Wassau/G1_Project_Rover2026/MODELOS COMPONENTES COMERCIALES/Seta Emergencia/E-Stop Yellow Ring Label.JPG

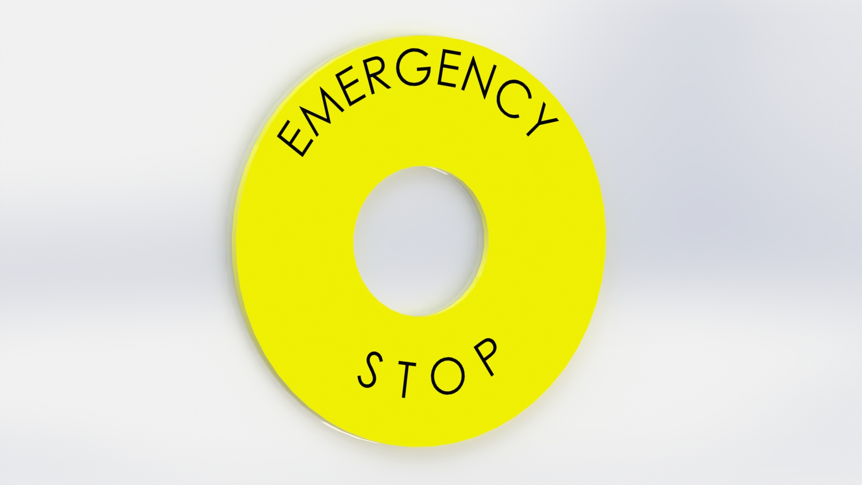
MODELOS COMPONENTES COMERCIALES/Seta Emergencia/E-Stop Yellow Ring Label.JPG
