Wassau/G1_Project_Rover2026/MODELOS COMPONENTES COMERCIALES/rc-short-course-tire-rim-1-10-scale-off-road-12mm-hex-1.snapshot.1/wheel.jpg

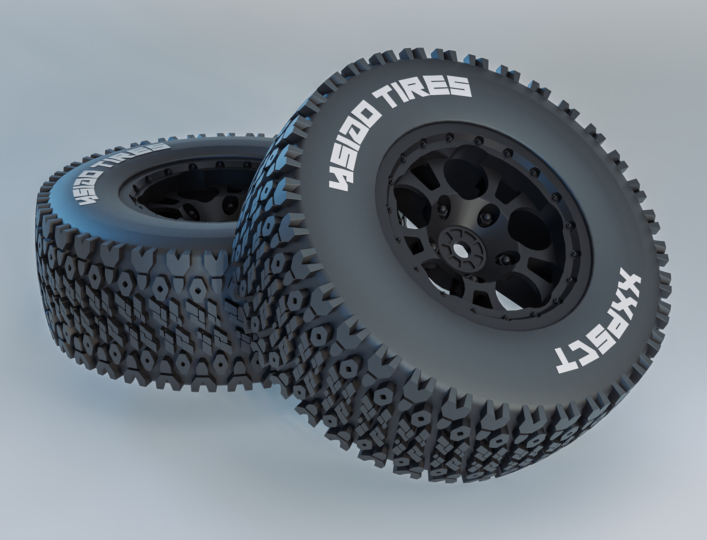
MODELOS COMPONENTES COMERCIALES/rc-short-course-tire-rim-1-10-scale-off-road-12mm-hex-1.snapshot.1/wheel.jpg
