Wassau/G1_Project_Rover2026/README.md

# G1_Project_Rover2026
Diseños, código y espacio colaborativo para acceder a los archivos de trabajo en el proyecto del curso
