Wassau/G1_Project_Rover2026/GrupoDirección/Sintesis Direccion Optimizada/Modelado, síntesis y simulación-20260307/Síntesis dimensional/Síntesis dimensional de robot antropomórfico paralelo.pdf

# Síntesis dimensional de robot antropomórfico paralelo

## Desarrollo de Prototipo Mecatrónico (DPM)

## Máster en Mecatrónica

EU4M Master in Mechatronic and Micro-Mechatronic Systems

Álvaro Noriega González | 2

## INDICE

## 1. Especificaciones 2. Síntesis dimensional 3. Manipulabilidad

## 1. Especificaciones

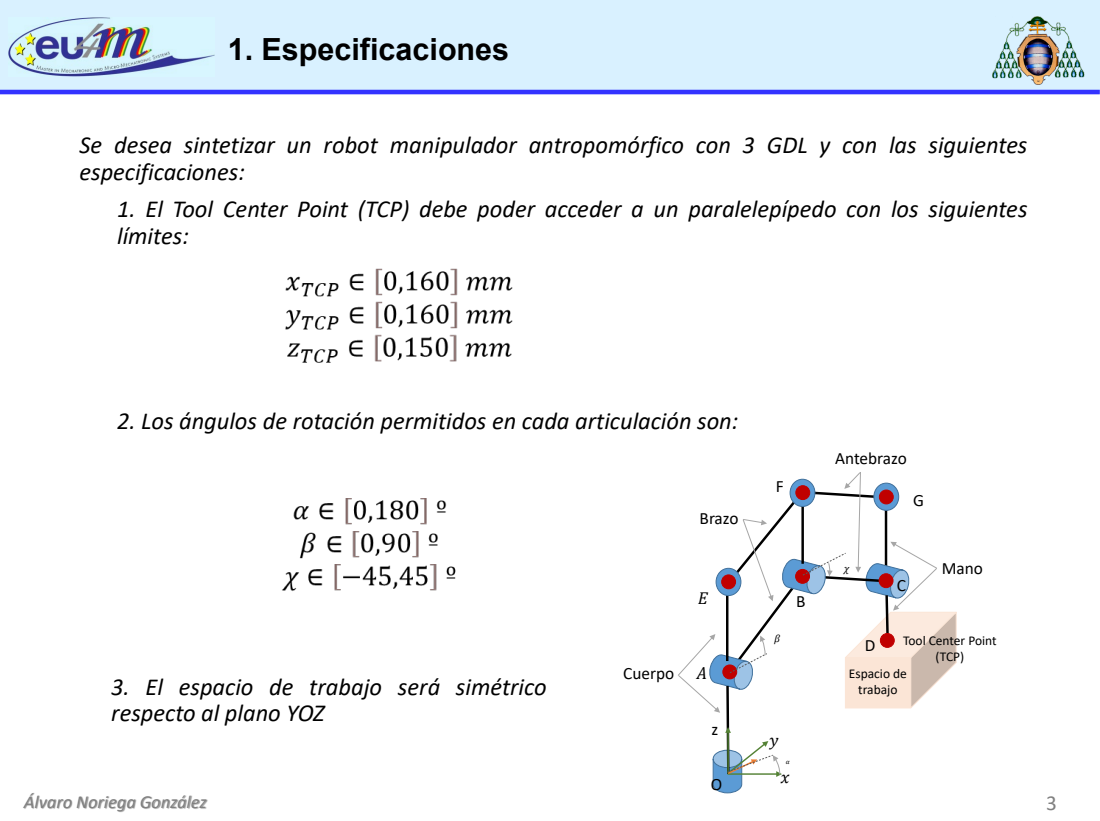
[picture p16: page 3]
Espacio de trabajo; Cuerpo; Brazo; Antebrazo; Mano

Se desea sintetizar un robot manipulador antropomórfico con 3 GDL y con las siguientes
especificaciones:
1. El Tool Center Point (TCP) debe poder acceder a un paralelepípedo con los siguientes
límites:

2. Los ángulos de rotación permitidos en cada articulación son:

Tool Center Point
(TCP)

3. El espacio de trabajo será simétrico
respecto al plano YOZ

El robot manipulador tipo antropomórfico tiene la particularidad de que los eslabones principales que forman el brazo están contenidos todos en el mismo plano de trabajo. Por tanto, se puede tratar como un mecanismo plano contenido en dicho plano, lo cual simplifica considerablemente la síntesis cinemática del mismo.

## 2. Síntesis dimensional

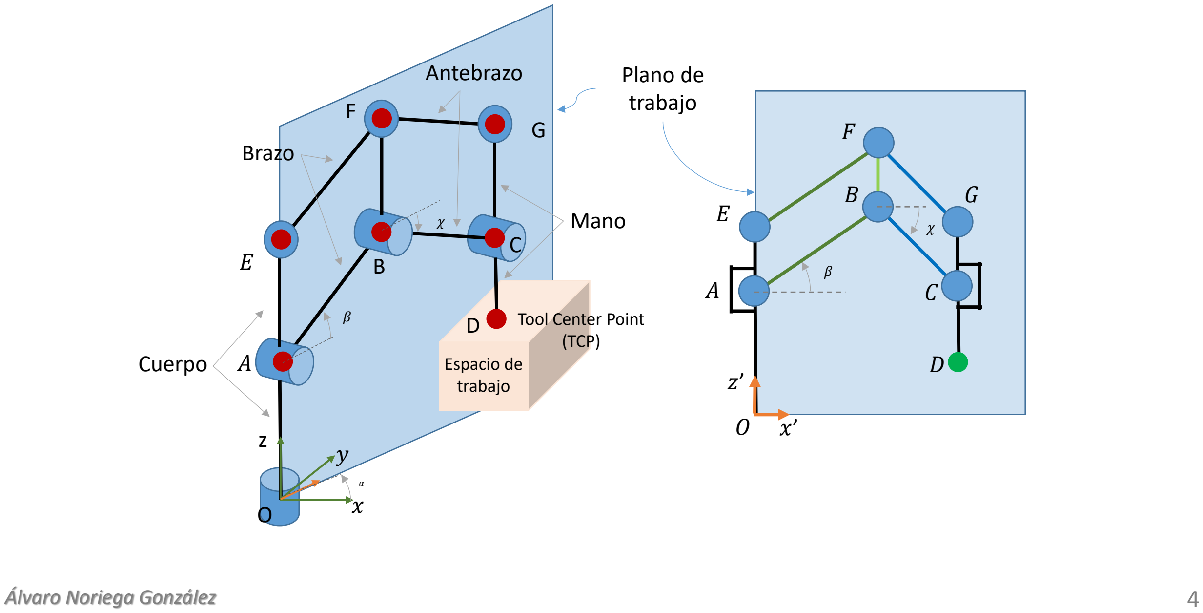
[picture p17: figure]
Plano de trabajo; Tool Center Point (TCP); Espacio de trabajo; Cuerpo; Brazo; Antebrazo; Mano

La estrategia para realizar la síntesis dimensional (es decir, para determinar las dimensiones principales del mecanismo), es la siguiente:

## 2. Síntesis dimensional

“Obtener unas dimensiones para las barras OA,
AB=EF, BC=FG y DC tales que el manipulador pueda acceder a todos los puntos del espacio de trabajo objetivo en unas condiciones de trabajo óptimas”

Pero ¿Qué son unas condiciones de trabajo óptimas?

Cuando se trabaja con robots manipuladores, es esencial analizar su cinemática para determinar ciertos parámetros de funcionalidad, denominados índices de comportamiento cinemático (ICC) → concepto de elipsoide de manipulabilidad

Yoshikawa, T., Foundations of Robotics (http://www.amazon.es/Foundations-Robotics-Analysis-Tsuneo-Yoshikawa/dp/0262514583) , Cambridge : The MIT Press, 1990. p 127-154

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
Plano de
trabajo

Manipulabilidad: “Capacidad de cambio en posición y orientación del efector final de un sistema robótico en una configuración dada”

## 3. Manipulabilidad

La manipulabilidad puede tener enfoque cinemático o dinámico aunque a continuación se va a hablar del enfoque cinemático, que es más sencillo.

A nivel cinemático se puede escribir lo siguiente:

q | Jq | out | in
= ⋅

Velocidades en el
efector

Matriz jacobiano
del robot

Velocidades
articulares

D

out | D
| D

x
y
z
=

q

siendo:

in

α
β
χ
δ
ε
= =
q | | z

La manipulabilidad se puede ver como un elipsoide n-dimensional (elipsoide de manipulabilidad) que responde a la siguiente ecuación:

Este elipsoide representa a todas las velocidades realizables por el efector final del robot y cuyo módulo es menor o igual a la unidad.

1 T

out | out qq | ⋅ | ≤

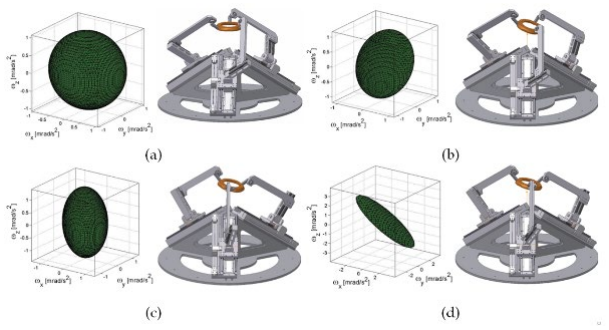
[picture p18: figure]

Las características de este elipsoide dependen del robot, de sus dimensiones y de la posición que adopta el mismo → permite comparar diferentes posiciones e incluso diferentes robots

La capacidad de movimiento es máxima en la dirección del semieje mayor y así
sucesivamente hasta el
semieje más pequeño

El cálculo del elipsoide de manipulabilidad es complejo y, por eso, interesa buscar una alternativa → calcular solo la dirección y valor de los semiejes del elipsoide.

[ | ] | () | T U S V | J | J USV = | → = ⋅⋅ svd

Para calcular los semiejes, se hace la descomposición de la matriz jacobiano en valores singulares (SVD)

siendo
1 | 00
0 | 0
0 0 | n

σ

σ

= | |
S | | Matriz diagonal cuya traza son los valores singulares

Y los semiejes del elipsoide de manipulabilidad
1 | 1, σ | σ n | n ⋅ | ⋅ U | U | donde | son las columnas de la matriz Ui | U
σ | λ i | i
= | siendo los autovalores de la matriz J λi

Al cociente

max | max
min | min

k

λ | λ
λ | λ
= | =

Se le llama número de condición de la matriz y cuanto más cercano esté a la unidad, más parecido será el elipsoide de manipulabilidad a una esfera.

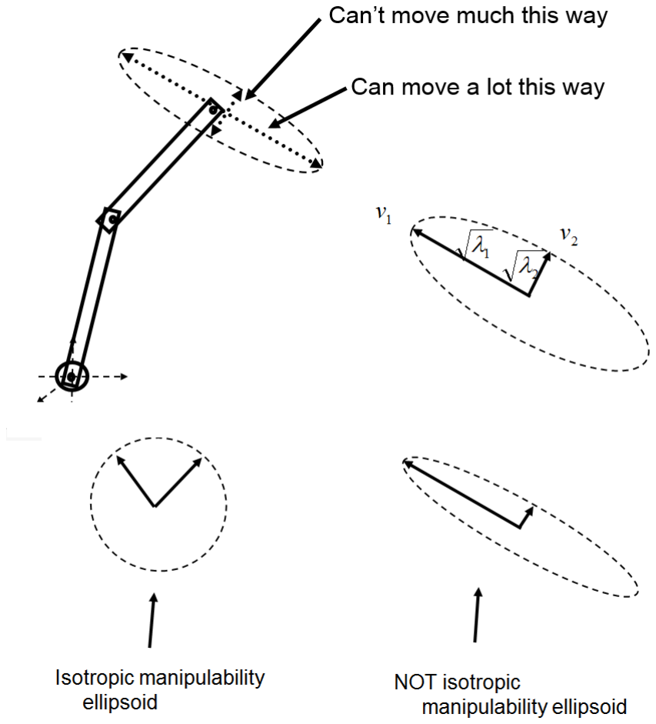
[picture p19: figure]

Visto esto, se puede concluir que interesa
conseguir que la matriz S sea una matriz lo
más cercana posible a la matriz identidad I.

Adicionalmente, si un autovalor se hace 0, la matriz se vuelve singular (caso extremo de matriz malcondicionada).

Teniendo en cuenta el significado físico de los valores singulares, se pueden plantear los siguientes Índices de Comportamiento Cinemático del manipulador:

min
1
max

MI σ
σ

=

M 2 | min I =σ
M | i 3 | n
i

I = ∏σ

Razón de longitudes mínima y máxima de los semiejes del elipsoide. Varía entre 0 y 1. Cuanto más cercana a 1, mejor

Longitud del semieje más corto. Permite analizar el límite inferior de la velocidad a la cual puede moverse el efector final en una cierta dirección (la más desfavorable)

Media geométrica del producto → radio de la esfera cuyo volumen es igual al del elipsoide

Bien, pero … ¿Cómo se construye la matriz J?

### q Rz = ⋅

En dinámica se usa un concepto llamado matriz R:

Si se aplica un filtro mediante una matriz booleana para obtener las entradas y las salidas del robot:

q | Hq | out | out
= | ⋅ | q Hqz | in | in
= | ⋅=

Entonces:
q | H q H Rz out | out
= | ⋅= | ⋅⋅
out | |

Y la matriz R se construye por columnas, aplicando la condición de que el campo de velocidades del robot es combinación lineal de los campos de velocidades correspondientes a cada velocidad articular.

Para el caso del manipulador antropomórfico, solo habría que situar al robot para que tenga un comportamiento simétrico en el espacio de trabajo definido:

### 75 Ox mm =

Y el resto de las dimensiones principales, seleccionarlas a tanteo haciendo que el TCP recorra las fronteras del espacio de trabajo y viendo el valor que toman los ICC:

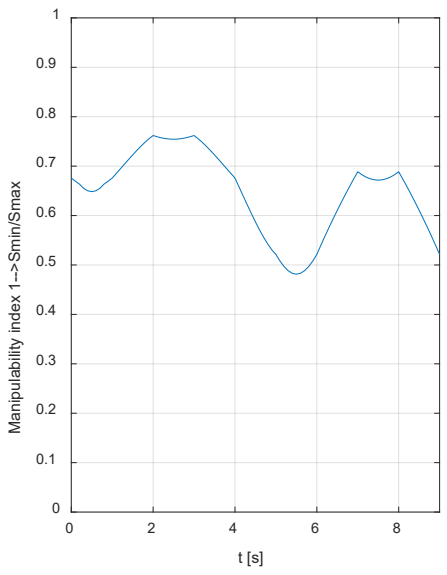
[picture p20: figure]
Manipulability index 1-->Smin/Smax
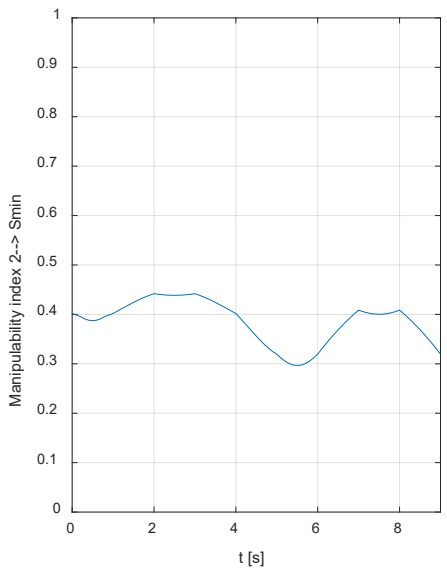
[picture p21: figure]
Manipulability index 2--> Smin
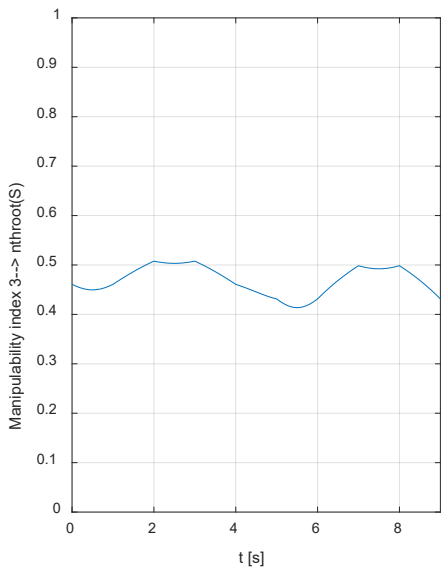
[picture p22: figure]
Manipulability index 3--> nthroot(S)

y los ángulos que giran las articulaciones:

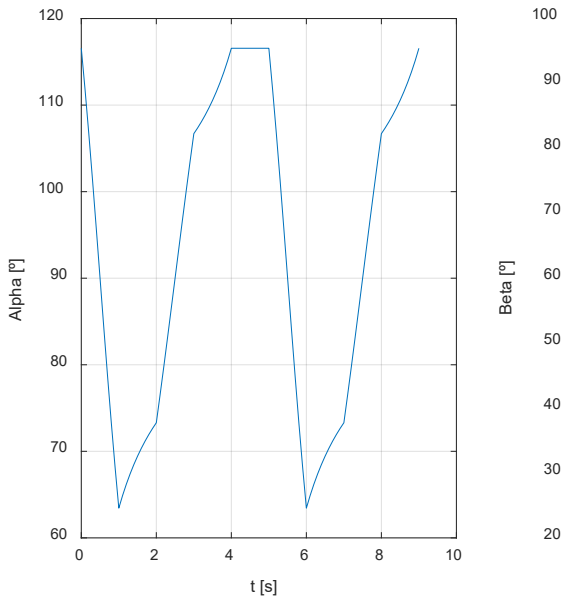
[picture p23: figure]
Alpha [º]; Beta [º]
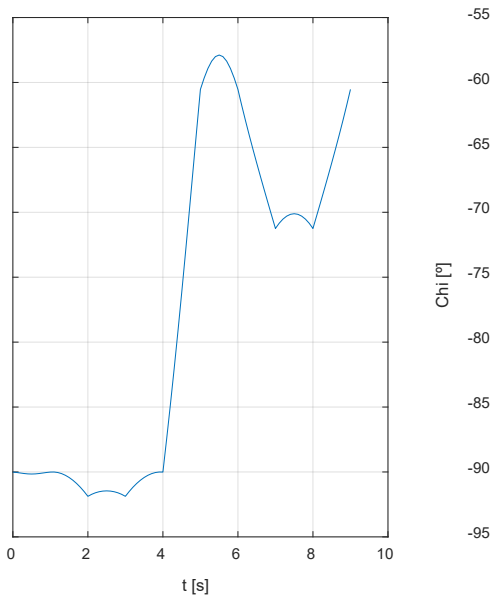
[picture p24: figure]
Chi [º]
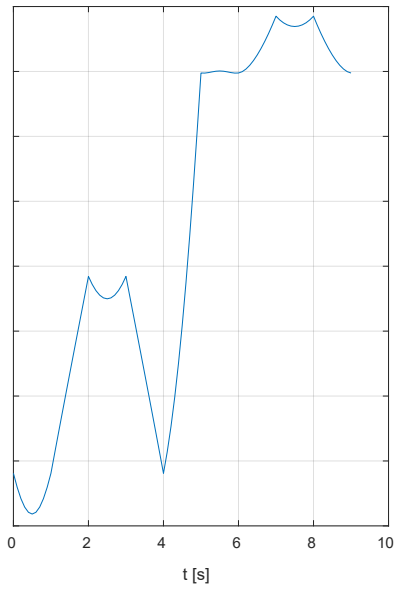
[picture p25: figure]
