Wassau/G1_Project_Rover2026/GrupoChasis/.DATASHEETS/Electronica/Batería.png

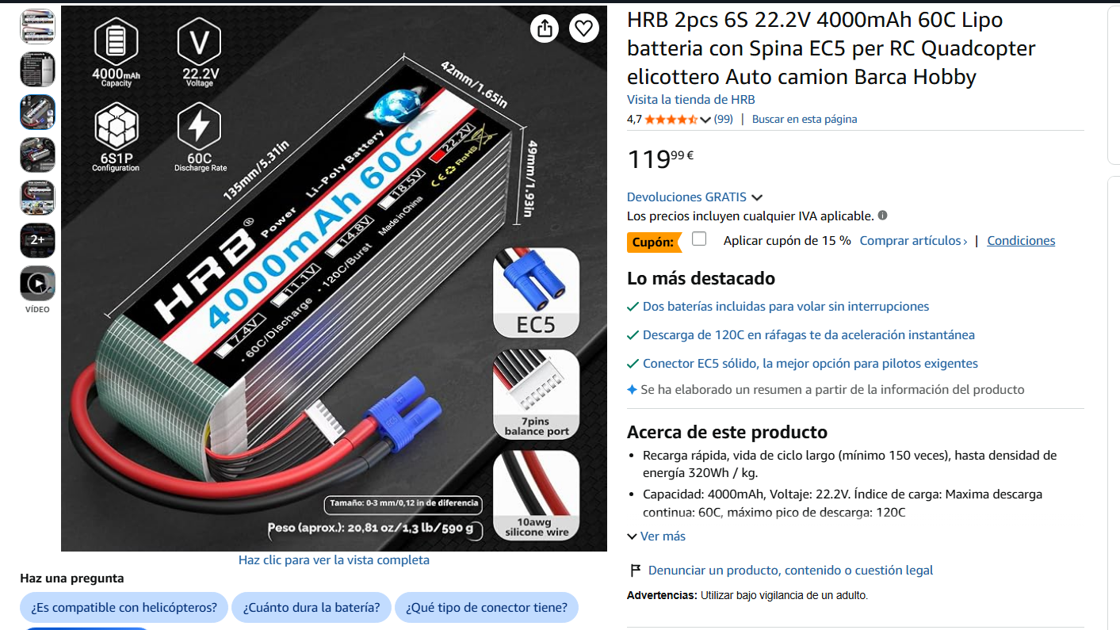
GrupoChasis/.DATASHEETS/Electronica/Batería.png
