Wassau/G1_Project_Rover2026/GrupoChasis/.DATASHEETS/Electronica/SxG.jpg

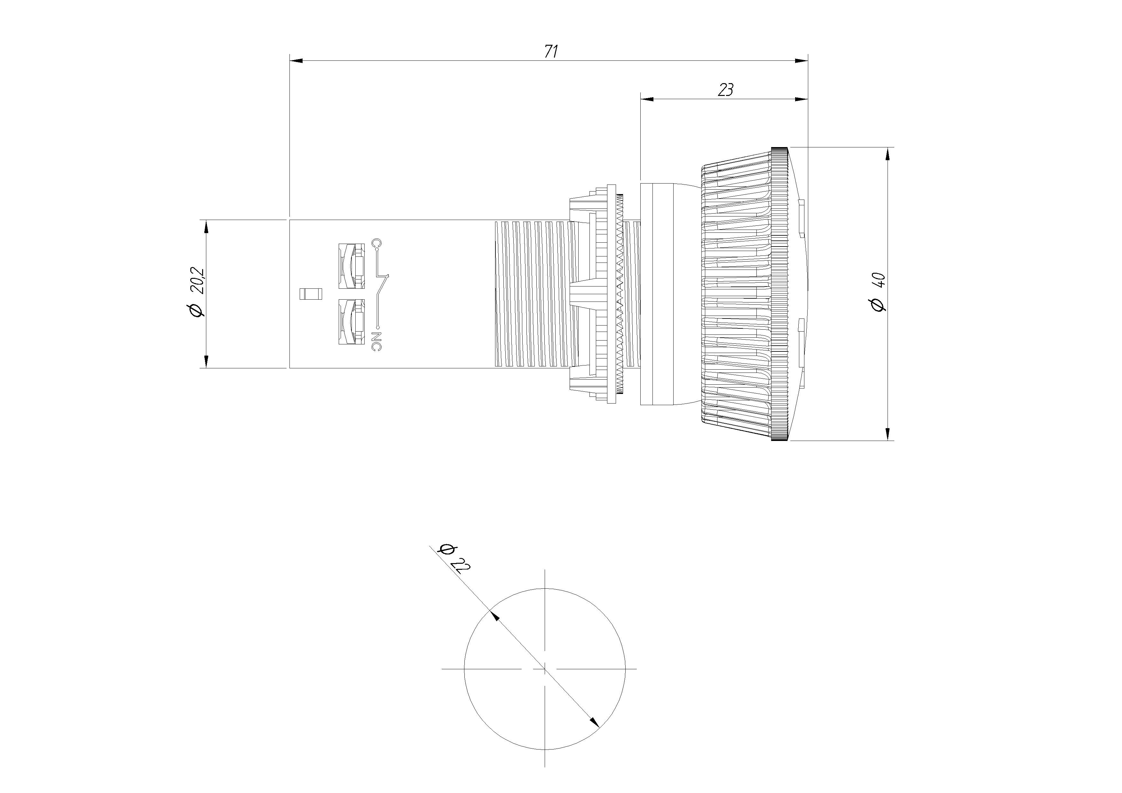
GrupoChasis/.DATASHEETS/Electronica/SxG.jpg
