Wassau/G1_Project_Rover2026/GrupoDirección/Diseñov3/robotics-wheel-1.snapshot.4/Wheel's Rubber.jpg

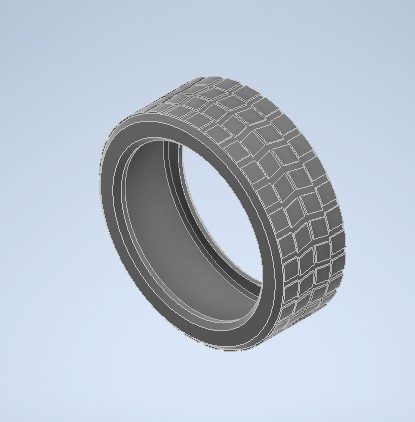
GrupoDirección/Diseñov3/robotics-wheel-1.snapshot.4/Wheel's Rubber.jpg
