Wassau/G1_Project_Rover2026/GrupoDirección/Diseñov3/servo-ds3218mg-2.snapshot.4/Snímání-2.jpg

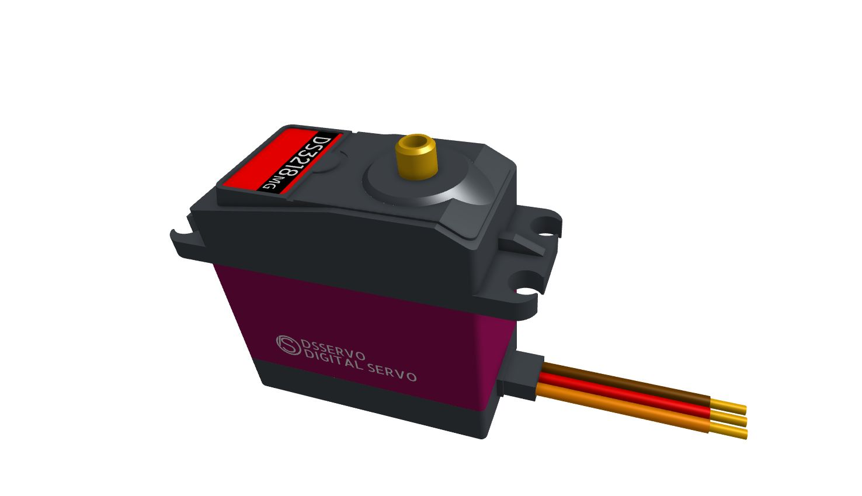
GrupoDirección/Diseñov3/servo-ds3218mg-2.snapshot.4/Snímání-2.jpg
