Wassau/G1_Project_Rover2026/GrupoDirección/Diseñov6/servo-ds3218mg-2.snapshot.4/Snímání-3.jpg

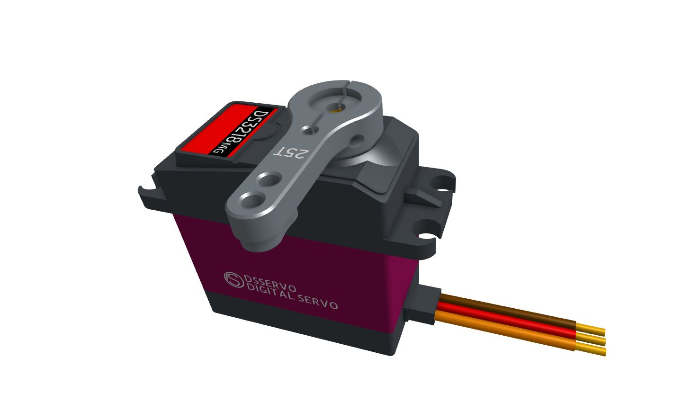
GrupoDirección/Diseñov6/servo-ds3218mg-2.snapshot.4/Snímání-3.jpg
