Wassau/G1_Project_Rover2026/GrupoDirección/Diseñov12/servo-ds3218mg-2.snapshot.4/Snímání-1.jpg

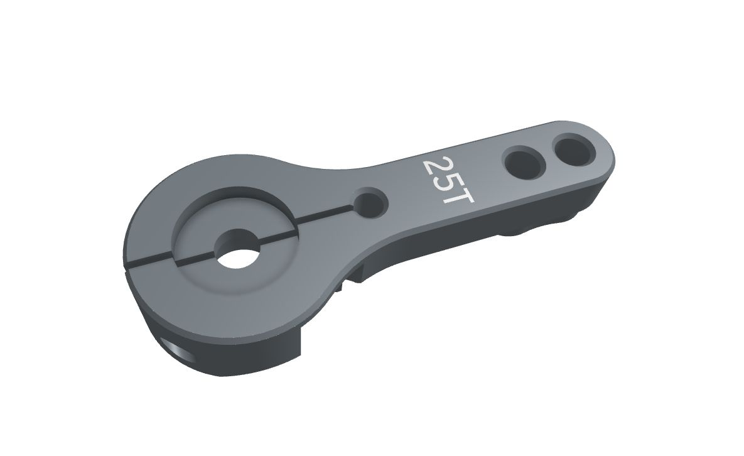
GrupoDirección/Diseñov12/servo-ds3218mg-2.snapshot.4/Snímání-1.jpg
