Wassau/G1_Project_Rover2026/GrupoDirección/Diseñov12/traxxas-1942-long-rod-end-1.snapshot.2/Traxxas 1942 Long Side.jpg

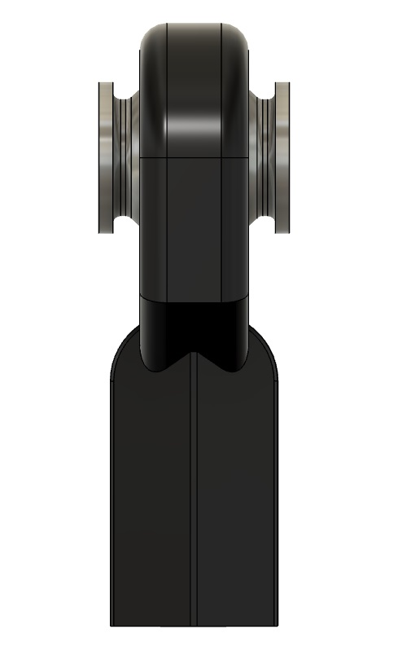
GrupoDirección/Diseñov12/traxxas-1942-long-rod-end-1.snapshot.2/Traxxas 1942 Long Side.jpg
