Wassau/G1_Project_Rover2026/Materiales_G1.xlsx

 | Adquisición de componentes y materiales (2026-27)
 | Componente | Proveedor | Ref. Proveedor | Unidades | Precio Unit. (sin IVA) | Total (sin IVA) | Comprar |  | Diferenciales | Proveedor | Ref. Proveedor | Precio Unit.
 | Rodamiento de bolas 6x13x5mm | RS | 612-5824 | 4 | 6.79 | 27.14 | NO | GRUPO SENSOR | Engranaje Diferencial RC para Modelos Coche 1/18 | Amazon | Modelo 1 (https://www.amazon.es/gp/product/B0FNNN2325/ref=ox_sc_act_title_6?smid=ADFRM2EOXAU5Z&psc=1) | 22.19 €
 | Polea sincrona paso 3mm, 16 dientes, eje 4mm , ancho 9mm | RS | 146-5383 | 2 | 11.28 | 22.56 | NO |  | Hosim Engranaje diferencial de coche a escala 1:8 1:10 | Amazon | Modelo 2 (https://www.amazon.es/gp/product/B0DHKW2YY6/ref=ox_sc_act_title_5?smid=A1BSRVY15WZY1V&psc=1) | 24.99 €
 | Acoplamiento flexible dext 16 mm, d1 6mm, d2 6mm. | RS | 693-2470 | 1 | 34.85 | 34.85 | NO |  | Irfora Diferencial Central RC para Modelos de Coches RC a Escala 1/8 (48T) | Amazon | Modelo 3 (https://www.amazon.es/gp/product/B0HG4KSMJ9/ref=ox_sc_act_title_1?smid=A1F89FIHKMT39O&psc=1) | 23.99 €
 | Correa síncrona paso 3 mm, 48 dientes, Long 144mm, A 9mm | RS | 182-1316 | 1 | 4.64 | 4.64 | NO
 | Tornillos autoroscantes M3 (mirar en almacen) | RS |  | 4 |  | 0.00
 | Prisioneros M3X8 (mirar en almacen) | RS | 287-4059 | 5 | 0.05 | 0.26
 | Cirplip diámetro del eje 6mm (mirar en almacen) | RS | 289-219 | 2 | 0.12 | 0.24
 | Tornillo Allen M3x20 DIN912 | RS | 304-4429 | 1 | 0.58 | 0.58 | NO
 | Tornillo Allen M4x12 DIN912 | RS | 474-5325 | 4 | 0.38 | 1.51 | NO
 | Tuerca M4 DIN934 | RS | 474-5327 | 4 | 0.10 | 0.39 | NO
 | Tuerca M3 DIN934 | RS | 560-293 | 1 | 0.03 | 0.03 | NO
 | Tornillo Allen M3x12 DIN912 | RS | 474-5329 | 2 | 0.03 | 0.07 | NO
 | Tornillo Allen M2x12 DIN912 | RS | 293-296 | 8 | 1.18 | 9.44 | NO
Tracción / Chasis | Correa síncrona paso 5 mm, 40 dientes, Long=200mm, A=10mm | RS | 474-5319 (https://es.rs-online.com/web/p/correas-de-distribucion/4745319?searchId=60a0deb6-f133-4e29-a061-2dbfdf4cf386) | 1 | 10.75 | 10.75 | NO | GRUPO CHASIS
Tracción / Chasis | Correa síncrona paso 5 mm, 68 dientes, Long=340mm, A=10mm | RS | 474-5320 | 1 | 11.66 | 11.66 | NO
Tracción / Chasis | Polea síncrona paso 5 mm, 12 dientes, eje=5mm, A=10mm | RS | 474-5321 | 2 | 14.26 | 28.52 | NO
Tracción / Chasis | Polea síncrona paso 5 mm, 18 dientes, eje=6mm, A=10mm | RS | 474-5322 | 2 | 20.65 | 41.30 | NO
Tracción / Chasis | Rodamiento bolas Dint=8 mm, Dext=22 mm, e=7 mm (608-2RS) | RS | 474-5323 | 4 | 1.69 | 6.76 | NO
Tracción / Chasis | Ruedas RC 1/8" amarillas (Diám. 112 mm) (incluido buje y tuerca) | Amazon | 474-5324 | 1 pack (4 unid.) | 54.61 | 54.61 | NO
Tornillería / Chasis | Tornillo Allen M4x12 DIN 912 | RS | 474-5325 | 40 | 0.38 | 15.14 | NO
Tornillería / Chasis | Tornillo Allen M4x16 DIN 912 | RS | 474-5326 | 8 | 0.40 | 3.17 | NO
Tornillería / Chasis | Tuerca DIN 934 M4 | RS | 474-5327 | 55 | 0.10 | 5.31 | NO
Tornillería / Chasis | Arandela DIN 125 M4 | RS | 474-5328 | 8 | 0.02 | 0.18 | NO
Tornillería / Chasis | Tornillo Allen M3x12 DIN 912 | RS | 474-5329 | 35 | 0.39 | 13.66 | NO
Tornillería / Chasis | Tuerca DIN 934 M3 | RS | 474-5330 | 24 | 0.03 | 0.79 | NO
Tornillería / Chasis | Tuerca DIN 934 M8 | RS | 192-5604 (https://es.rs-online.com/web/p/tuercas-hexagonales/1925604) | 2 | 0.13 | 0.27 | NO
Tornillería / Chasis | Distanciador roscado hexagonal Hembra/Hembra, M4, long. 80mm, Acero | RS-PRO | 176-8430 (https://es.rs-online.com/web/p/separadores/1768430) | 4 | 1.46 | 5.83 | NO
Tornillería / Chasis | Tornillo Allen M4x25 DIN 912 | RS | 187-1285 (https://es.rs-online.com/web/p/tornillos-allen/1871285?gb=a) | 6 | 0.09 | 0.51 | NO
Chasis | Chapa aluminio 3 mm | RS | 474-5333 | 2 | 31.00 | 62.01
 |  |  |  |  |  | 0.00
 | Rodamiento 626-2RS (Dext = 19mm, Dint = 6mm) | RS | 618-9913 | 6 | 1.94 | 11.64 | SÍ | GRUPO DIRECCIÓN
 | Tornillo Allen M2.5x20 DIN912 (ver Almacén) | RS |  | 2 |  | 0.00
 | Tuerca M2.5 ISO 934 | RS | 560-287 | 2 | 0.03 | 0.06 | NO
 | Tornillo Allen M3x12 DIN912 (ver Almacén) | RS | 281-007 | 12 | 0.39 | 4.68
 | Tuerca M3 ISO 934 | RS | 560-293 | 8 | 0.03 | 0.24 | NO
 | Tornillo Allen M4x16 DIN912 (ver Almacén) | RS | 281-041 | 4 | 0.40 | 1.58
 | Tuerca M4 ISO 934 | RS | 189-579 | 4 | 0.10 | 0.40 | NO
 | Tuerca M6 ISO 934 | RS | 189-591 | 4 | 0.13 | 0.52 | NO
 | Separador roscado H-H M3 40mm | RS | 176-8338 | 4 | 0.71 | 2.84 | NO
 | Varilla roscada Inox M3 1m | RS | 280-363 | 1 | 5.25 | 5.25 | NO
 | Casquillo de fricción (Dint = 3mm, Dext = 4.5mm) | RS | 272-4527 | 4 | 0.53 | 2.12 | NO
 |  |  |  |  | Total (sin IVA): | 391.50 €
