Wassau/G1_Project_Rover2026/GrupoChasis/BOM_Chasis_v1.xls

Tabla de LDM
N.º DE ELEMENTO | N.º DE PIEZA | DESCRIPCIÓN | CANTIDAD
1 | 01_Chasis_ChapaBa se_V02 |  | 1
2 | 01_Chasis_ChapaSu perior |  | 1
3 | 01_Chasis_MarcoCar casa |  | 1
4 | DB42Sxx.stp |  | 2
5 | GP42-N2-XX-SRR_V02 |  | 2
6 | 21 T5 _ 12-2 |  | 2
7 | 21 T5 _ 18-2 |  | 2
8 | Bateria |  | 1
9 | Eje_Rueda |  | 2
10 | Correa3- 5^01_Chasis_Ensam blaje_V07 |  | 1
11 | CAA-608ZZ-JJ |  | 4
12 | Rueda_Buje |  | 2
13 | DIN 912 M4 x 16 --- 16N |  | 8
14 | 01_Chasis_SoporteB ateria_V02 |  | 1
15 | DIN 912 M3 x 12 --- 12N |  | 35
16 | Soporte_EjeRueda_V 02 |  | 2
17 | DIN 912 M4 x 12 --- 12N |  | 37
18 | llanta_1_8_aprox |  | 2
19 | neumatico_1_8_apr ox |  | 2
20 | 01_Chasis_SoporteR eductora_Base_V03 |  | 1
21 | BS EN 24032 - M4 - W - N |  | 1
22 | 01_Chasis_SoporteR eductora_Brida_V03 |  | 4
23 | 01_Chasis_Guia_Sop orteReductora_V05 |  | 4
24 | 01_Chasis_SoporteR eductora_Base_M2_ V03 |  | 1
25 | BS EN 24035 - M12 - N |  | 2
26 | 01_Chasis_Puerta_Tr asera |  | 1
27 | 01_Chasis_Puerta_La teral |  | 1
28 | 01_Chasis_Puerta_Fij o_Lateral |  | 1
29 | Simetría01_Chasis_P uerta_Lateral |  | 1
30 | Simetría01_Chasis_P uerta_Fijo_Lateral |  | 1
31 | Correa4- 1^01_Chasis_Ensam blaje_V07 |  | 1
32 | 01_Chasis_bisagra_A |  | 6
33 | 01_Chasis_bisagra_B |  | 6
34 | PCB_FPGA |  | 1
35 | PCB_Alim |  | 1
36 | Controladora |  | 2
37 | Carcasa_Raspberry |  | 1
38 | Router |  | 1
39 | FPGA |  | 1
40 | DIN 912 M4 x 25 --- 25N |  | 6
41 | BS EN 24032 - M4 - D - N |  | 46
42 | Separador_Hexagon al |  | 4
43 | BS EN 24032 - M3 - D - N |  | 16
44 | BS EN 24032 - M8 - D - N |  | 2
45 | Washer ISO 7089 - 4 |  | 8
