Wassau/G1_Project_Rover2026/MODELOS COMPONENTES COMERCIALES/hpi-center-differential/Renderings/CENTER DIFF20120220-27696-1p6n2wo.JPG

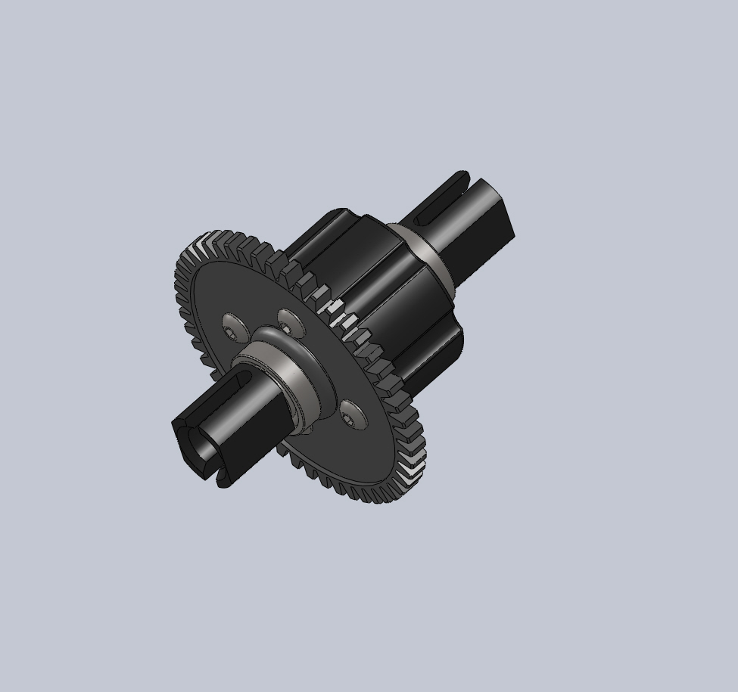
MODELOS COMPONENTES COMERCIALES/hpi-center-differential/Renderings/CENTER DIFF20120220-27696-1p6n2wo.JPG
