Wassau/G1_Project_Rover2026/MODELOS COMPONENTES COMERCIALES/hpi-center-differential/Renderings/CENTER DIFF 2.JPG

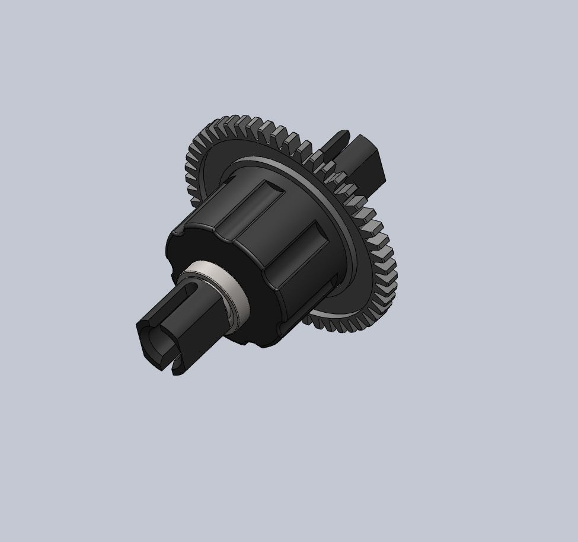
MODELOS COMPONENTES COMERCIALES/hpi-center-differential/Renderings/CENTER DIFF 2.JPG
