Wassau/G1_Project_Rover2026/MODELOS COMPONENTES COMERCIALES/rc-short-course-tire-rim-1-10-scale-off-road-12mm-hex-1.snapshot.1/photo_2025-08-30_18-49-31.jpg

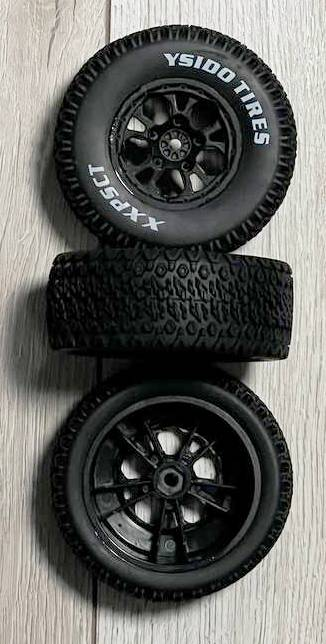
MODELOS COMPONENTES COMERCIALES/rc-short-course-tire-rim-1-10-scale-off-road-12mm-hex-1.snapshot.1/photo_2025-08-30_18-49-31.jpg
