Wassau/G1_Project_Rover2026/MODELOS COMPONENTES COMERCIALES/rs-pro-brass-inserts-1.snapshot.11/Brass insert rendering.png

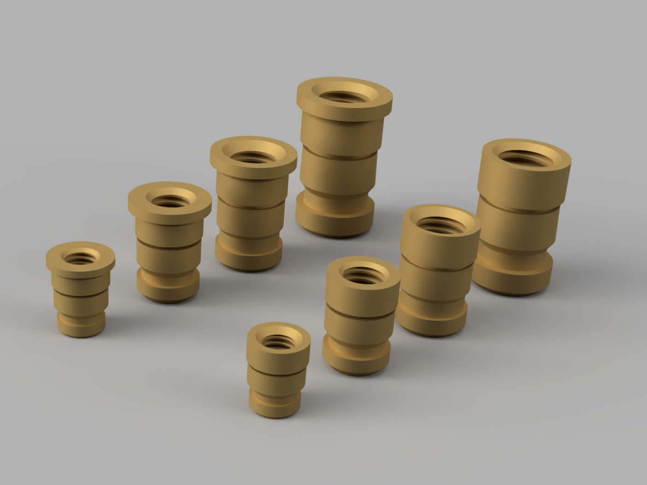
MODELOS COMPONENTES COMERCIALES/rs-pro-brass-inserts-1.snapshot.11/Brass insert rendering.png
