Wassau/G1_Project_Rover2026/GrupoDirección/Diseñov12/RUEDAv3/RUEDAv2/RUEDA.SLDASM

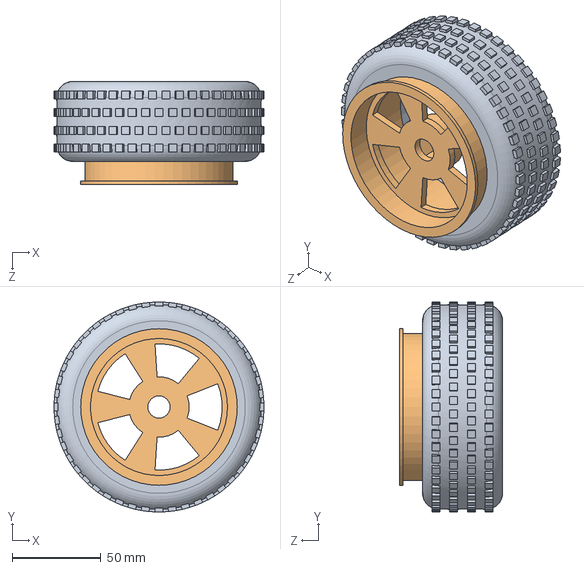
[picture p38: CAD file, 2026-11-04]
GrupoDirección/Diseñov12/RUEDAv3/RUEDAv2/RUEDA.SLDASM
118.0 x 118.0 x 58.0 mm
llanta_1_8_aprox
neumatico_1_8_aprox
