Wassau/G1_Project_Rover2026/MODELOS COMPONENTES COMERCIALES/hpi-center-differential/CENTER DIFF.SLDASM

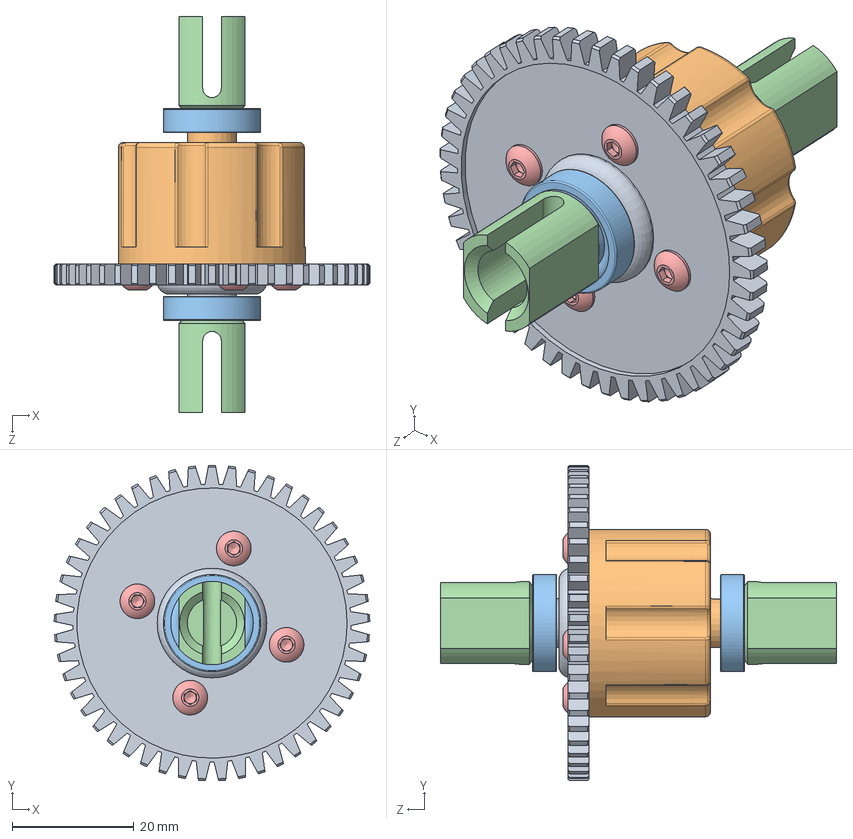
[picture p39: CAD file, 2026-10-13]
MODELOS COMPONENTES COMERCIALES/hpi-center-differential/CENTER DIFF.SLDASM
51.9 x 51.9 x 65.2 mm
SPUR GEAR
DIFF CUP
Instrument Ball Bearing_68_AM x 2
OUTDRIVE x 2
Socket Button Head Cap Screw_AM x 4
