Wassau/G1_Project_Rover2026/MODELOS COMPONENTES COMERCIALES/RUEDAv2/RUEDA.SLDASM

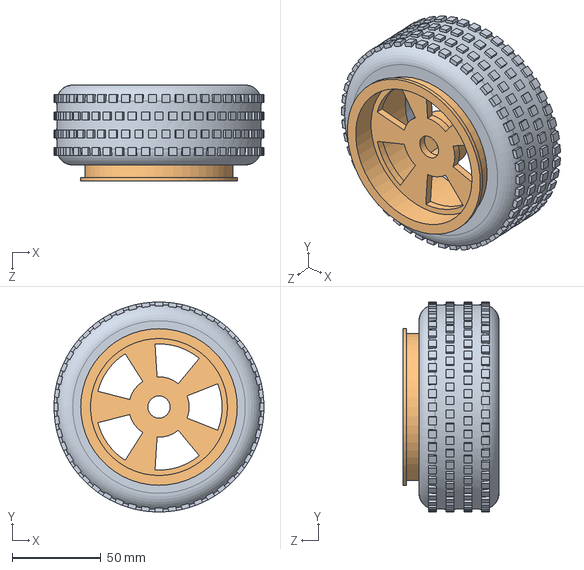
[picture p40: CAD file, 2026-11-05]
MODELOS COMPONENTES COMERCIALES/RUEDAv2/RUEDA.SLDASM
118.0 x 118.0 x 54.0 mm
llanta_1_8_aprox
neumatico_1_8_aprox
