Wassau/G1_Project_Rover2026/GrupoDirección/Diseñov9/RUEDAv2/RUEDA.SLDASM

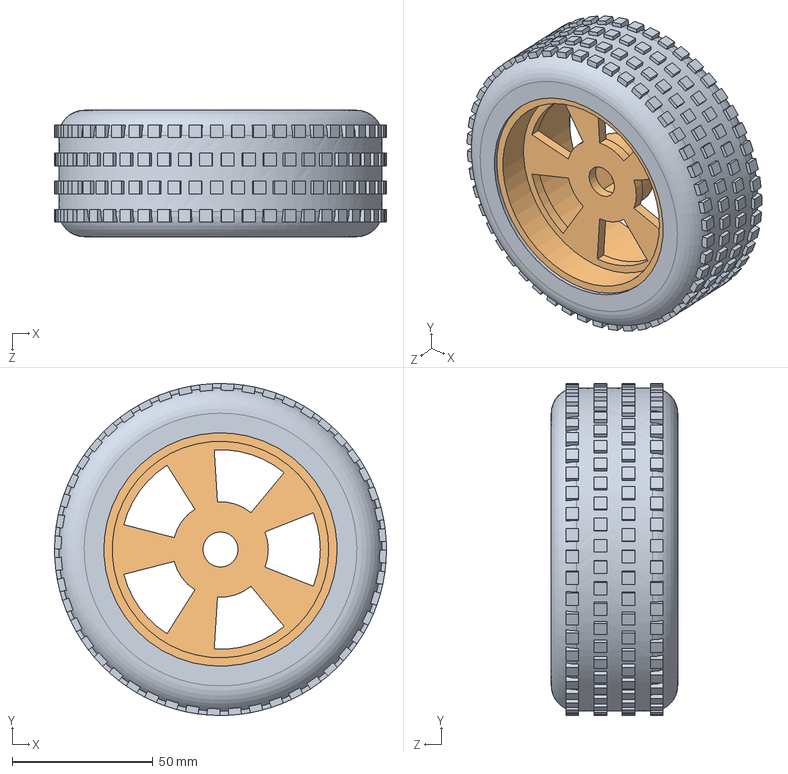
[picture p41: CAD file, 2026-11-03]
GrupoDirección/Diseñov9/RUEDAv2/RUEDA.SLDASM
118.1 x 118.1 x 45.0 mm
llanta_1_8_aprox
neumatico_1_8_aprox
