Wassau/G1_Project_Rover2026/GrupoDirección/Diseñov12/Servofinal.SLDASM

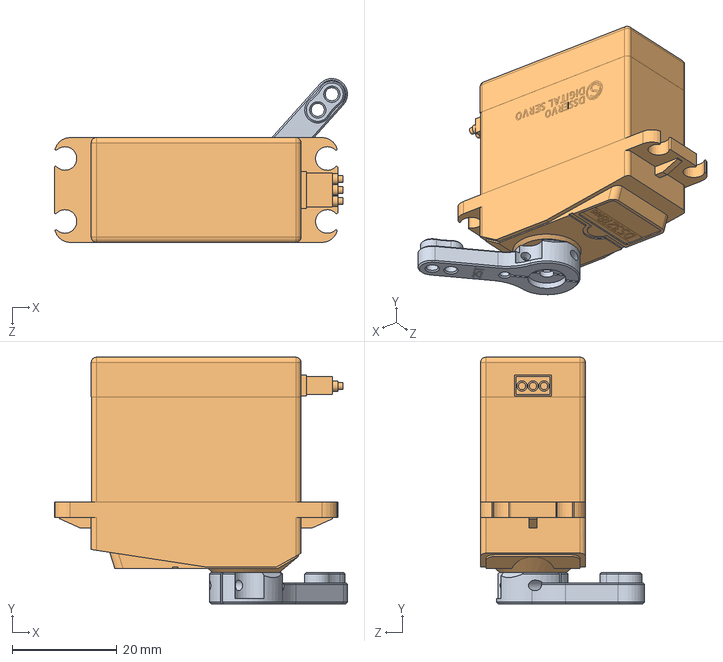
[picture p42: CAD file, 2026-11-05]
GrupoDirección/Diseñov12/Servofinal.SLDASM
55.8 x 47.0 x 31.2 mm
Servo DS3218MG[1]
Lever 25T[1]
