Wassau/G1_Project_Rover2026/GrupoChasis/01_Chasis/.Versiones Anteriores/01_Chasis_EjeTraccion.SLDPRT

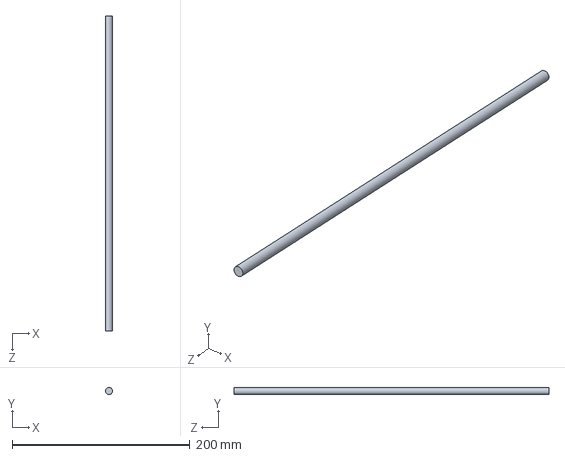
[picture p43: CAD file, 2026-10-27]
GrupoChasis/01_Chasis/.Versiones Anteriores/01_Chasis_EjeTraccion.SLDPRT
8.00 x 7.98 x 354.0 mm
