Wassau/G1_Project_Rover2026/GrupoDirección/Diseñov10/RUEDA/llanta_1_8_aprox.SLDPRT

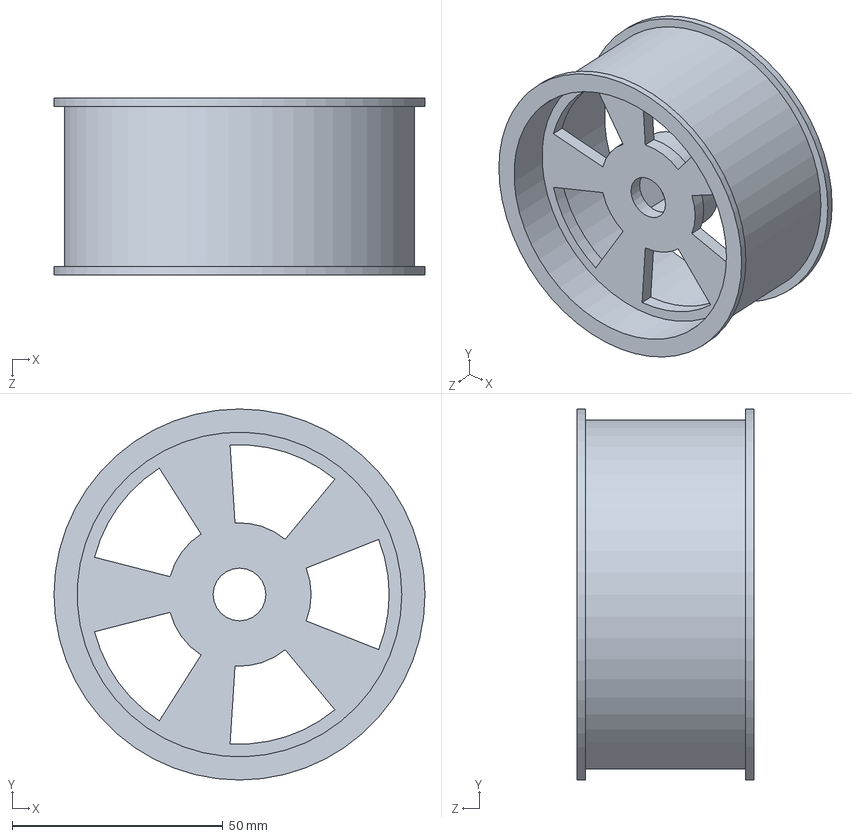
[picture p44: CAD file, 2026-11-03]
GrupoDirección/Diseñov10/RUEDA/llanta_1_8_aprox.SLDPRT
88.0 x 88.0 x 42.0 mm
