Wassau/G1_Project_Rover2026/GrupoDirección/Diseñov11/EjeBalancin.SLDPRT

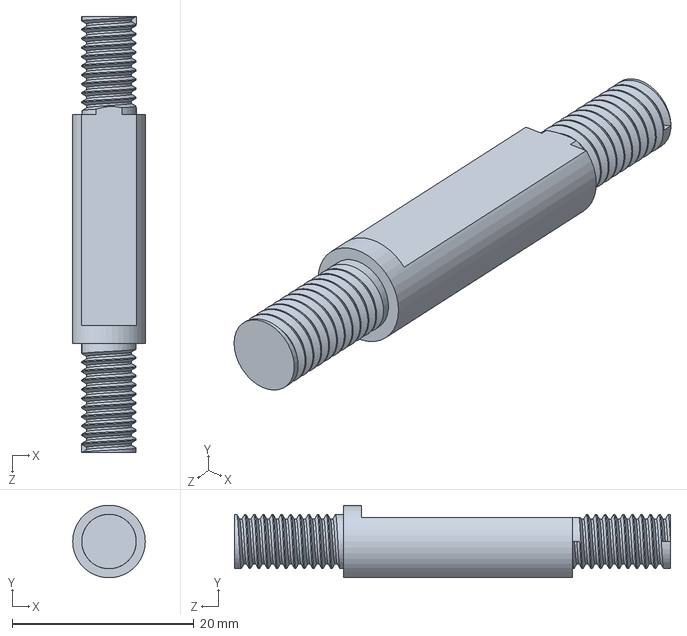
[picture p45: CAD file, 2026-11-04]
GrupoDirección/Diseñov11/EjeBalancin.SLDPRT
8.00 x 7.97 x 48.0 mm
