Wassau/G1_Project_Rover2026/GrupoDirección/Diseñov11/servo-ds3218mg-2.snapshot.4/Part Studio 1.step.SLDPRT

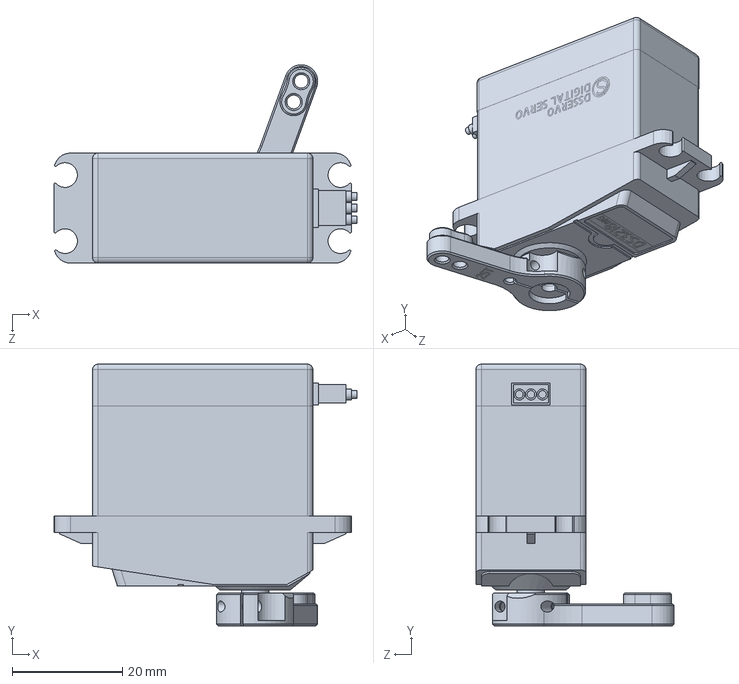
[picture p46: CAD file, 2026-11-04]
GrupoDirección/Diseñov11/servo-ds3218mg-2.snapshot.4/Part Studio 1.step.SLDPRT
55.0 x 47.5 x 36.0 mm
