Wassau/G1_Project_Rover2026/GrupoDirección/Diseñov12/RUEDA/neumatico_1_8_aprox.SLDPRT

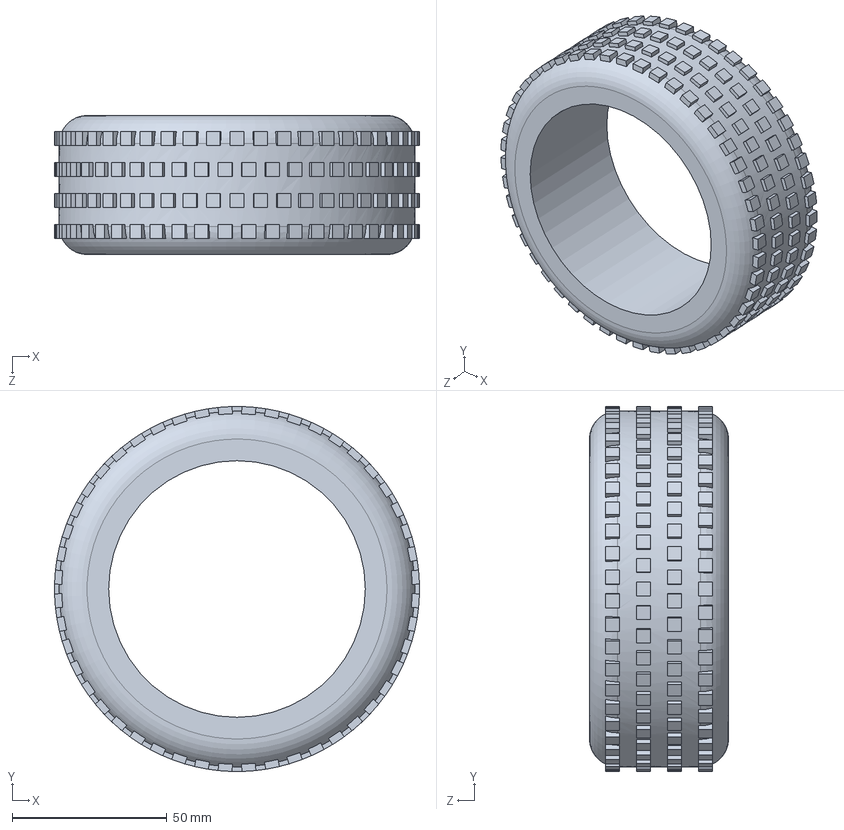
[picture p47: CAD file, 2026-11-04]
GrupoDirección/Diseñov12/RUEDA/neumatico_1_8_aprox.SLDPRT
118.0 x 118.0 x 45.0 mm
