Wassau/G1_Project_Rover2026/GrupoDirección/Diseñov12/RUEDAv2/rueda_1_8_aprox.step

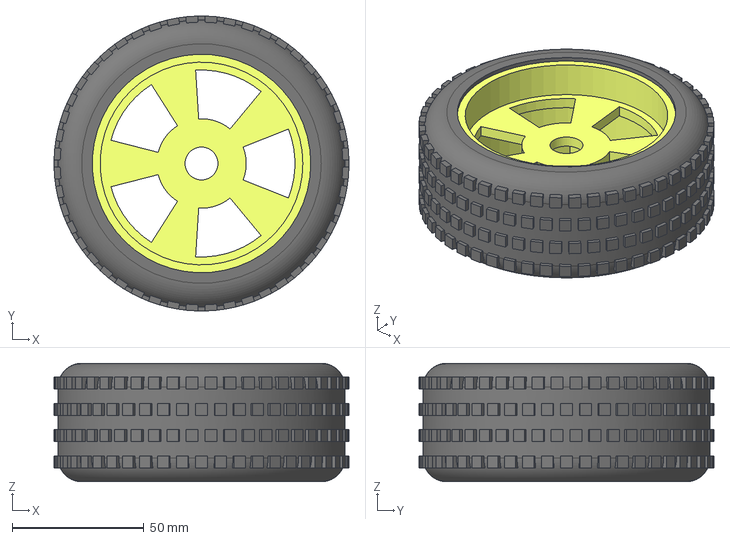
[picture p48: CAD file, 2026-11-04]
GrupoDirección/Diseñov12/RUEDAv2/rueda_1_8_aprox.step
112.1 x 112.1 x 45.0 mm
llanta
neumatico
