Wassau/G1_Project_Rover2026/GrupoDirección/Diseñov12/Servo DS3218MG[1].SLDPRT

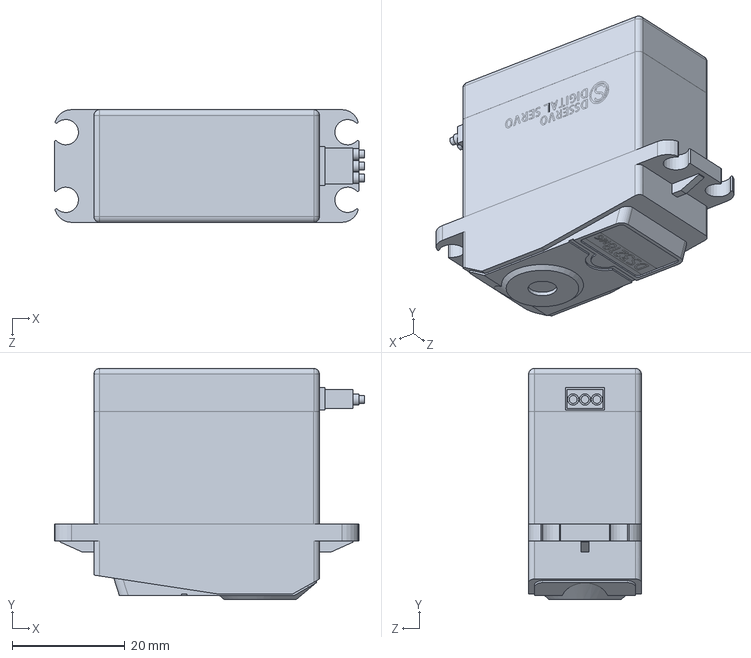
[picture p49: CAD file, 2026-11-05]
GrupoDirección/Diseñov12/Servo DS3218MG[1].SLDPRT
55.0 x 41.0 x 20.0 mm
