Wassau/G1_Project_Rover2026/GrupoDirección/Diseñov12/servo-ds3218mg-2.snapshot.4/Lever 25T[1].SLDPRT

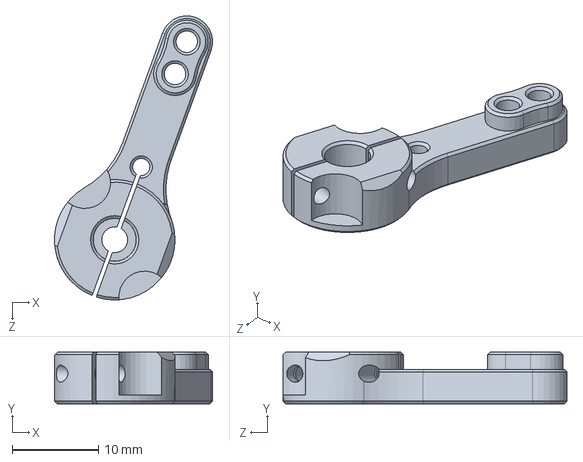
[picture p50: CAD file, 2026-11-04]
GrupoDirección/Diseñov12/servo-ds3218mg-2.snapshot.4/Lever 25T[1].SLDPRT
18.4 x 6.01 x 33.0 mm
