Wassau/G1_Project_Rover2026/GrupoDirección/Diseñov3/RUEDAv2/neumatico_1_8_aprox.SLDPRT

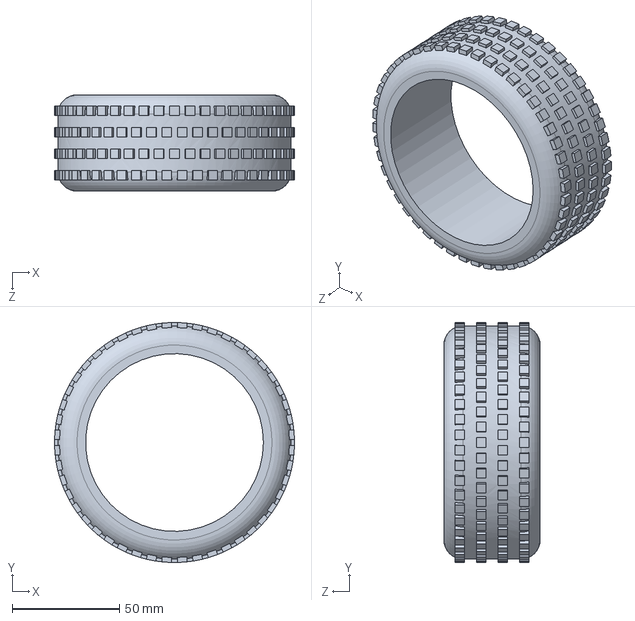
[picture p51: CAD file, 2026-10-27]
GrupoDirección/Diseñov3/RUEDAv2/neumatico_1_8_aprox.SLDPRT
112.1 x 112.1 x 45.0 mm
