Wassau/G1_Project_Rover2026/GrupoDirección/Diseñov8/RUEDAv3/RUEDAv2/llanta_1_8_aprox.SLDPRT

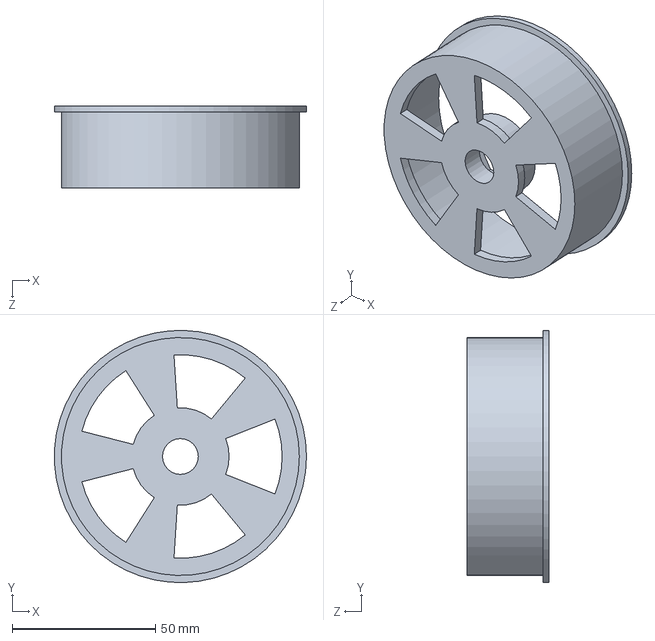
[picture p52: CAD file, 2026-11-02]
GrupoDirección/Diseñov8/RUEDAv3/RUEDAv2/llanta_1_8_aprox.SLDPRT
87.9 x 88.0 x 28.5 mm
