Wassau/G1_Project_Rover2026/GrupoSensor/01Bottom/BaseGiratoriav2.SLDPRT

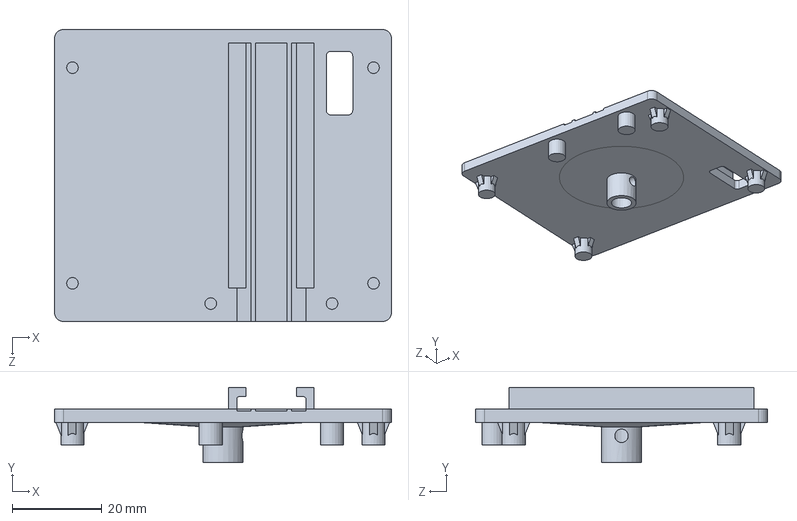
[picture p53: CAD file, 2026-11-04]
GrupoSensor/01Bottom/BaseGiratoriav2.SLDPRT
75.0 x 16.8 x 65.0 mm
