Wassau/G1_Project_Rover2026/GrupoSensor/02Top/AcoplamientoCircular.SLDPRT

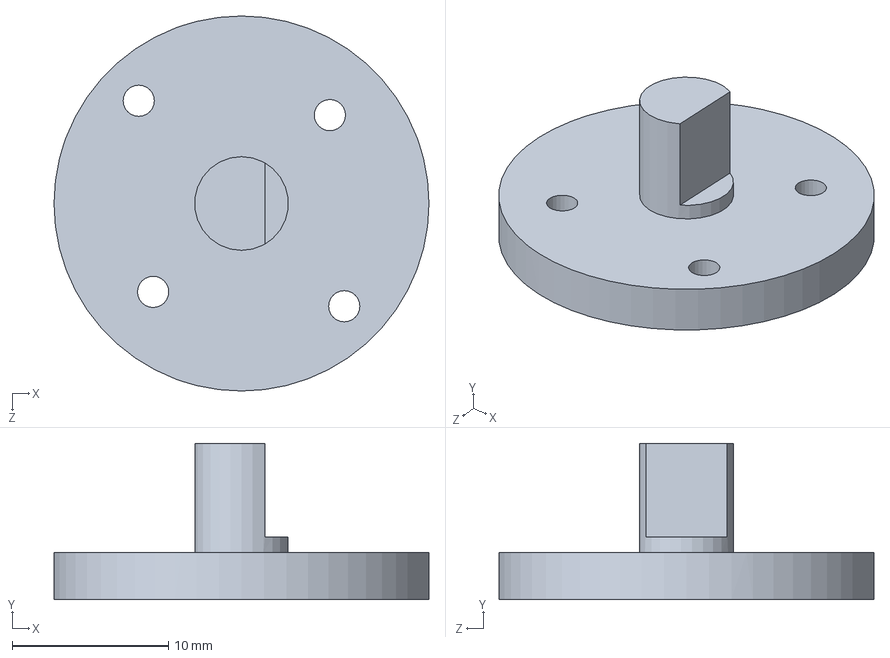
[picture p54: CAD file, 2026-11-02]
GrupoSensor/02Top/AcoplamientoCircular.SLDPRT
24.0 x 10.0 x 24.0 mm
