Wassau/G1_Project_Rover2026/GrupoSensor/02Topv2/OrejetaDchv2.SLDPRT

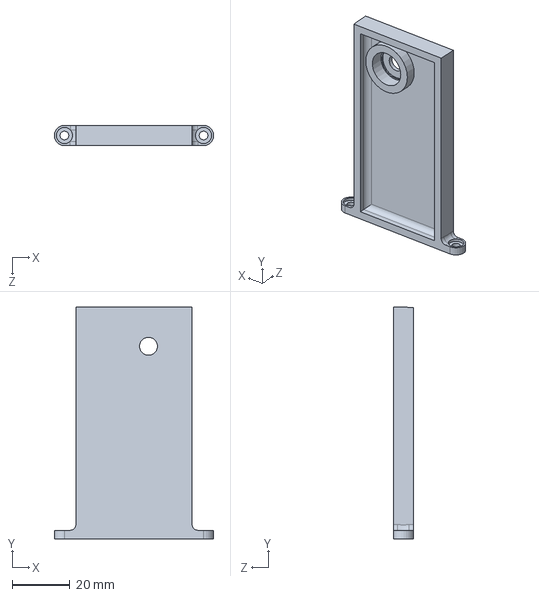
[picture p55: CAD file, 2026-11-04]
GrupoSensor/02Topv2/OrejetaDchv2.SLDPRT
55.0 x 80.1 x 7.00 mm
