Wassau/G1_Project_Rover2026/MODELOS COMPONENTES COMERCIALES/.ELECTRONICA/003S11G_Seta.stp

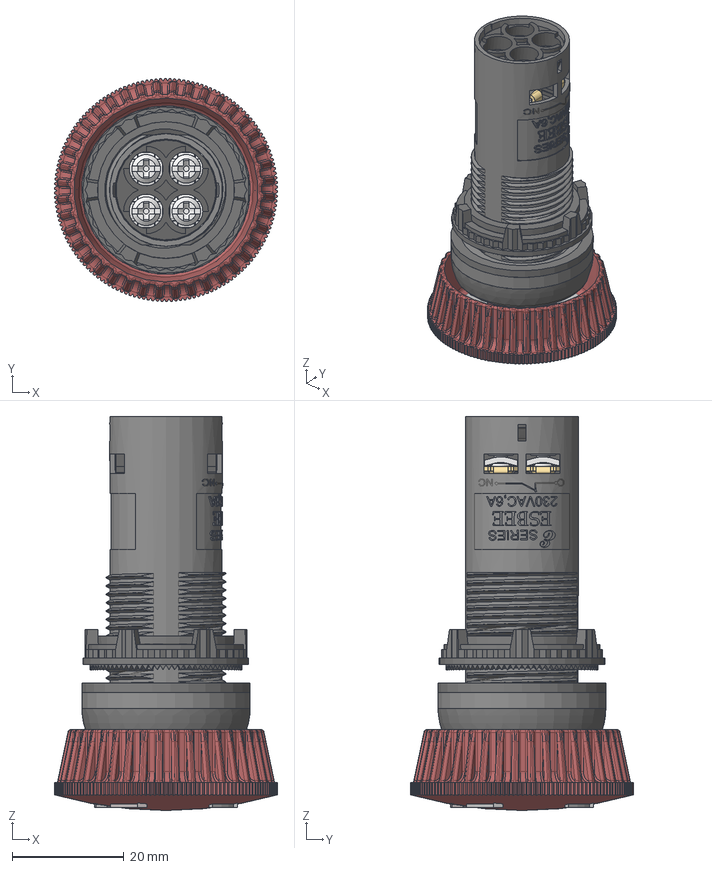
[picture p56: CAD file, 2026-11-11]
MODELOS COMPONENTES COMERCIALES/.ELECTRONICA/003S11G_Seta.stp
40.0 x 40.0 x 70.6 mm
HB400035_COMPRESSION SPRING_1
HB122002_LOCKING_NUT_1_1
MUSHROOM_HEAD_PUSH_TURN_1
MUSHROOM_HEAD_PUSH_TURN 12.10.17_1
HB100134_LENS FOR MUSH HEAD PUSH TURN 12.10.17_1
HB111007_LENS_HOLDER_FOR_MUSHHEAD_1
HB192003_Collar_1
HB152002_WASHER B_M.H._1
HA650005_SCREW_1
HA650004_STAR WASHER_1
HB153005_GROMMET_NEW_MUSHROOM HEAD_1
HB152008_SEALING_RING_0_1
M3X12_1
Hex nut New _1_1
Housing Mechanism1-1
TERMINAL NC-1 x 3
Rivet For Fix Terminal-1 x 3
SCREW_NEW SAMPLE30.07.13-1 x 5
WASHER_NEW SAMPLE30.07.13-1 x 5
COMPRESSION SPRING FOR CONTACT SLIDE-1 x 2
TERMINAL NO1-1 x 2
Rivet For Fix Terminal1-1 x 2
CONTACT SLIDE NC1-1
TERMINAL MOVING_20.04.13-1 x 2
Rivet For Moving Terminal1-1 x 4
COMPRESSION SPRING SMALL_NC CONTACT SLIDE-1
CONTACT SLIDE NO-1
COMPRESSION SPRING SMALL_NO CONTACT SLIDE-1
