Wassau/G1_Project_Rover2026/MODELOS COMPONENTES COMERCIALES/3dfindit-HEFA-CAA-688ZZ-JJ-0202610241739348404740810e898ce/CAA-688ZZ-JJ.igs

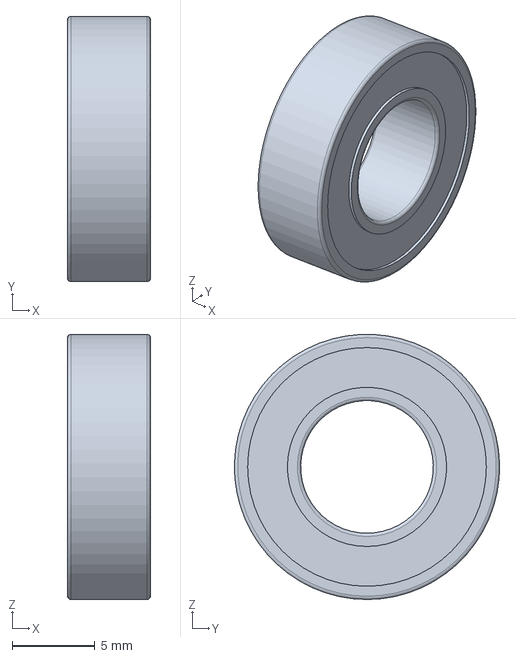
[picture p57: CAD file, 2026-10-27]
MODELOS COMPONENTES COMERCIALES/3dfindit-HEFA-CAA-688ZZ-JJ-0202610241739348404740810e898ce/CAA-688ZZ-JJ.igs
5.00 x 16.0 x 16.0 mm
