Wassau/G1_Project_Rover2026/MODELOS COMPONENTES COMERCIALES/Conducida_Optibelt-21_T5___18-2-0202610121513568375880110e898ce/21 T5 _ 18-2.sldprt

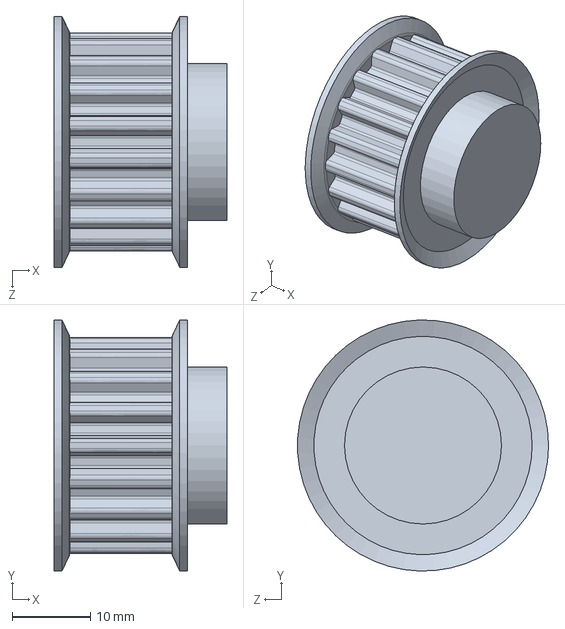
[picture p58: CAD file, 2026-10-17]
MODELOS COMPONENTES COMERCIALES/Conducida_Optibelt-21_T5___18-2-0202610121513568375880110e898ce/21 T5 _ 18-2.sldprt
22.0 x 32.0 x 32.0 mm
