Wassau/G1_Project_Rover2026/MODELOS COMPONENTES COMERCIALES/Motriz_Optibelt-21_T5___12-2-0202610121507522295792710e898ce/21 T5 _ 12-2.sldprt

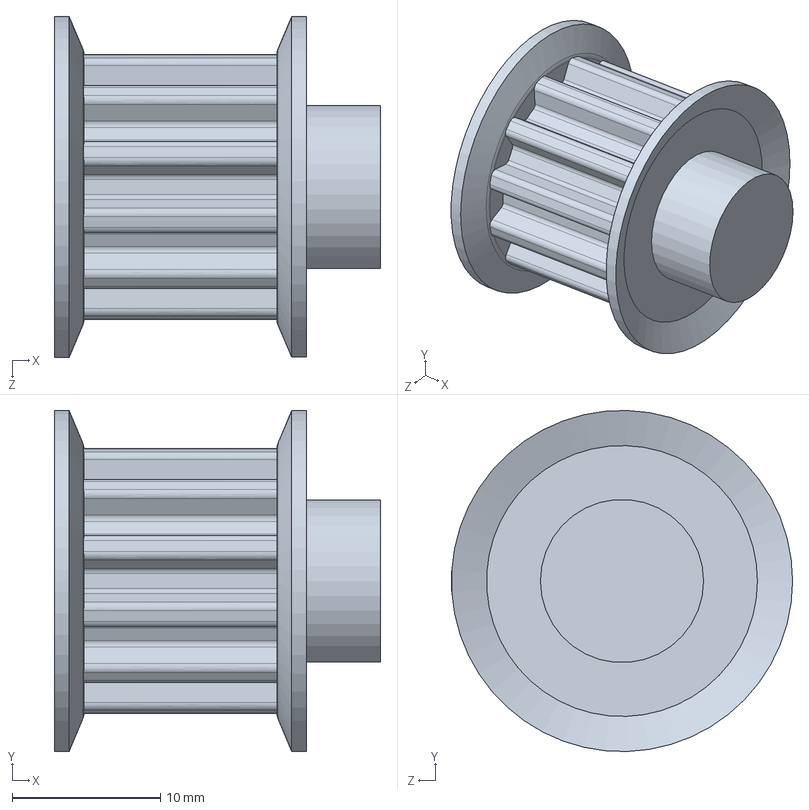
[picture p59: CAD file, 2026-10-17]
MODELOS COMPONENTES COMERCIALES/Motriz_Optibelt-21_T5___12-2-0202610121507522295792710e898ce/21 T5 _ 12-2.sldprt
22.0 x 23.0 x 23.0 mm
