Wassau/G1_Project_Rover2026/MODELOS COMPONENTES COMERCIALES/Piñon_Conducido_KANA__Katayama_Chain_-M1B32-0202610121711471630727910e898ce/M1B32.sldprt

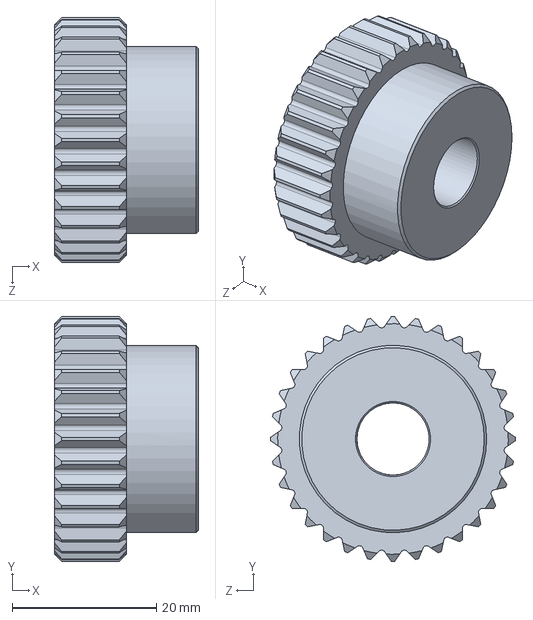
[picture p60: CAD file, 2026-10-13]
MODELOS COMPONENTES COMERCIALES/Piñon_Conducido_KANA__Katayama_Chain_-M1B32-0202610121711471630727910e898ce/M1B32.sldprt
20.0 x 34.0 x 34.0 mm
