Wassau/G1_Project_Rover2026/MODELOS COMPONENTES COMERCIALES/Router.SLDPRT

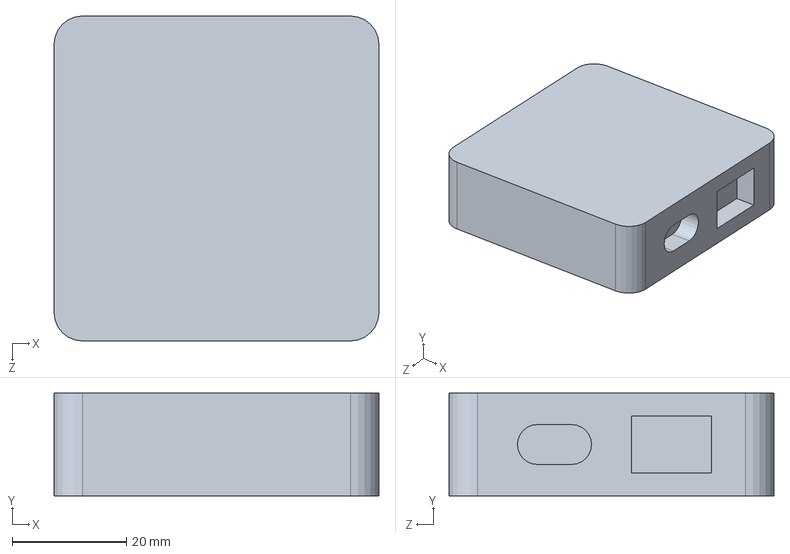
[picture p61: CAD file, 2026-11-06]
MODELOS COMPONENTES COMERCIALES/Router.SLDPRT
57.0 x 18.0 x 57.0 mm
