Wassau/G1_Project_Rover2026/MODELOS COMPONENTES COMERCIALES/rs-pro-brass-inserts-1.snapshot.11/M4 F Insert  RS 2040621.step

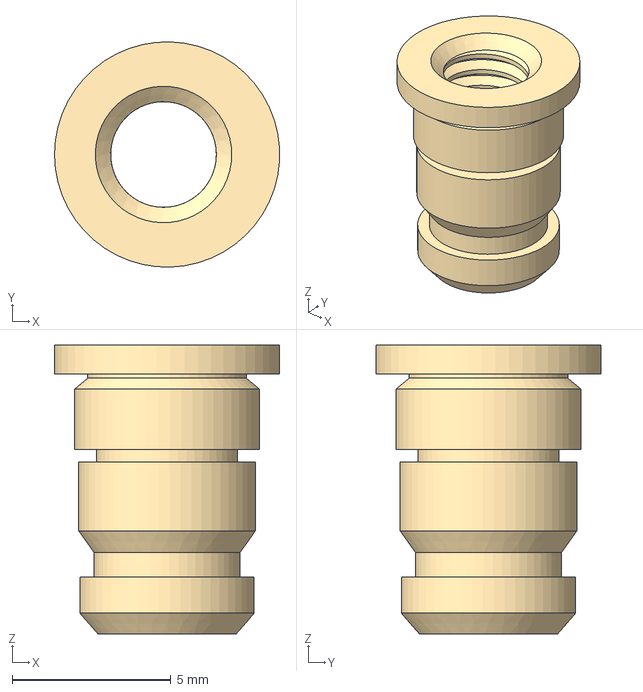
[picture p62: CAD file, 2026-10-27]
MODELOS COMPONENTES COMERCIALES/rs-pro-brass-inserts-1.snapshot.11/M4 F Insert RS 2040621.step
7.09 x 7.10 x 9.11 mm
