Wassau/G1_Project_Rover2026/GrupoChasis/01_Chasis/01_Chasis_SetaSporte.SLDPRT

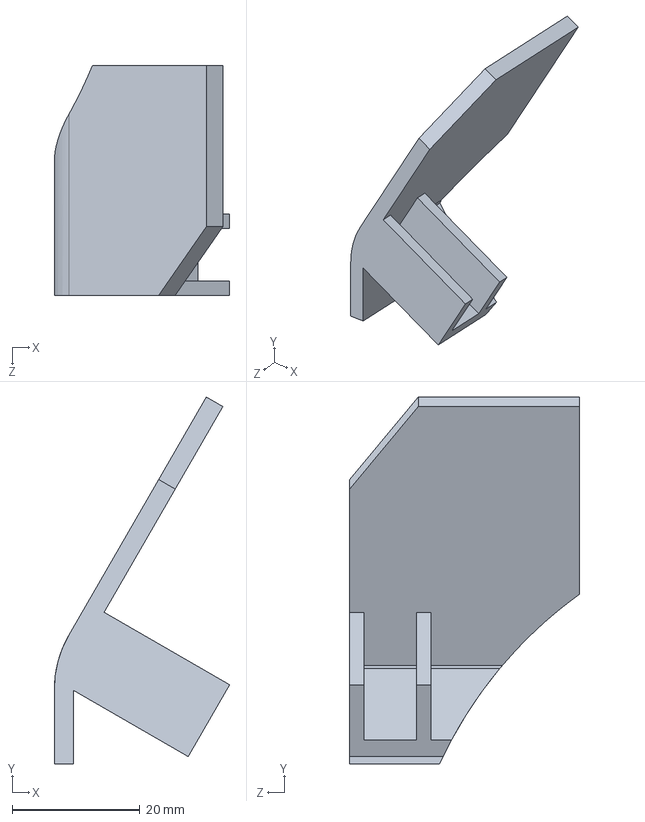
[picture p63: CAD file, 2026-11-07]
GrupoChasis/01_Chasis/01_Chasis_SetaSporte.SLDPRT
27.5 x 57.5 x 36.0 mm
