Wassau/G1_Project_Rover2026/GrupoDirección/Diseñov11/adaptador_hex17_estandar_rosca.SLDPRT

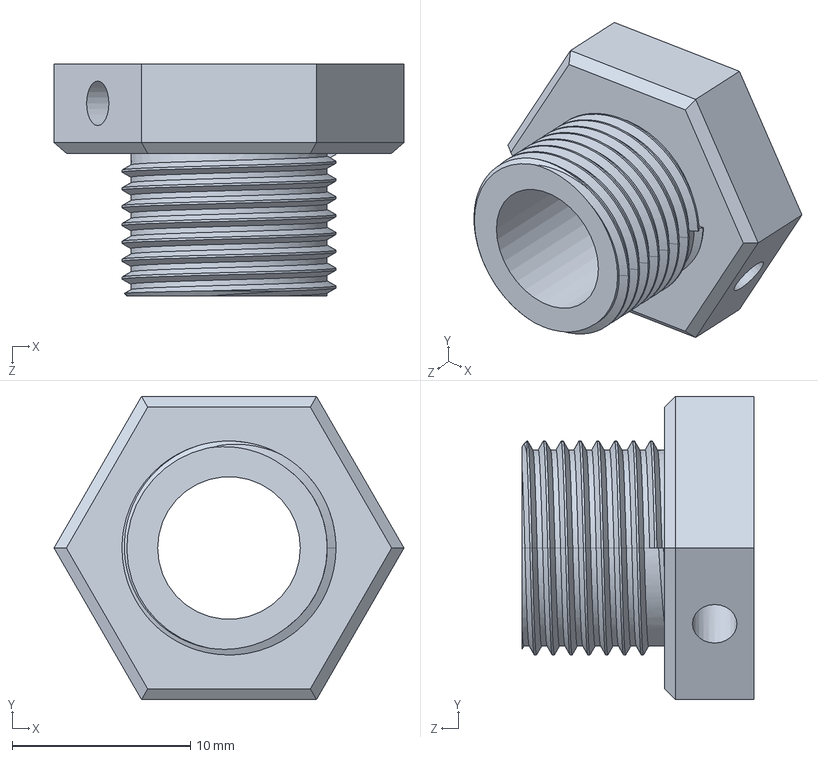
[picture p64: CAD file, 2026-11-04]
GrupoDirección/Diseñov11/adaptador_hex17_estandar_rosca.SLDPRT
19.6 x 17.0 x 13.0 mm
