Wassau/G1_Project_Rover2026/GrupoDirección/Diseñov12/ManguetaDerecha.SLDPRT

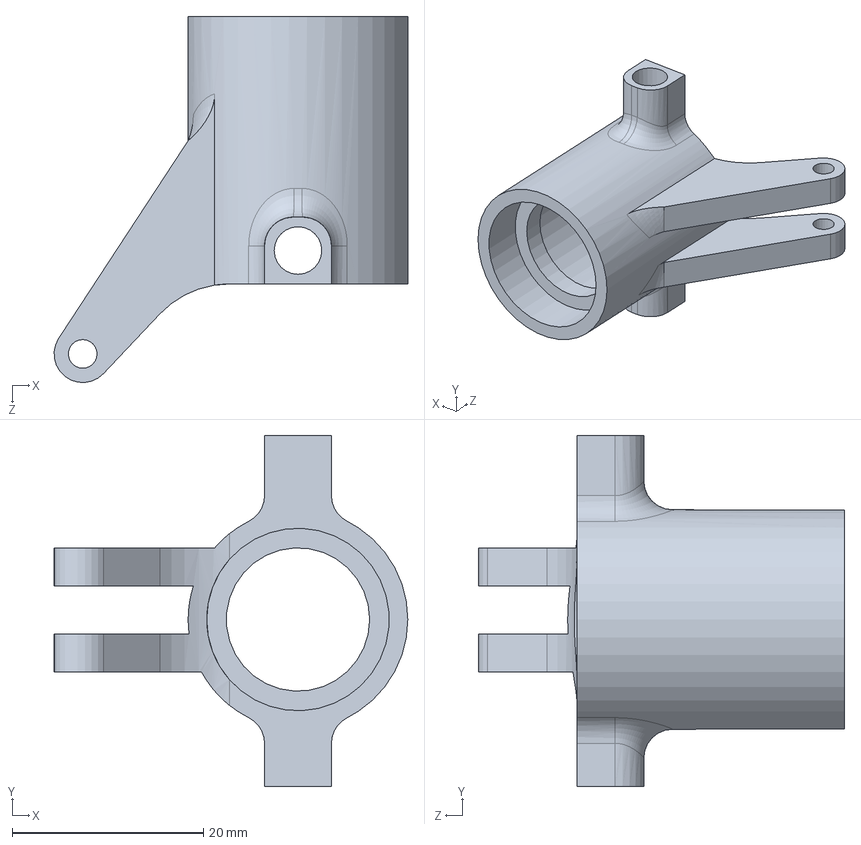
[picture p65: CAD file, 2026-11-05]
GrupoDirección/Diseñov12/ManguetaDerecha.SLDPRT
37.0 x 36.8 x 38.3 mm
