Wassau/G1_Project_Rover2026/GrupoSensor/01Bottom/SoporteServo.SLDPRT

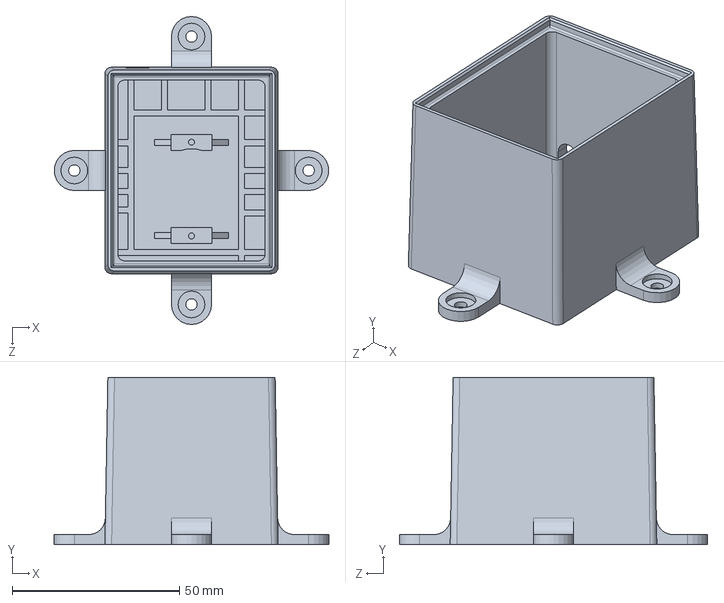
[picture p66: CAD file, 2026-11-04]
GrupoSensor/01Bottom/SoporteServo.SLDPRT
82.0 x 50.0 x 92.0 mm
