Wassau/G1_Project_Rover2026/GrupoSensor/02Top/BaseGiratoriaTop.SLDPRT

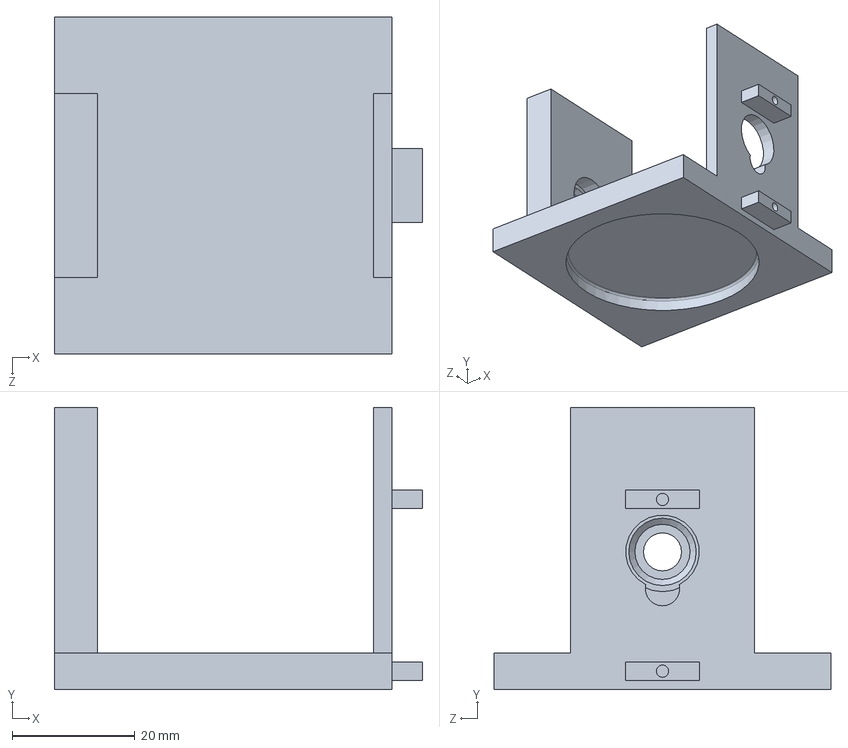
[picture p67: CAD file, 2026-10-27]
GrupoSensor/02Top/BaseGiratoriaTop.SLDPRT
60.0 x 46.0 x 55.0 mm
