Wassau/G1_Project_Rover2026/GrupoSensor/02Topv2/Tensor.SLDPRT

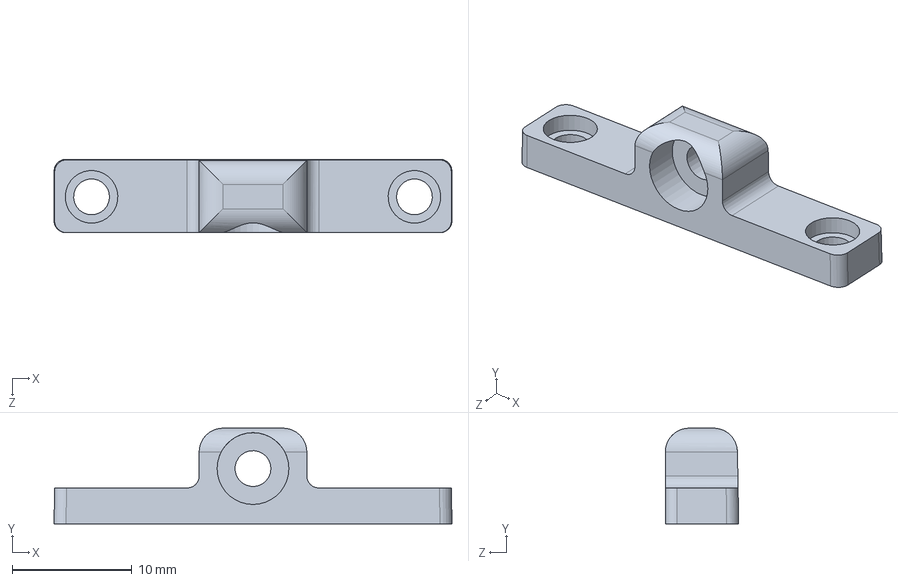
[picture p68: CAD file, 2026-11-04]
GrupoSensor/02Topv2/Tensor.SLDPRT
33.3 x 8.00 x 6.14 mm
