Wassau/G1_Project_Rover2026/MODELOS COMPONENTES COMERCIALES/.ELECTRONICA/M5STACK.SLDPRT

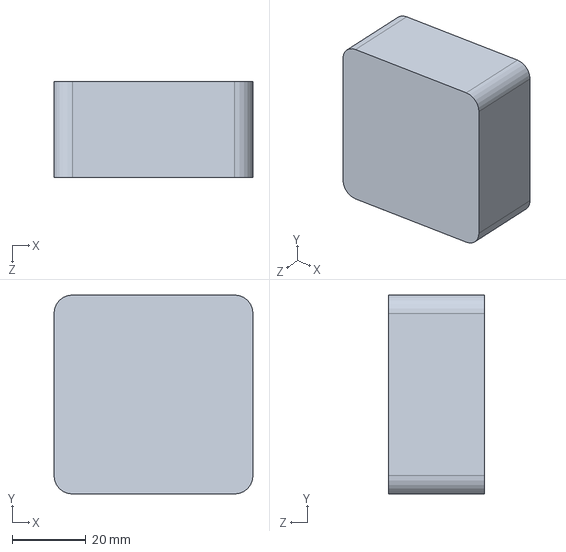
[picture p69: CAD file, 2026-11-06]
MODELOS COMPONENTES COMERCIALES/.ELECTRONICA/M5STACK.SLDPRT
54.0 x 54.0 x 26.0 mm
