Wassau/G1_Project_Rover2026/MODELOS COMPONENTES COMERCIALES/Controladora.SLDPRT

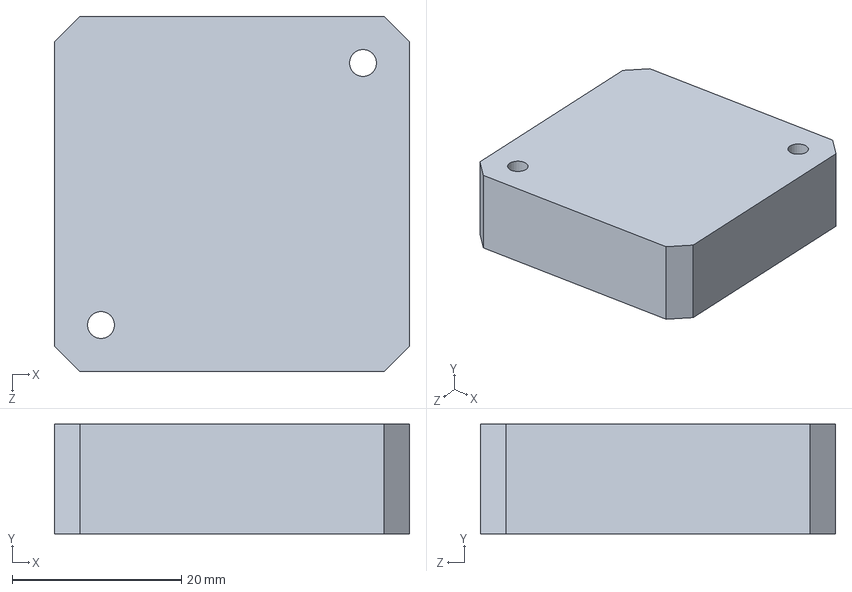
[picture p70: CAD file, 2026-11-06]
MODELOS COMPONENTES COMERCIALES/Controladora.SLDPRT
42.0 x 13.0 x 42.0 mm
