Wassau/G1_Project_Rover2026/MODELOS COMPONENTES COMERCIALES/rc-short-course-tire-rim-1-10-scale-off-road-12mm-hex-1.snapshot.1/Untitled.obj

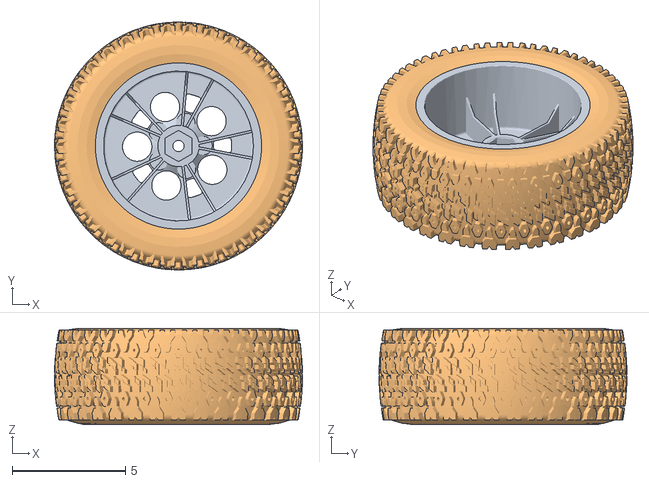
[picture p71: CAD file, 2026-10-27]
MODELOS COMPONENTES COMERCIALES/rc-short-course-tire-rim-1-10-scale-off-road-12mm-hex-1.snapshot.1/Untitled.obj
11.0 x 11.0 x 4.25
