Wassau/G1_Project_Rover2026/MODELOS COMPONENTES COMERCIALES/rs-pro-brass-inserts-1.snapshot.11/M5 F Insert  RS 2040622.step

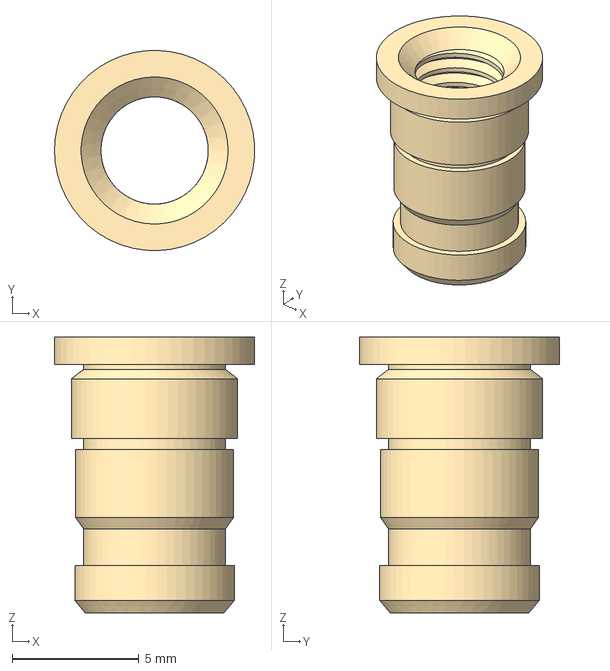
[picture p72: CAD file, 2026-10-27]
MODELOS COMPONENTES COMERCIALES/rs-pro-brass-inserts-1.snapshot.11/M5 F Insert RS 2040622.step
7.89 x 7.90 x 10.9 mm
