Wassau/G1_Project_Rover2026/MODELOS COMPONENTES COMERCIALES/Seta Emergencia/EMERGANCY STOP YELLOW RING.SLDPRT

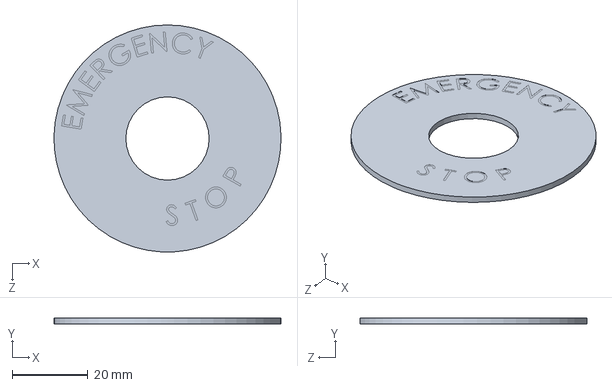
[picture p73: CAD file, 2026-11-06]
MODELOS COMPONENTES COMERCIALES/Seta Emergencia/EMERGANCY STOP YELLOW RING.SLDPRT
60.0 x 1.50 x 60.0 mm
