Wassau/G1_Project_Rover2026/GrupoChasis/01_Chasis/.Versiones Anteriores/Tensor_int.SLDPRT

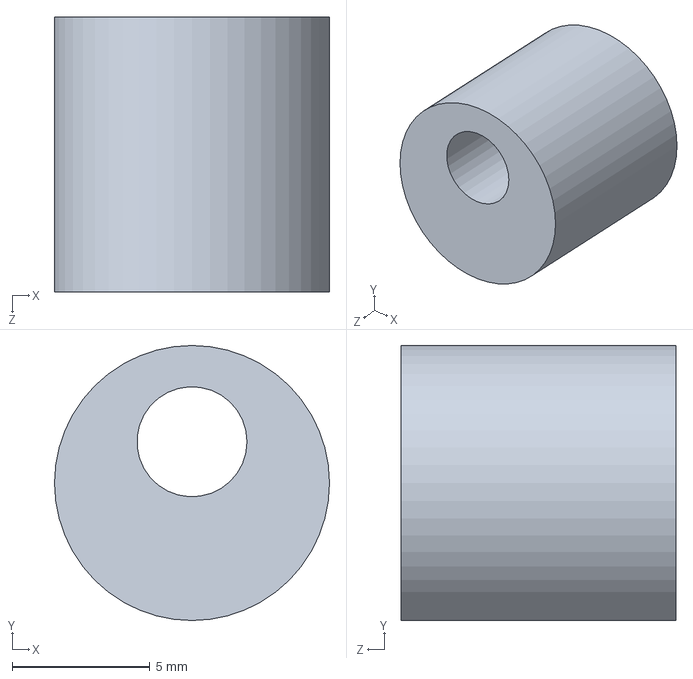
[picture p74: CAD file, 2026-10-27]
GrupoChasis/01_Chasis/.Versiones Anteriores/Tensor_int.SLDPRT
10.0 x 10.0 x 10.0 mm
