Wassau/G1_Project_Rover2026/GrupoChasis/01_Chasis/01_Chasis_ChapaSuperior.SLDPRT

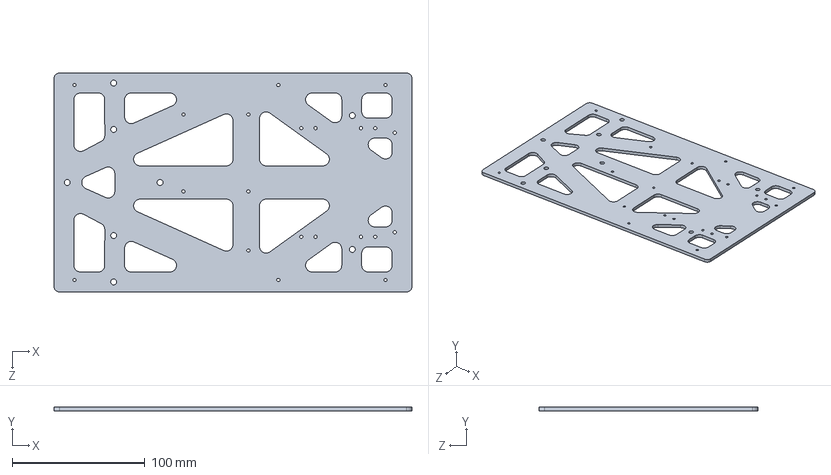
[picture p75: CAD file, 2026-11-07]
GrupoChasis/01_Chasis/01_Chasis_ChapaSuperior.SLDPRT
270.0 x 3.00 x 165.0 mm
