Wassau/G1_Project_Rover2026/GrupoSensor/01Bottom/Eje.SLDPRT

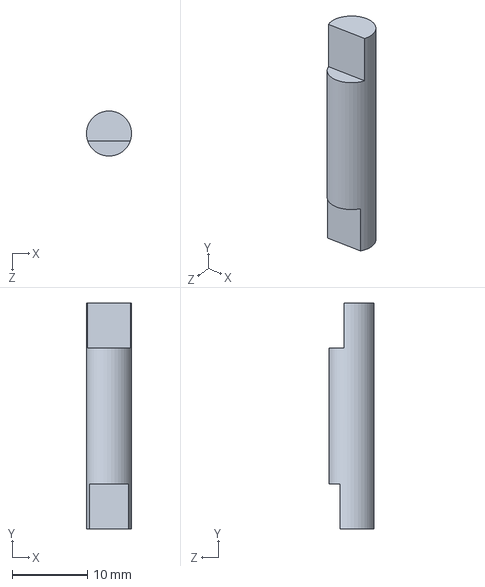
[picture p76: CAD file, 2026-11-02]
GrupoSensor/01Bottom/Eje.SLDPRT
6.00 x 30.0 x 5.99 mm
