Wassau/G1_Project_Rover2026/GrupoSensor/02Top/Circlip6.SLDPRT

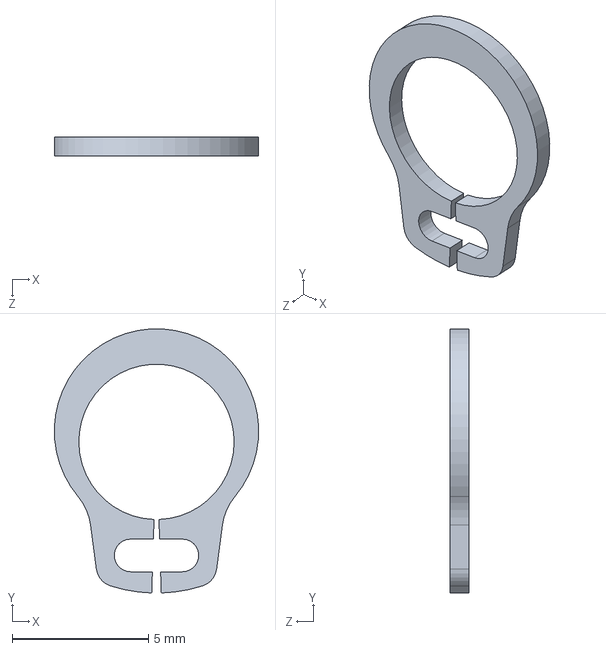
[picture p77: CAD file, 2026-10-27]
GrupoSensor/02Top/Circlip6.SLDPRT
7.50 x 9.69 x 0.7 mm
