Wassau/G1_Project_Rover2026/MODELOS COMPONENTES COMERCIALES/.ELECTRONICA/TMCM-1640_V10.step

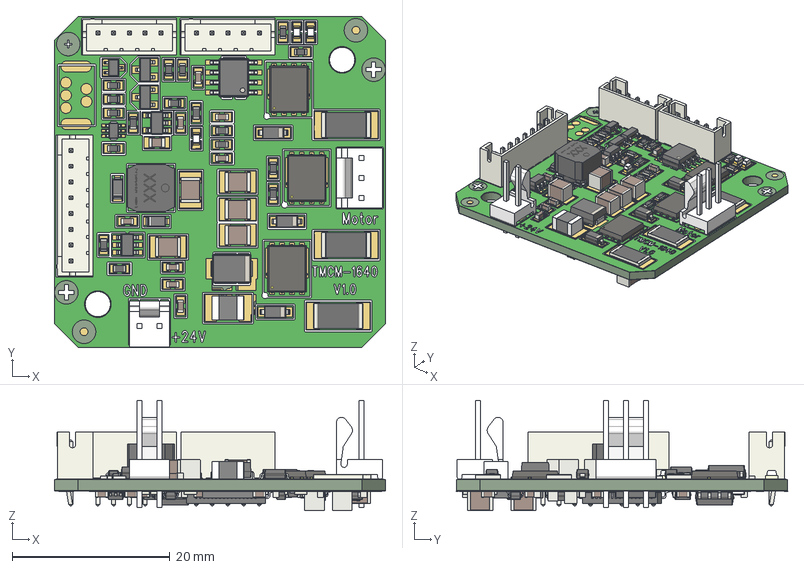
[picture p78: CAD file, 2026-11-03]
MODELOS COMPONENTES COMERCIALES/.ELECTRONICA/TMCM-1640_V10.step
42.0 x 42.0 x 14.0 mm
uid__9223372036854780220
QFN52_8X8_TRI.step
c1210.step x 7
jst_b8b-ph-k_2.step
rn4_1206.STEP x 4
sot23.step x 3
r0603.step x 29
so8.step x 2
c0603.step x 41
sot23-6.step
PowerPAK SO-8 (D).STEP x 3
vls6045_2.step
sot323.step x 3
sot23-5.step
c0805.step x 2
jst_b5b-ph-k_2.step x 2
sod123w.step x 3
c1206.step
1612_ferrite.stp
SOT-363_SC-70-6.step x 5
placementOutline
placementOutline (1)
placementOutline (2)
placementOutline (3)
placementOutline (4)
placementOutline (5)
placementOutline (6)
MJ-5x3.2.step
MTA-100-640456-3-aa-3d.stp
MTA-100-640456-2-aa-3d.stp
microsmp.step x 3
l0603.step x 3
r2512.step x 3
smb.step
placementOutline (7) x 8
lqfp64.step
placementOutline (8) x 2
TMCM-1640_V10_Soldermask
TMCM-1640_V10_CopperTop
TMCM-1640_V10_CopperBottom
TMCM-1640_V10_Silkscreen
