Wassau/G1_Project_Rover2026/MODELOS COMPONENTES COMERCIALES/rs-pro-brass-inserts-1.snapshot.11/M4  Insert  RS 2040617.step

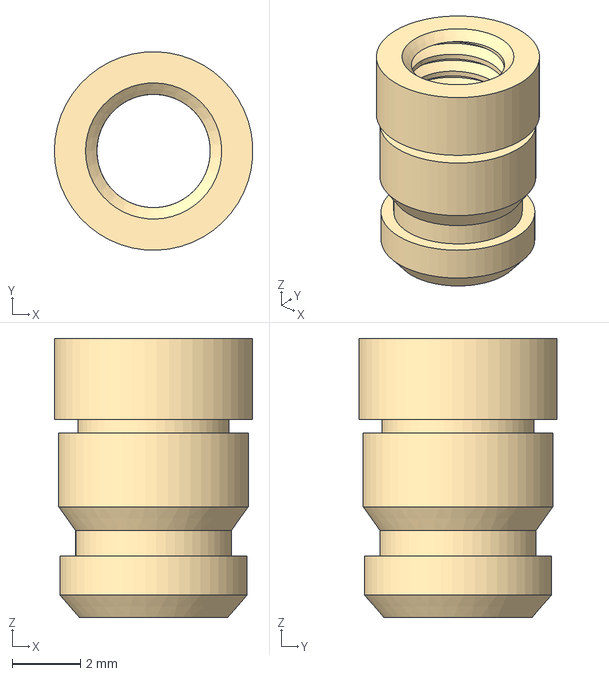
[picture p79: CAD file, 2026-10-27]
MODELOS COMPONENTES COMERCIALES/rs-pro-brass-inserts-1.snapshot.11/M4 Insert RS 2040617.step
5.83 x 5.83 x 8.20 mm
