Wassau/G1_Project_Rover2026/MODELOS COMPONENTES COMERCIALES/Rueda_Buje.SLDPRT

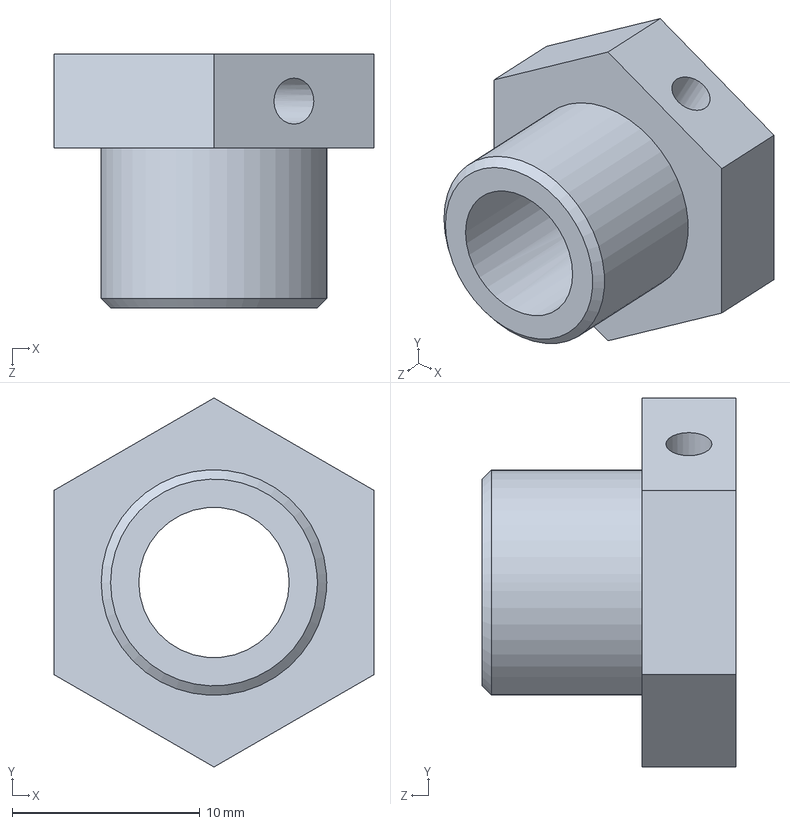
[picture p80: CAD file, 2026-11-05]
MODELOS COMPONENTES COMERCIALES/Rueda_Buje.SLDPRT
17.0 x 19.6 x 13.5 mm
