Wassau/G1_Project_Rover2026/MODELOS COMPONENTES COMERCIALES/Seta Emergencia/NP8-ZS_SEPARADO.stp

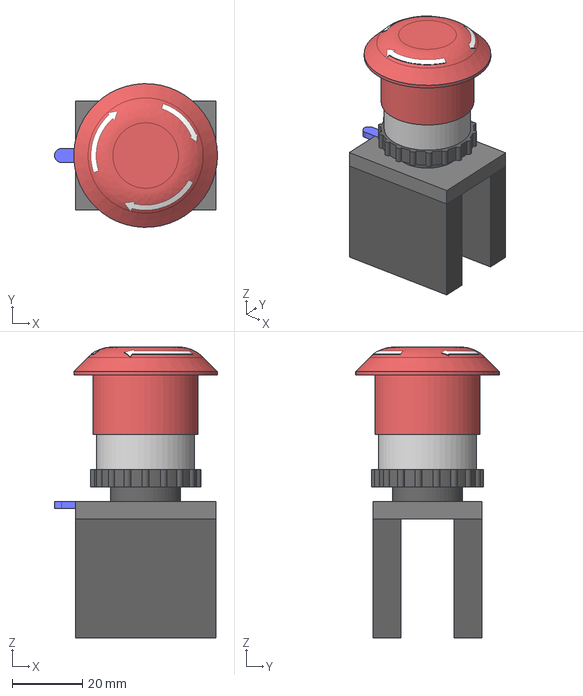
[picture p81: CAD file, 2026-11-06]
MODELOS COMPONENTES COMERCIALES/Seta Emergencia/NP8-ZS_SEPARADO.stp
46.5 x 41.0 x 83.0 mm
