Wassau/G1_Project_Rover2026/GrupoDirección/Diseñov11/rotula_M3_10mm.step

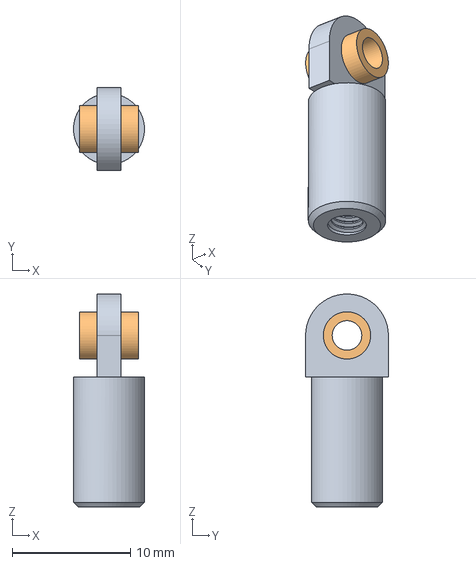
[picture p82: CAD file, 2026-11-04]
GrupoDirección/Diseñov11/rotula_M3_10mm.step
6.00 x 7.00 x 18.0 mm
cuerpo_rotula
casquillo
