Wassau/G1_Project_Rover2026/GrupoDirección/Diseñov12/ConjuntoBalancinInferior.SLDPRT

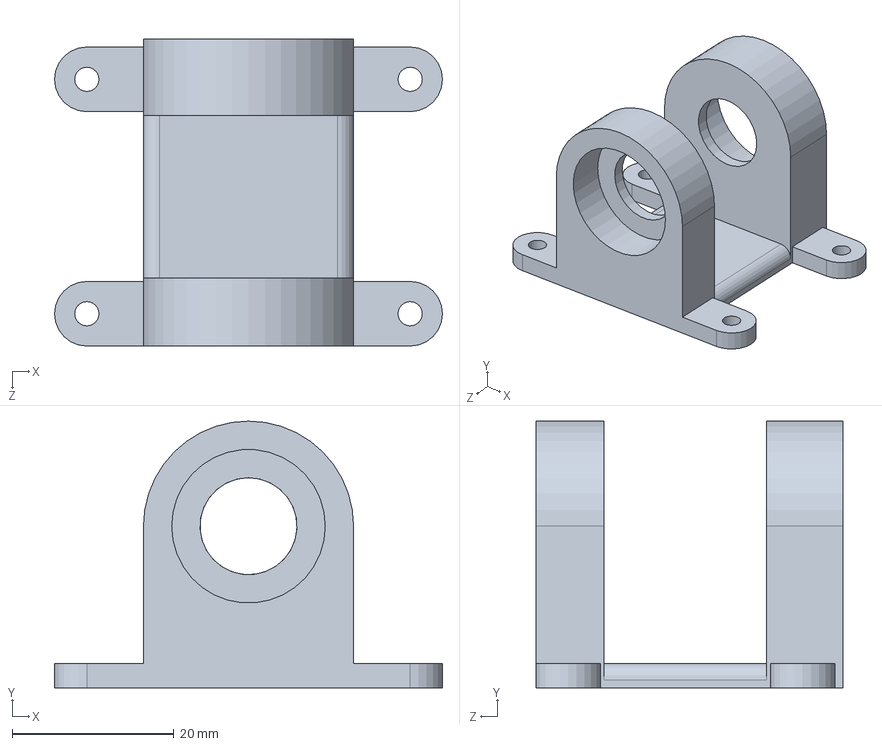
[picture p83: CAD file, 2026-11-05]
GrupoDirección/Diseñov12/ConjuntoBalancinInferior.SLDPRT
48.0 x 33.0 x 38.0 mm
