Wassau/G1_Project_Rover2026/GrupoSensor/01Bottom/AcoplamientoFlexible.SLDPRT

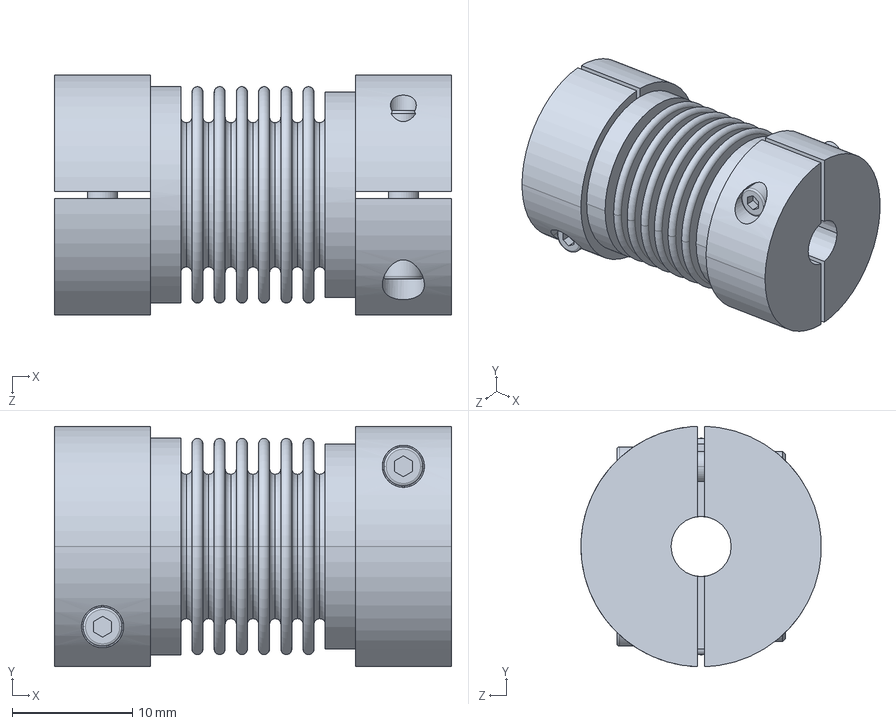
[picture p84: CAD file, 2026-10-27]
GrupoSensor/01Bottom/AcoplamientoFlexible.SLDPRT
33.0 x 20.0 x 20.0 mm
