Wassau/G1_Project_Rover2026/GrupoSensor/02Top/CamaraCarcasa.SLDPRT

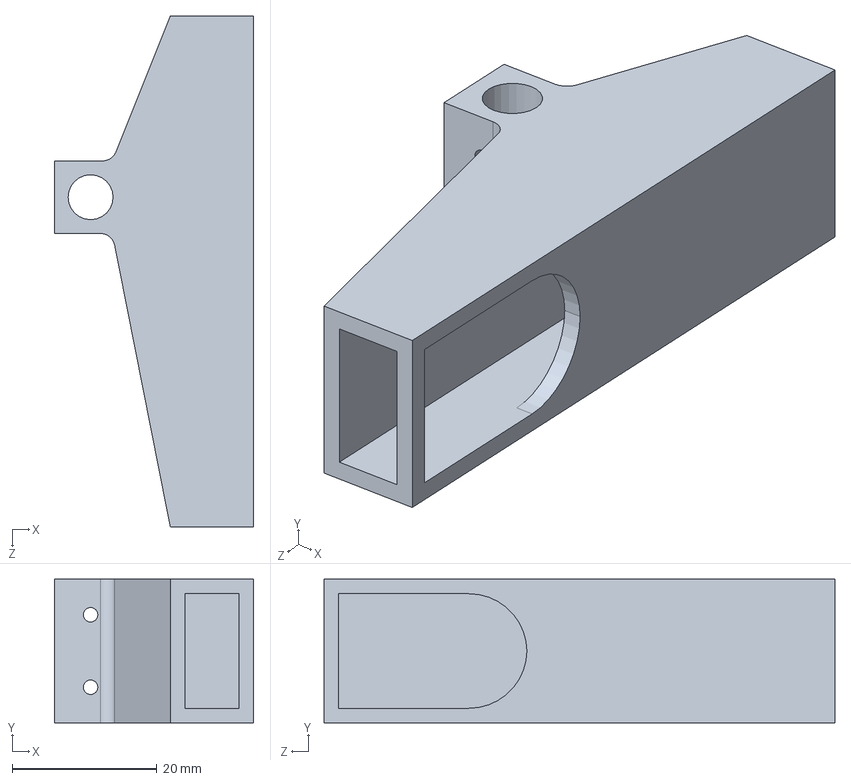
[picture p85: CAD file, 2026-10-27]
GrupoSensor/02Top/CamaraCarcasa.SLDPRT
27.5 x 19.8 x 70.5 mm
