Wassau/G1_Project_Rover2026/GrupoSensor/02Topv2/CamaraCarcasa-3.SLDPRT

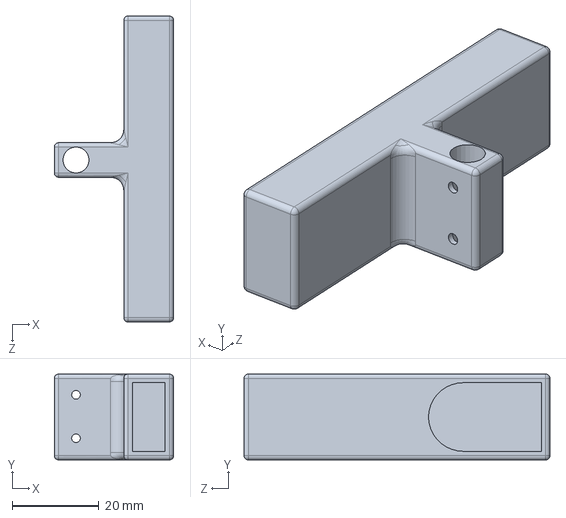
[picture p86: CAD file, 2026-11-02]
GrupoSensor/02Topv2/CamaraCarcasa-3.SLDPRT
27.5 x 19.8 x 70.5 mm
