Wassau/G1_Project_Rover2026/MODELOS COMPONENTES COMERCIALES/Carcasa_Raspberry.SLDPRT

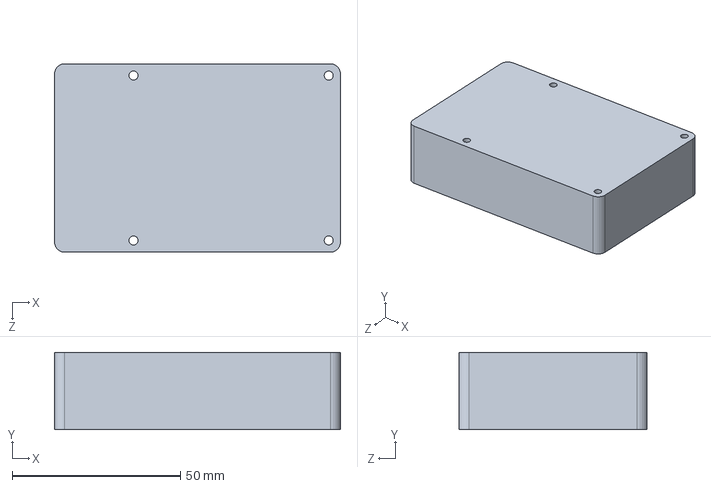
[picture p87: CAD file, 2026-11-05]
MODELOS COMPONENTES COMERCIALES/Carcasa_Raspberry.SLDPRT
85.0 x 23.0 x 56.0 mm
