Wassau/G1_Project_Rover2026/MODELOS COMPONENTES COMERCIALES/rs-pro-brass-inserts-1.snapshot.11/M6  Insert  RS 2040619.SLDPRT

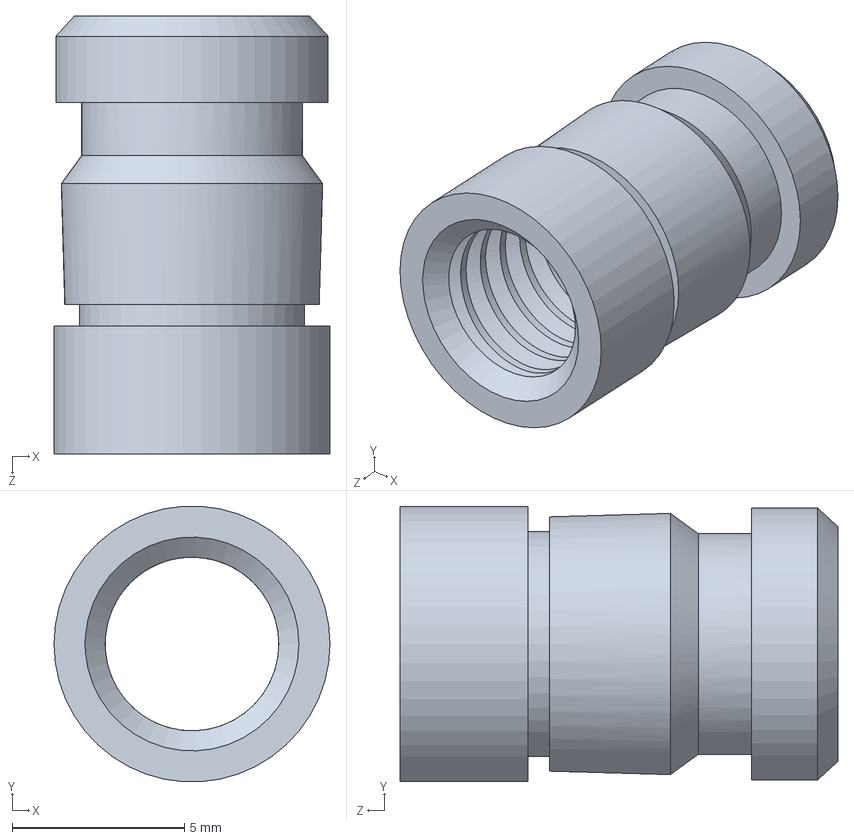
[picture p88: CAD file, 2026-10-27]
MODELOS COMPONENTES COMERCIALES/rs-pro-brass-inserts-1.snapshot.11/M6 Insert RS 2040619.SLDPRT
8.00 x 7.98 x 12.7 mm
