Wassau/G1_Project_Rover2026/GrupoChasis/01_Chasis/01_Chasis_RouterSoporte.SLDPRT

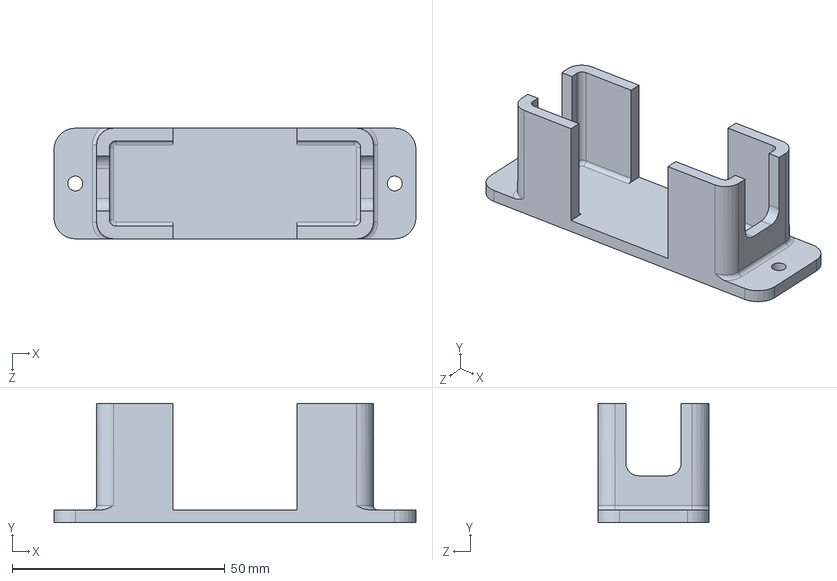
[picture p89: CAD file, 2026-11-07]
GrupoChasis/01_Chasis/01_Chasis_RouterSoporte.SLDPRT
85.0 x 28.0 x 26.0 mm
