Wassau/G1_Project_Rover2026/GrupoSensor/01Bottom/6mmX6mmCoupler.SLDPRT

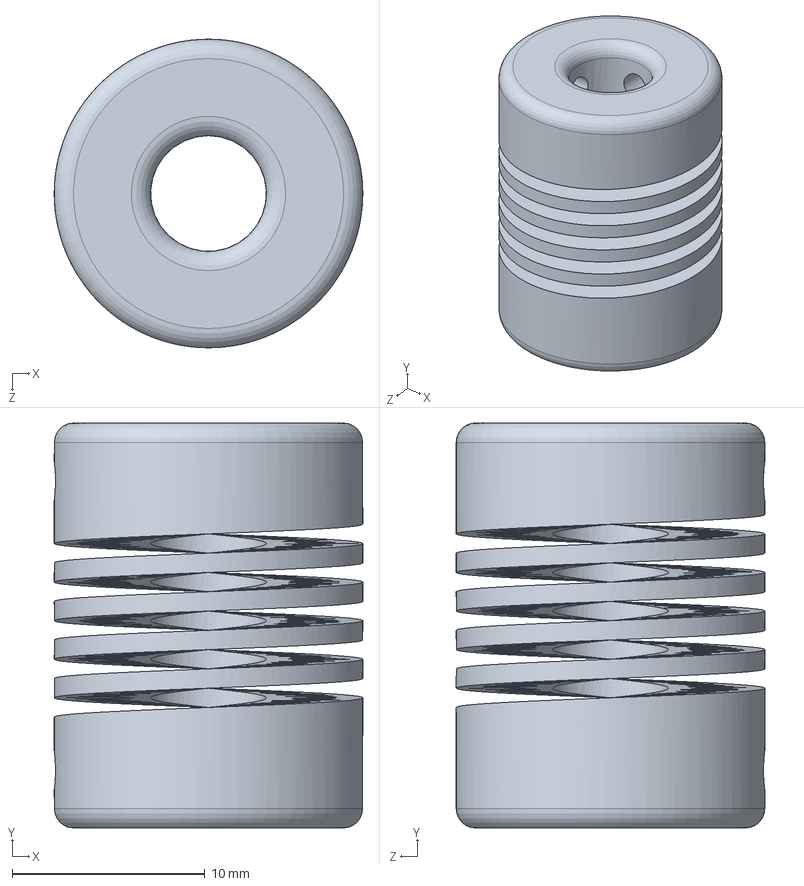
[picture p91: CAD file, 2026-10-27]
GrupoSensor/01Bottom/6mmX6mmCoupler.SLDPRT
16.0 x 21.0 x 16.0 mm
