Wassau/G1_Project_Rover2026/GrupoSensor/02Topv2/Horn Circularv2.SLDPRT

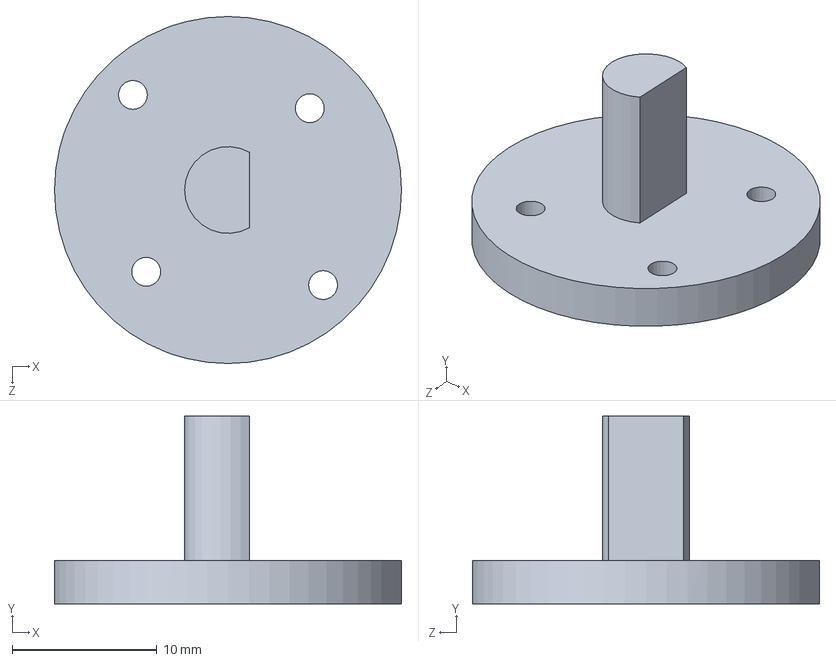
[picture p92: CAD file, 2026-11-02]
GrupoSensor/02Topv2/Horn Circularv2.SLDPRT
24.0 x 13.0 x 24.0 mm
