Wassau/G1_Project_Rover2026/MODELOS COMPONENTES COMERCIALES/FPGA.SLDPRT

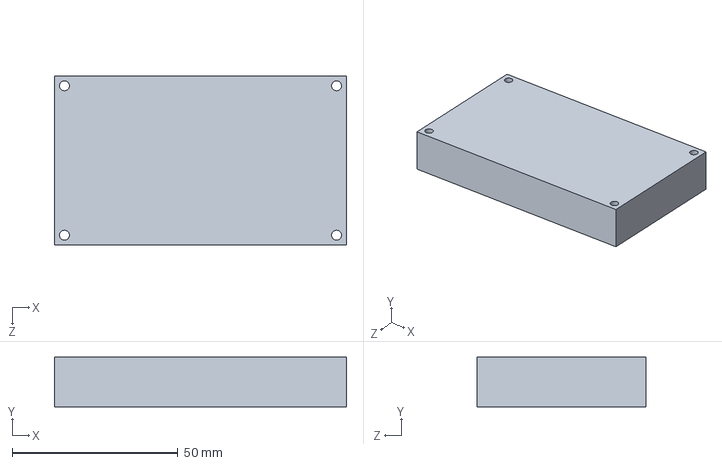
[picture p93: CAD file, 2026-11-05]
MODELOS COMPONENTES COMERCIALES/FPGA.SLDPRT
88.0 x 15.0 x 51.0 mm
