Wassau/G1_Project_Rover2026/MODELOS COMPONENTES COMERCIALES/rs-pro-brass-inserts-1.snapshot.11/M3 F insert RS 2040620.step

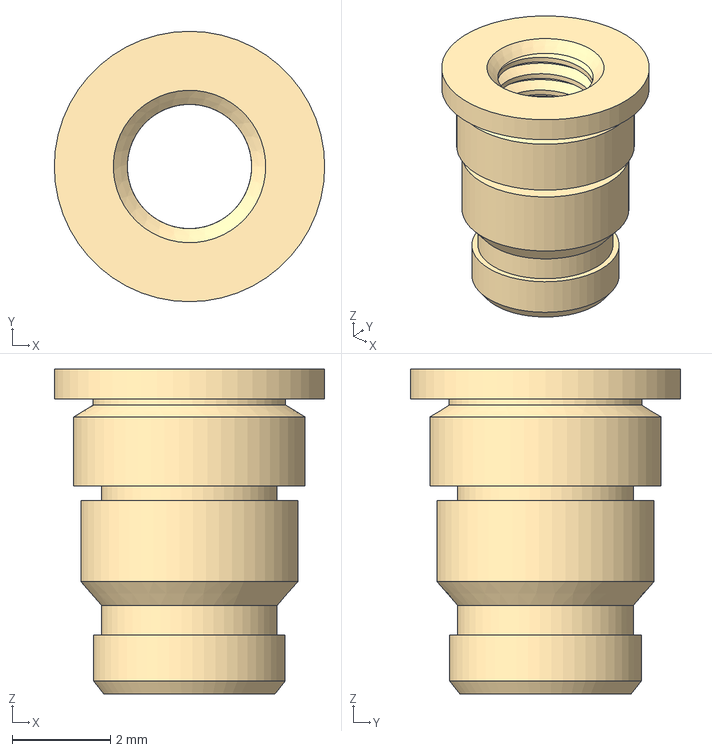
[picture p94: CAD file, 2026-10-27]
MODELOS COMPONENTES COMERCIALES/rs-pro-brass-inserts-1.snapshot.11/M3 F insert RS 2040620.step
5.50 x 5.50 x 6.61 mm
