Wassau/G1_Project_Rover2026/GrupoDirección/Diseñov12/Axis Servo[1].SLDPRT

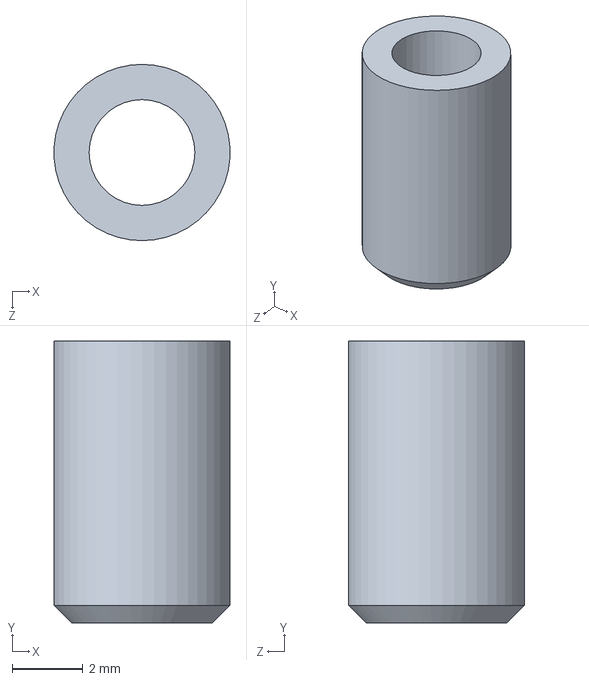
[picture p96: CAD file, 2026-11-05]
GrupoDirección/Diseñov12/Axis Servo[1].SLDPRT
4.99 x 8.00 x 5.00 mm
