Wassau/G1_Project_Rover2026/GrupoSensor/01Bottom/Horn Circular2.SLDPRT

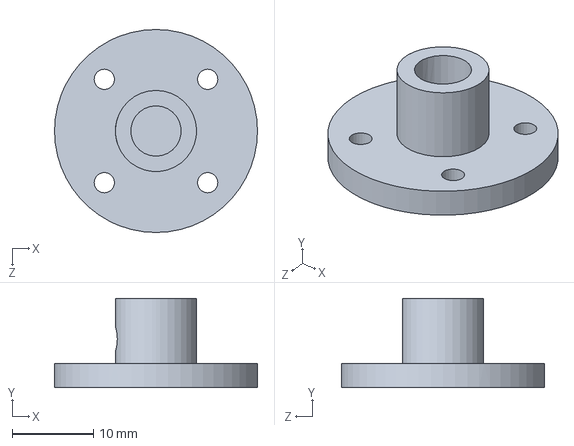
[picture p97: CAD file, 2026-10-27]
GrupoSensor/01Bottom/Horn Circular2.SLDPRT
25.0 x 11.0 x 25.0 mm
