Wassau/G1_Project_Rover2026/GrupoSensor/02Top/Rodamiento6x13.SLDPRT

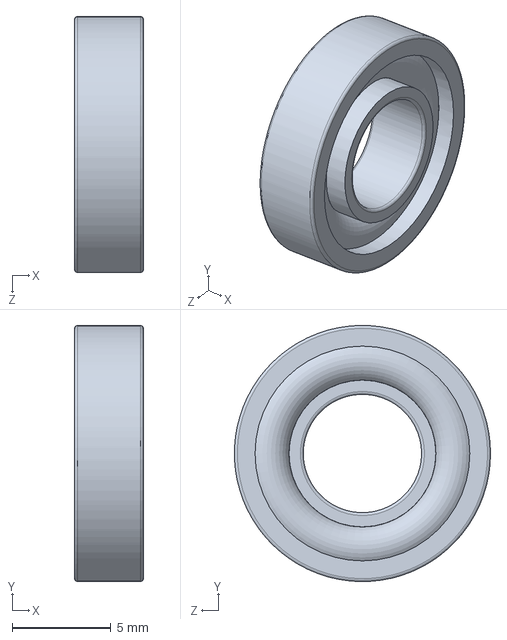
[picture p98: CAD file, 2026-10-27]
GrupoSensor/02Top/Rodamiento6x13.SLDPRT
3.50 x 13.0 x 13.0 mm
