Wassau/G1_Project_Rover2026/GrupoSensor/02Topv2/EjeTopv2.SLDPRT

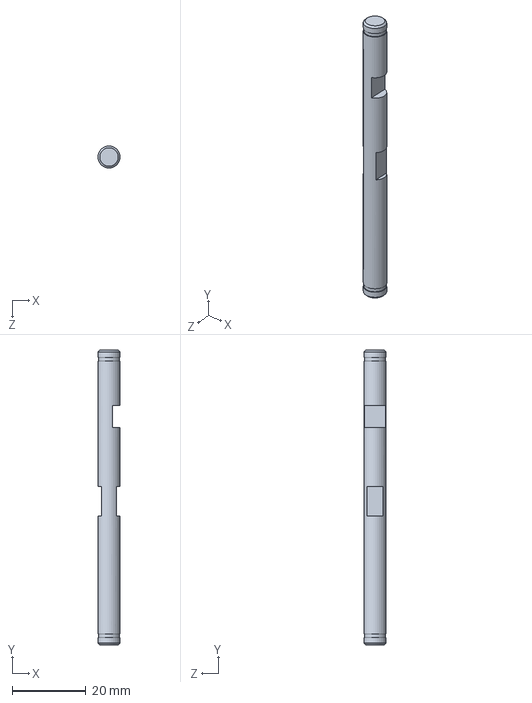
[picture p99: CAD file, 2026-11-02]
GrupoSensor/02Topv2/EjeTopv2.SLDPRT
6.00 x 80.0 x 6.00 mm
