Wassau/G1_Project_Rover2026/MODELOS COMPONENTES COMERCIALES/Rueda_Tuerca.SLDPRT

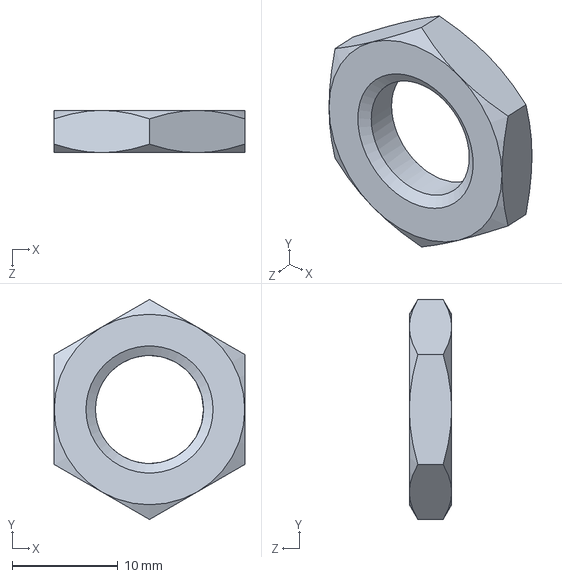
[picture p100: CAD file, 2026-11-05]
MODELOS COMPONENTES COMERCIALES/Rueda_Tuerca.SLDPRT
18.0 x 20.8 x 4.00 mm
