Wassau/G1_Project_Rover2026/GrupoChasis/01_Chasis/01_Chasis_MarcoCarcasa.SLDPRT

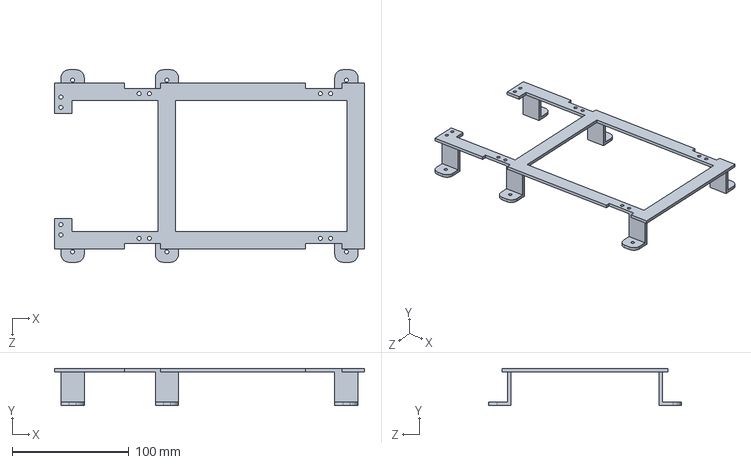
[picture p101: CAD file, 2026-11-07]
GrupoChasis/01_Chasis/01_Chasis_MarcoCarcasa.SLDPRT
265.5 x 32.0 x 165.0 mm
