Wassau/G1_Project_Rover2026/GrupoDirección/Diseñov11/ChapaInferior.SLDPRT

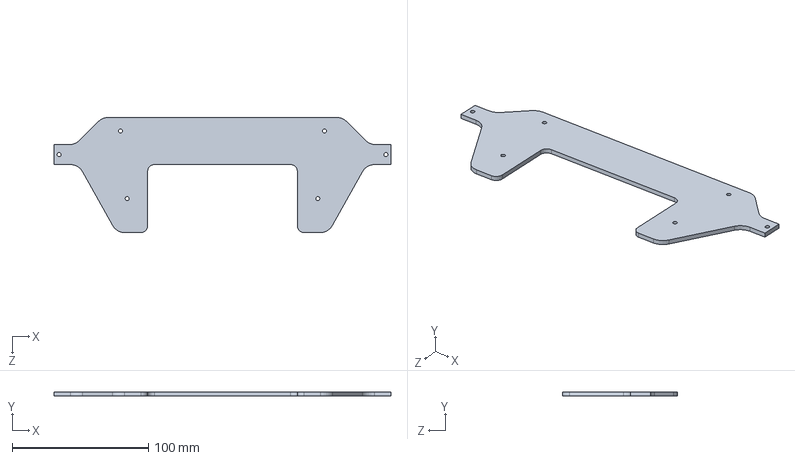
[picture p102: CAD file, 2026-11-04]
GrupoDirección/Diseñov11/ChapaInferior.SLDPRT
247.5 x 3.00 x 84.6 mm
