Wassau/G1_Project_Rover2026/GrupoDirección/Diseñov12/casquillo_RS529004v2PART.SLDPRT

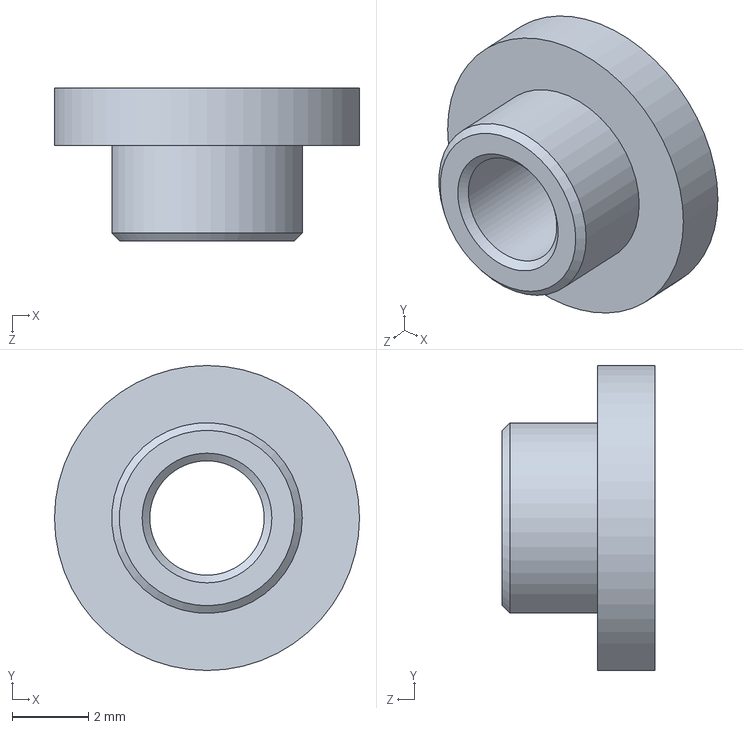
[picture p103: CAD file, 2026-11-05]
GrupoDirección/Diseñov12/casquillo_RS529004v2PART.SLDPRT
8.00 x 8.00 x 4.00 mm
