Wassau/G1_Project_Rover2026/GrupoDirección/Diseñov8/Rueda.SLDPRT

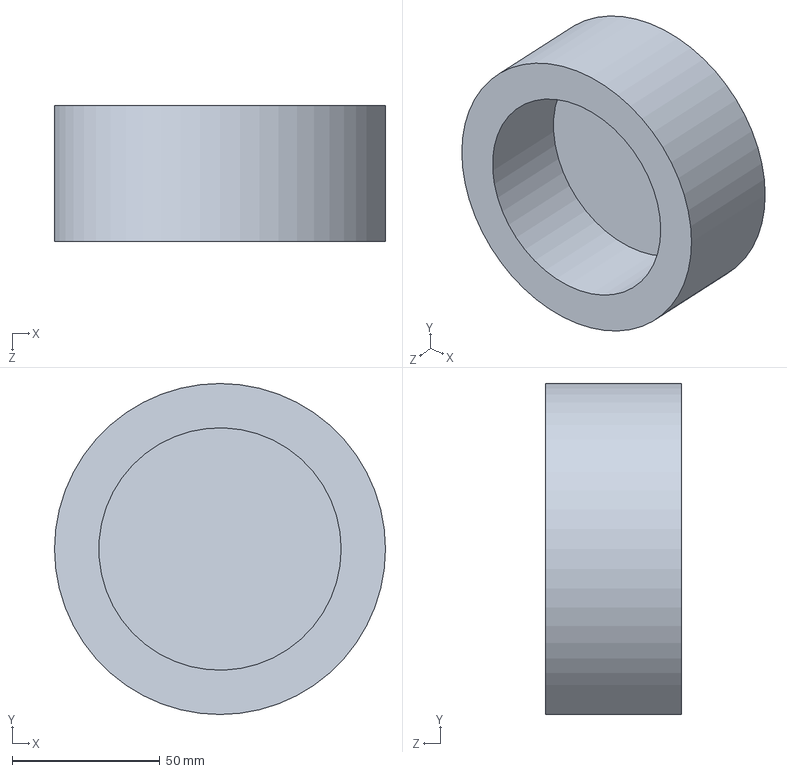
[picture p104: CAD file, 2026-11-02]
GrupoDirección/Diseñov8/Rueda.SLDPRT
112.0 x 112.0 x 46.0 mm
