Wassau/G1_Project_Rover2026/GrupoSensor/02Topv2/ApoyoServoTensor.SLDPRT

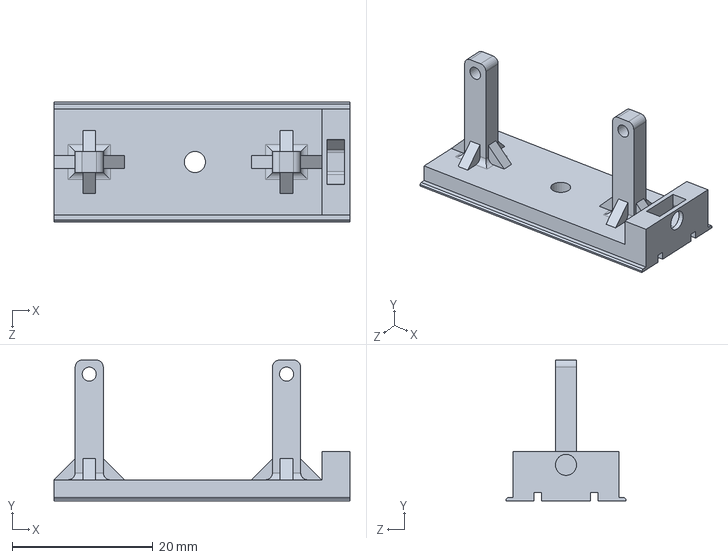
[picture p106: CAD file, 2026-11-02]
GrupoSensor/02Topv2/ApoyoServoTensor.SLDPRT
42.0 x 20.0 x 17.0 mm
