Wassau/G1_Project_Rover2026/MODELOS COMPONENTES COMERCIALES/Bateria.SLDPRT

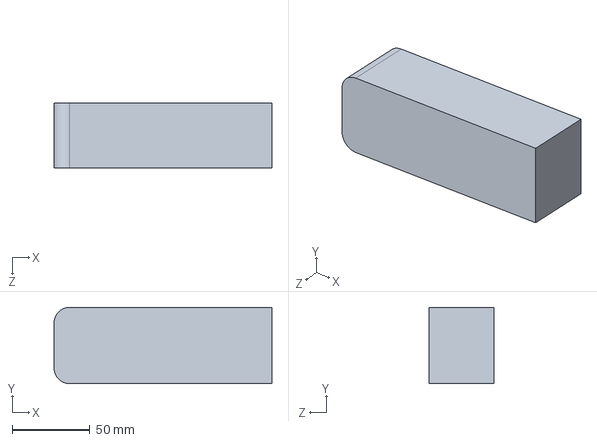
[picture p107: CAD file, 2026-11-05]
MODELOS COMPONENTES COMERCIALES/Bateria.SLDPRT
140.0 x 49.0 x 42.0 mm
