Wassau/G1_Project_Rover2026/GrupoDirección/Diseñov12/VarillaMovil2.SLDPRT

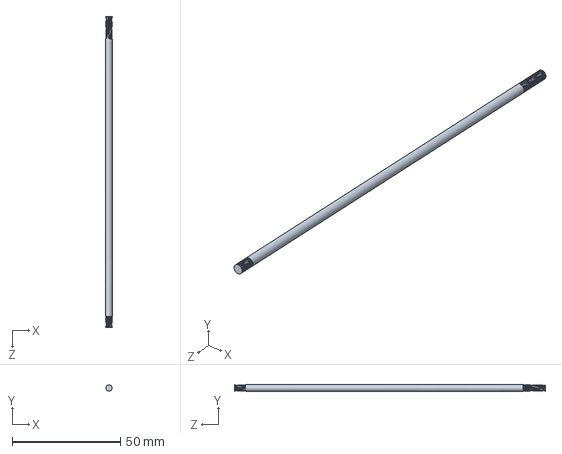
[picture p108: CAD file, 2026-11-05]
GrupoDirección/Diseñov12/VarillaMovil2.SLDPRT
3.00 x 3.00 x 143.4 mm
