Wassau/G1_Project_Rover2026/GrupoSensor/02Top/OrejetaIzq.SLDPRT

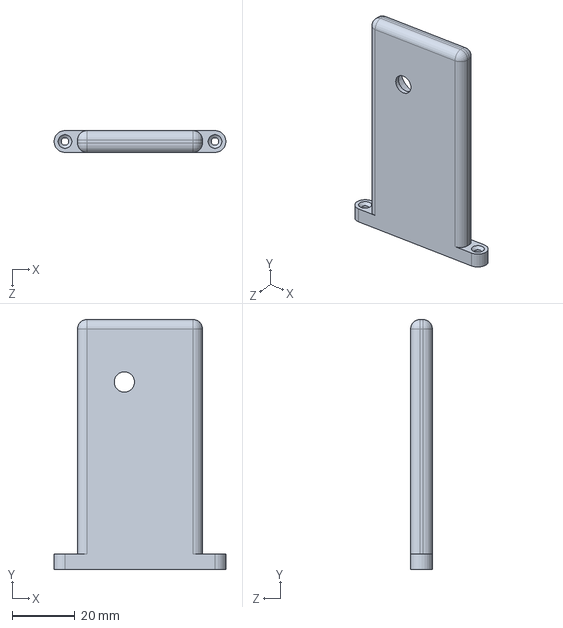
[picture p109: CAD file, 2026-10-27]
GrupoSensor/02Top/OrejetaIzq.SLDPRT
55.0 x 80.0 x 7.00 mm
