Wassau/G1_Project_Rover2026/GrupoSensor/02Topv2/Biela.SLDPRT

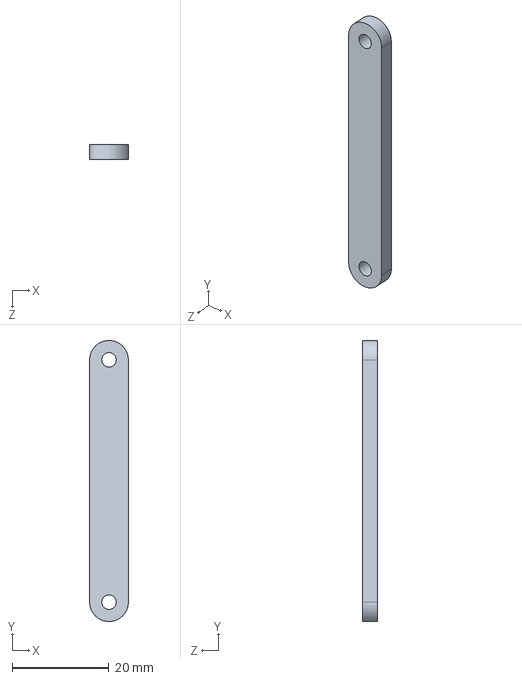
[picture p110: CAD file, 2026-10-27]
GrupoSensor/02Topv2/Biela.SLDPRT
8.00 x 58.0 x 3.00 mm
