Wassau/G1_Project_Rover2026/MODELOS COMPONENTES COMERCIALES/Separador_Hexagonal.SLDPRT

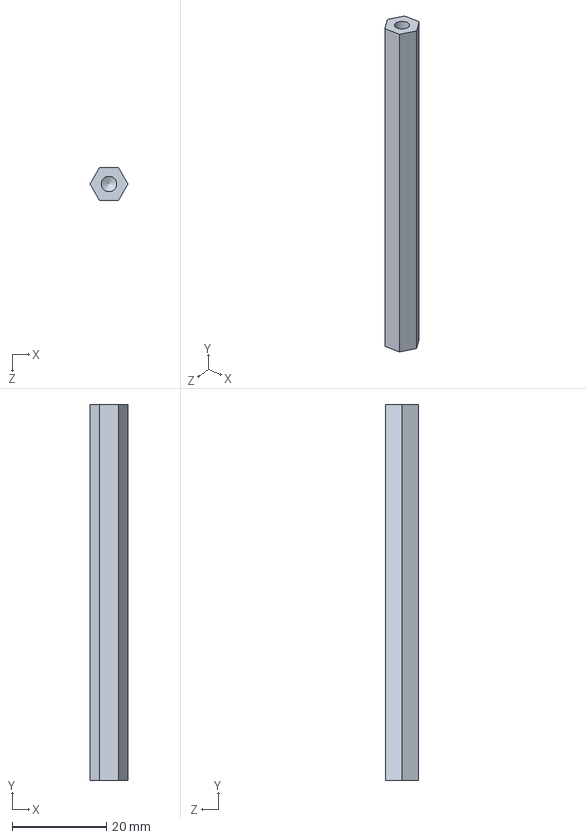
[picture p111: CAD file, 2026-11-04]
MODELOS COMPONENTES COMERCIALES/Separador_Hexagonal.SLDPRT
8.08 x 80.0 x 7.00 mm
