Wassau/G1_Project_Rover2026/GrupoChasis/01_Chasis/Simetría01_Chasis_Puerta_Fijo_Lateral.SLDPRT

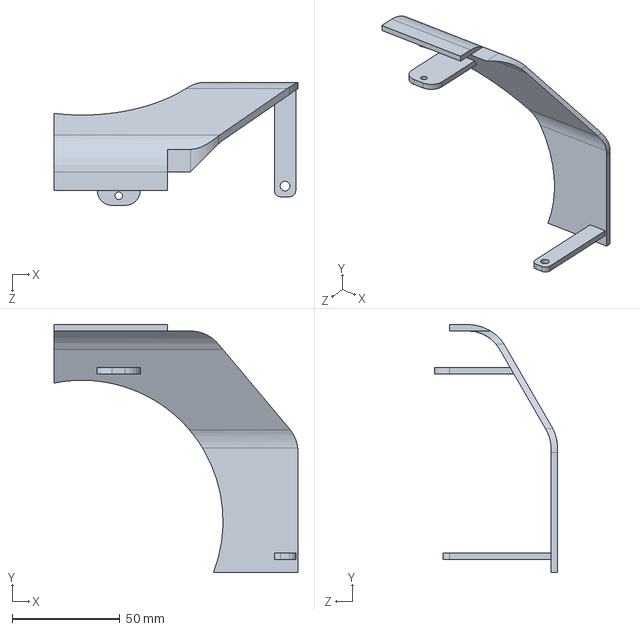
[picture p112: CAD file, 2026-11-07]
GrupoChasis/01_Chasis/Simetría01_Chasis_Puerta_Fijo_Lateral.SLDPRT
113.1 x 115.0 x 57.0 mm
