Wassau/G1_Project_Rover2026/GrupoSensor/02Topv2/ApoyoServo.SLDPRT

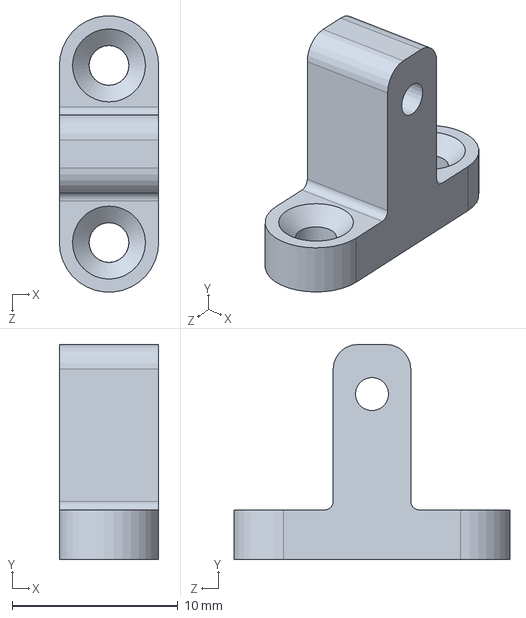
[picture p113: CAD file, 2026-10-27]
GrupoSensor/02Topv2/ApoyoServo.SLDPRT
6.00 x 13.0 x 16.7 mm
