Wassau/G1_Project_Rover2026/MODELOS COMPONENTES COMERCIALES/Rueda.SLDPRT

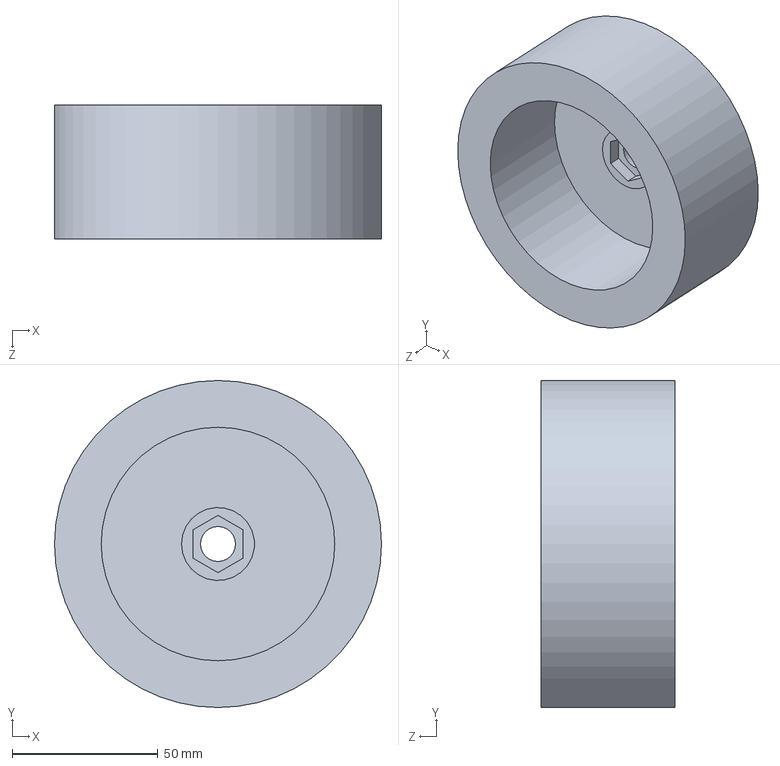
[picture p114: CAD file, 2026-10-27]
MODELOS COMPONENTES COMERCIALES/Rueda.SLDPRT
112.0 x 112.0 x 46.0 mm
