Wassau/G1_Project_Rover2026/GrupoDirección/Diseñov12/SoporteBalancinSuperior.SLDPRT

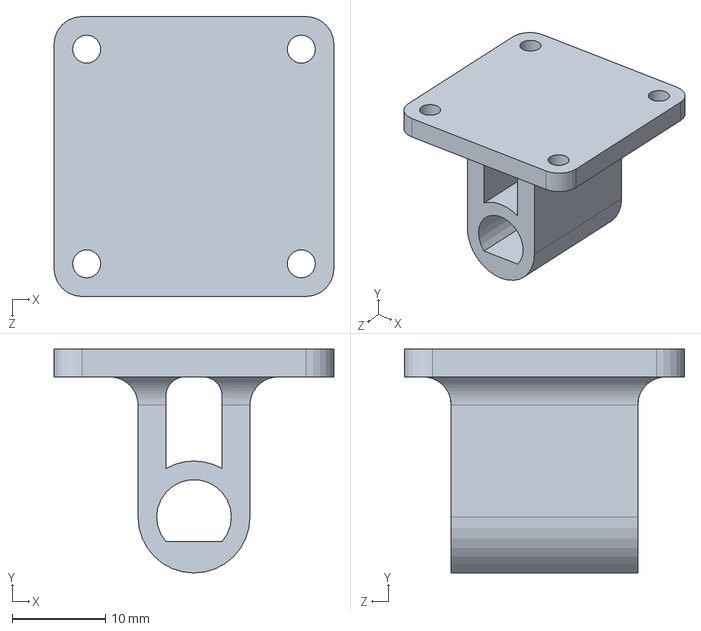
[picture p115: CAD file, 2026-11-05]
GrupoDirección/Diseñov12/SoporteBalancinSuperior.SLDPRT
30.0 x 24.0 x 30.0 mm
