Wassau/G1_Project_Rover2026/GrupoChasis/01_Chasis/01_Chasis_PCBAlimSoporte.SLDPRT

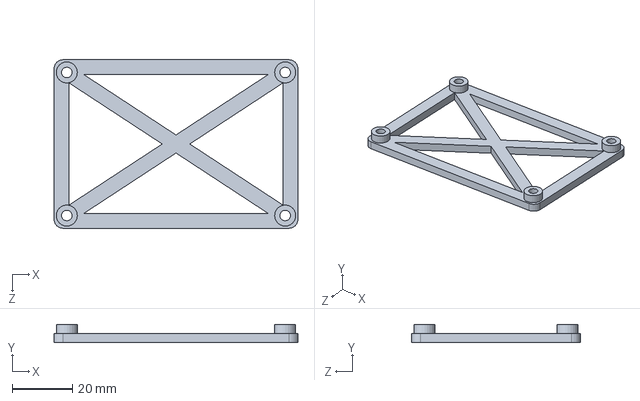
[picture p116: CAD file, 2026-11-06]
GrupoChasis/01_Chasis/01_Chasis_PCBAlimSoporte.SLDPRT
81.0 x 6.00 x 56.0 mm
