Wassau/G1_Project_Rover2026/GrupoSensor/02Topv2/Tapon.SLDPRT

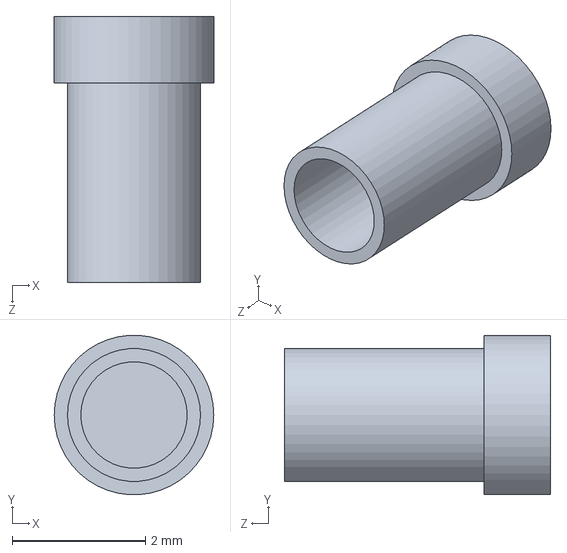
[picture p117: CAD file, 2026-10-27]
GrupoSensor/02Topv2/Tapon.SLDPRT
2.40 x 2.39 x 4.00 mm
