Wassau/G1_Project_Rover2026/GrupoChasis/01_Chasis/01_Chasis_RaspberrySoporte.SLDPRT

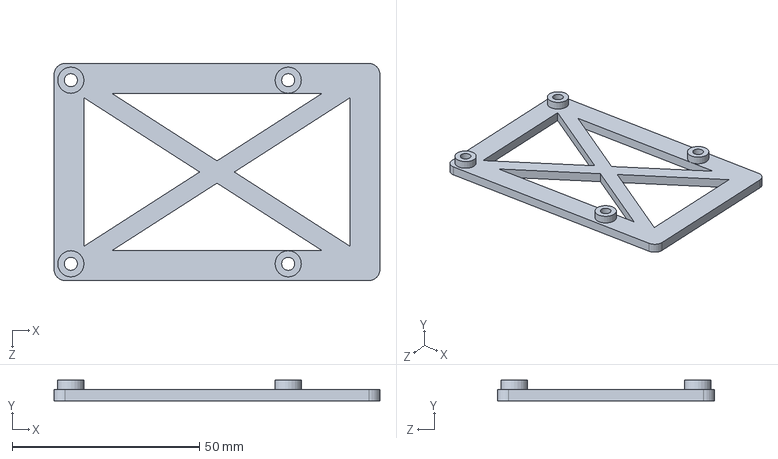
[picture p118: CAD file, 2026-11-06]
GrupoChasis/01_Chasis/01_Chasis_RaspberrySoporte.SLDPRT
87.0 x 5.50 x 58.0 mm
