Wassau/G1_Project_Rover2026/GrupoSensor/02Topv2/Rodamiento6x13x5.SLDPRT

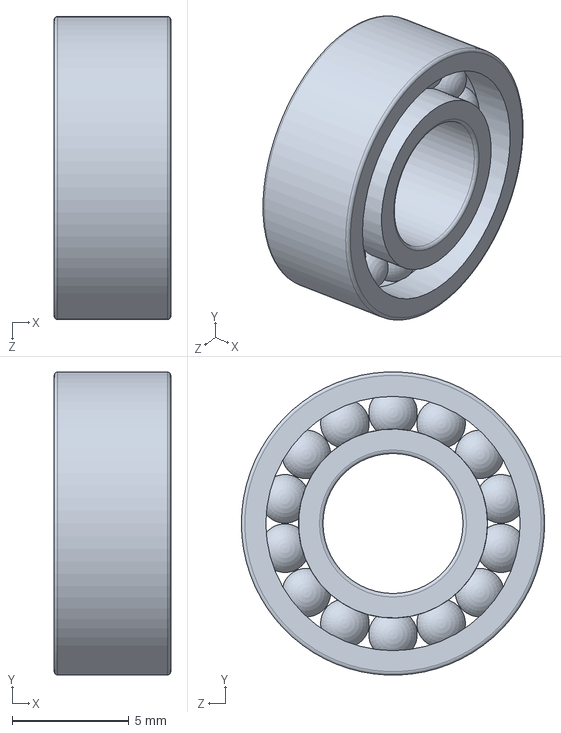
[picture p119: CAD file, 2026-10-27]
GrupoSensor/02Topv2/Rodamiento6x13x5.SLDPRT
5.00 x 13.0 x 13.0 mm
