Wassau/G1_Project_Rover2026/GrupoSensor/02Topv2/SujeccionTensor.SLDPRT

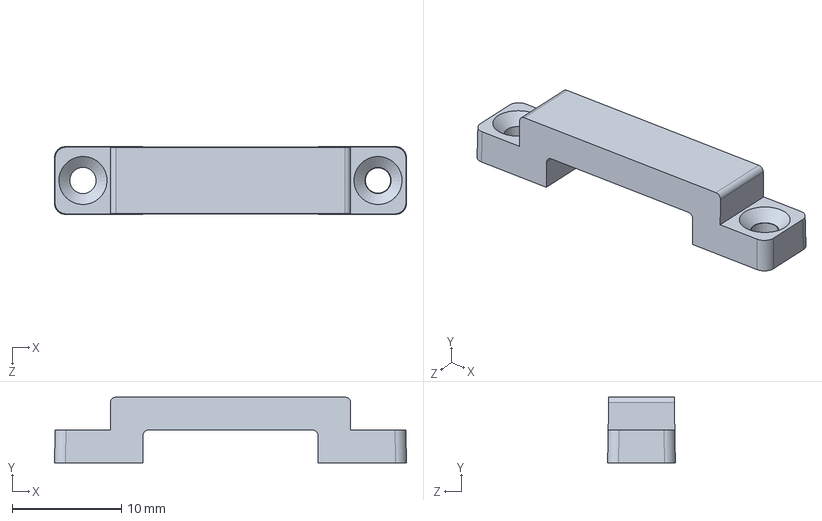
[picture p120: CAD file, 2026-10-27]
GrupoSensor/02Topv2/SujeccionTensor.SLDPRT
32.2 x 6.00 x 6.21 mm
