Wassau/G1_Project_Rover2026/GrupoChasis/01_Chasis/01_Chasis_Puerta_Lateral.SLDPRT

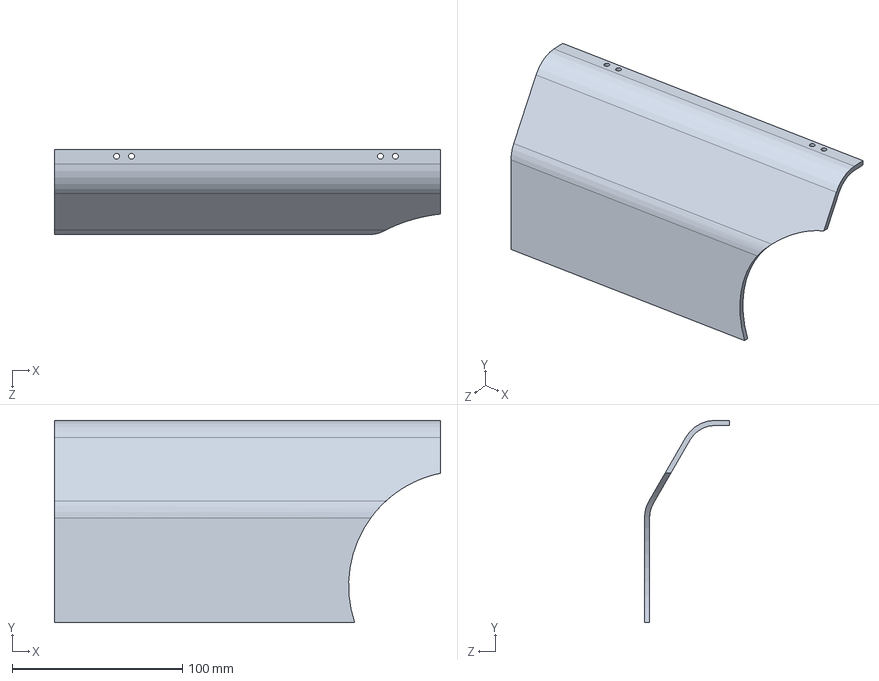
[picture p121: CAD file, 2026-11-06]
GrupoChasis/01_Chasis/01_Chasis_Puerta_Lateral.SLDPRT
227.0 x 119.0 x 50.0 mm
