Wassau/G1_Project_Rover2026/GrupoDirección/Diseñov12/EjeChapa.SLDPRT

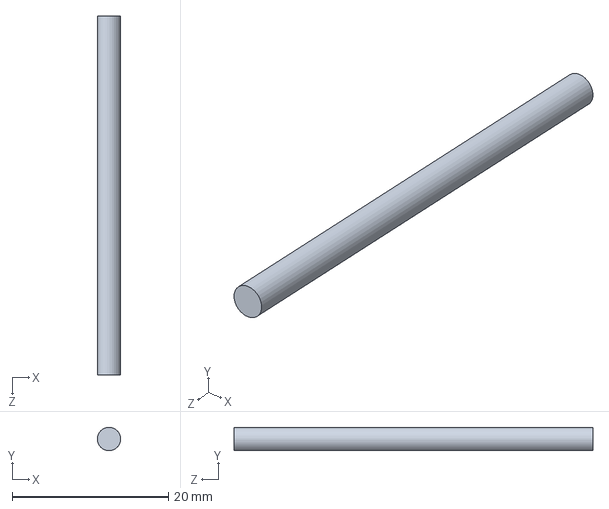
[picture p122: CAD file, 2026-11-05]
GrupoDirección/Diseñov12/EjeChapa.SLDPRT
3.00 x 3.00 x 46.0 mm
