Wassau/G1_Project_Rover2026/GrupoChasis/01_Chasis/01_Chasis_ControladoraSoporte.SLDPRT

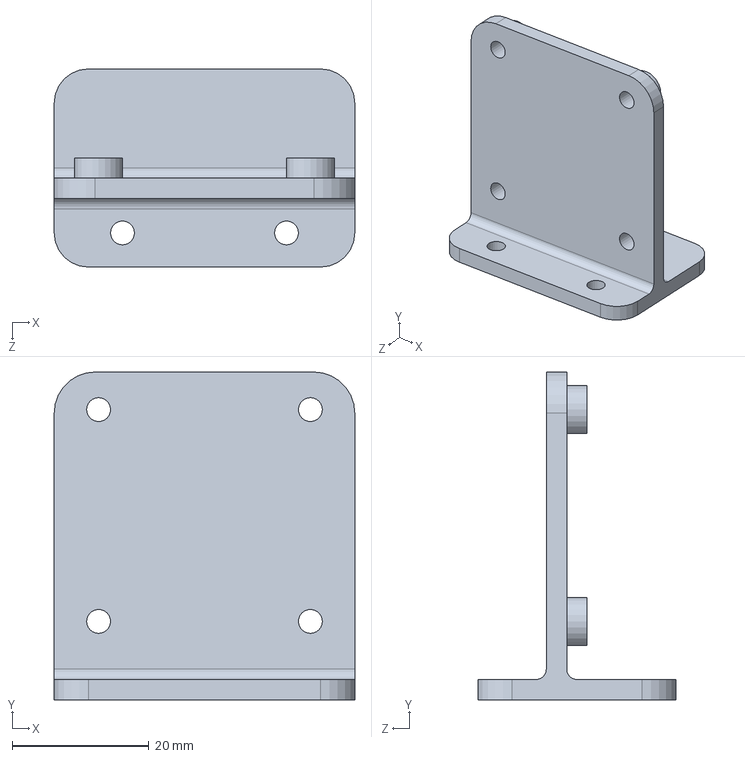
[picture p123: CAD file, 2026-11-06]
GrupoChasis/01_Chasis/01_Chasis_ControladoraSoporte.SLDPRT
44.0 x 48.0 x 29.0 mm
