Wassau/G1_Project_Rover2026/GrupoDirección/Diseñov12/VarillaMovil.SLDPRT

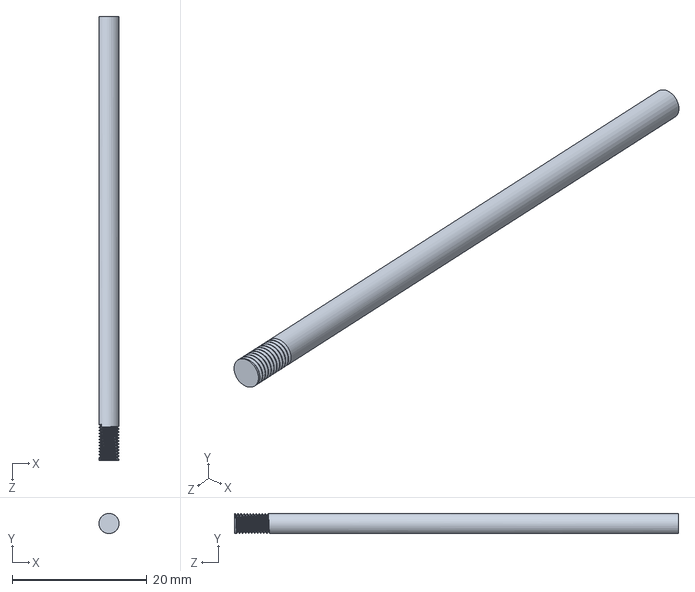
[picture p124: CAD file, 2026-11-05]
GrupoDirección/Diseñov12/VarillaMovil.SLDPRT
3.00 x 3.00 x 66.0 mm
