Wassau/G1_Project_Rover2026/GrupoChasis/01_Chasis/PCB_Alim.SLDPRT

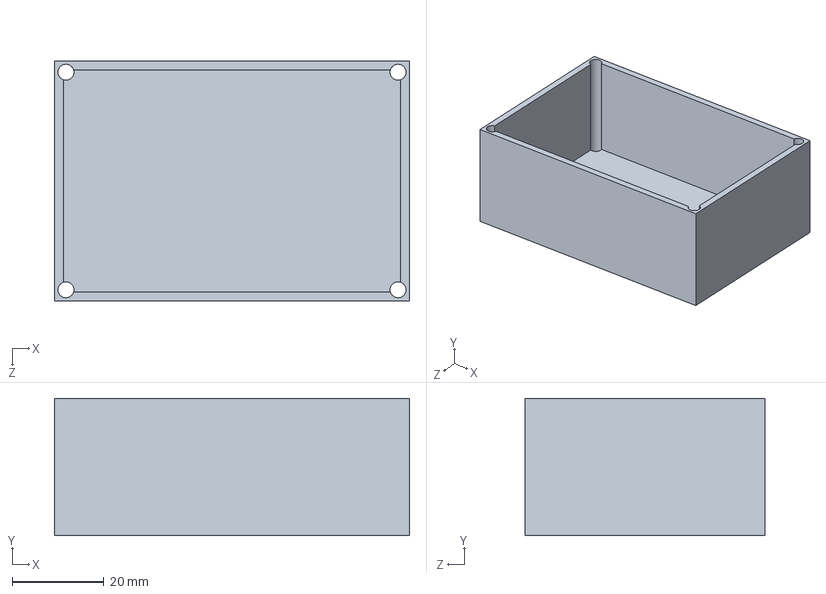
[picture p125: CAD file, 2026-11-06]
GrupoChasis/01_Chasis/PCB_Alim.SLDPRT
77.5 x 30.0 x 52.5 mm
