Wassau/G1_Project_Rover2026/GrupoDirección/Diseñov12/VarillaServo.SLDPRT

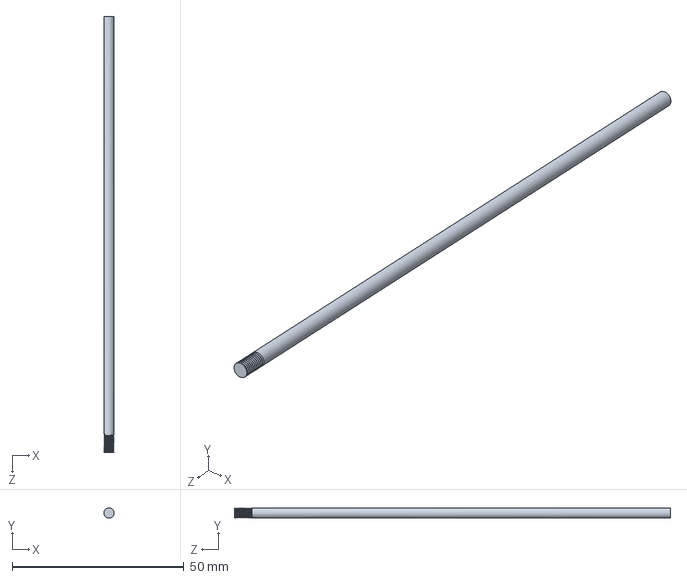
[picture p126: CAD file, 2026-11-05]
GrupoDirección/Diseñov12/VarillaServo.SLDPRT
3.00 x 3.00 x 127.0 mm
