Wassau/G1_Project_Rover2026/GrupoChasis/01_Chasis/01_Chasis_ChapaBase_V02.SLDPRT

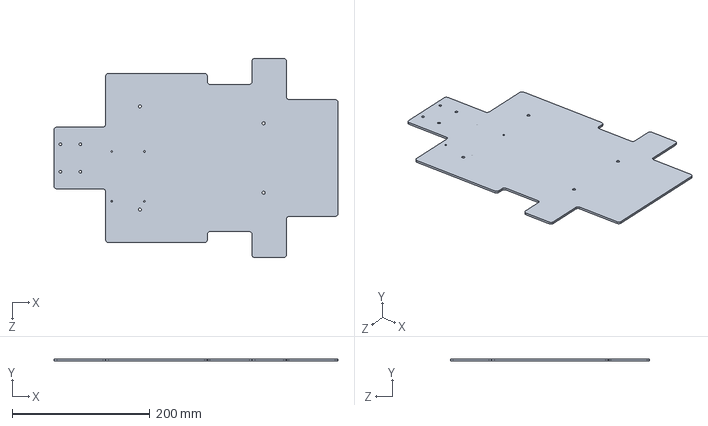
[picture p127: CAD file, 2026-11-06]
GrupoChasis/01_Chasis/01_Chasis_ChapaBase_V02.SLDPRT
413.0 x 3.00 x 290.0 mm
