Wassau/G1_Project_Rover2026/GrupoDirección/Diseñov6/adaptador_hex17_estandar_rosca.step

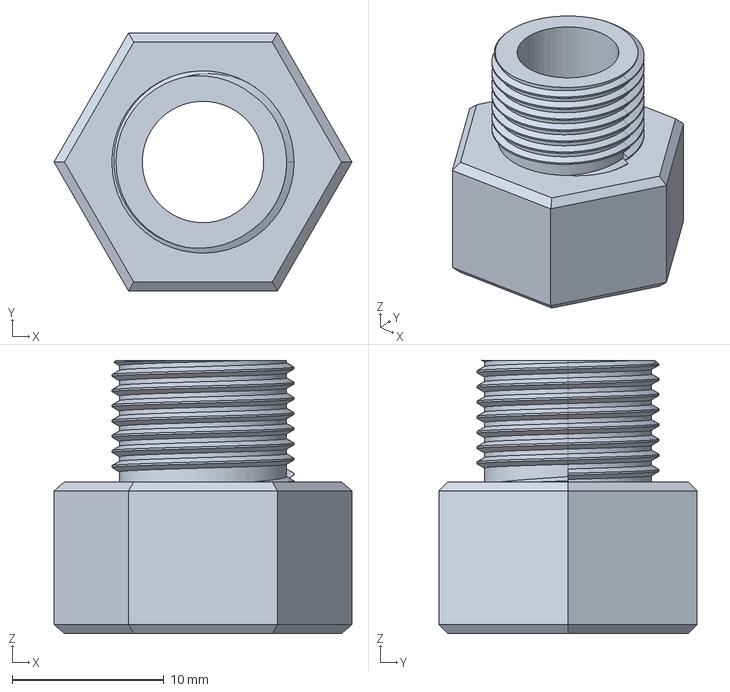
[picture p128: CAD file, 2026-10-27]
GrupoDirección/Diseñov6/adaptador_hex17_estandar_rosca.step
19.6 x 17.0 x 18.0 mm
