Wassau/G1_Project_Rover2026/GrupoChasis/01_Chasis/01_Chasis_Puerta_Trasera.SLDPRT

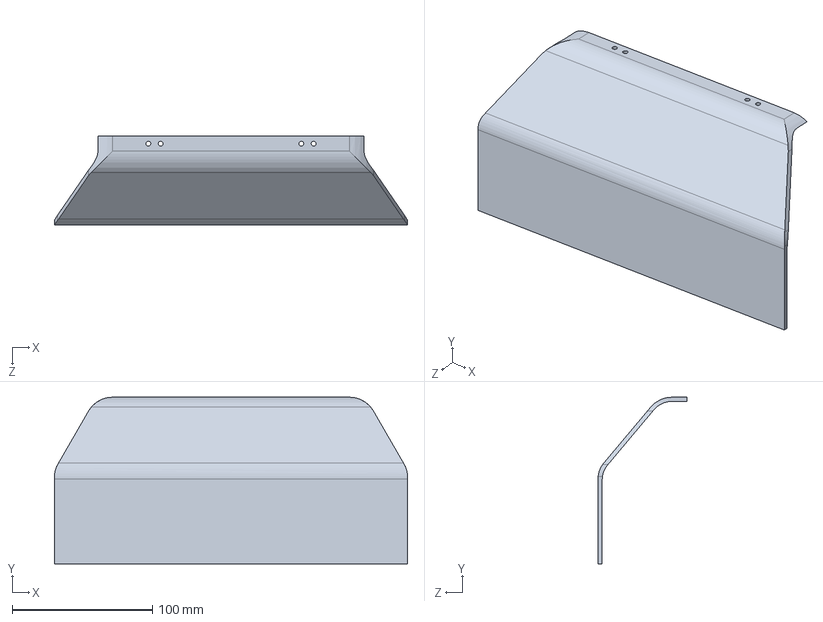
[picture p129: CAD file, 2026-11-06]
GrupoChasis/01_Chasis/01_Chasis_Puerta_Trasera.SLDPRT
252.0 x 119.0 x 63.6 mm
