Wassau/G1_Project_Rover2026/GrupoDirección/Diseñov12/SoporteServo.SLDPRT

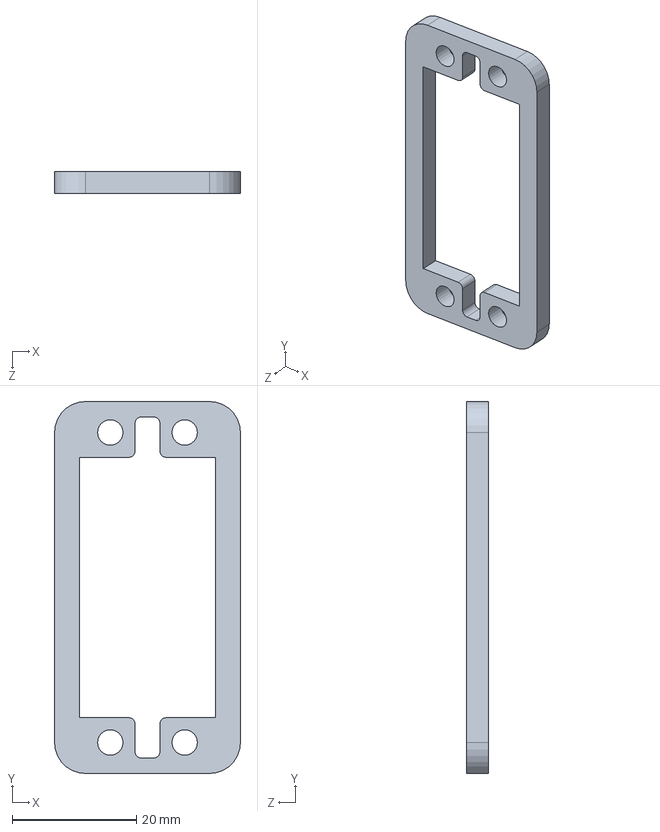
[picture p130: CAD file, 2026-11-05]
GrupoDirección/Diseñov12/SoporteServo.SLDPRT
30.0 x 60.0 x 3.62 mm
