Wassau/G1_Project_Rover2026/GrupoDirección/Diseñov12/EjeMangueta.SLDPRT

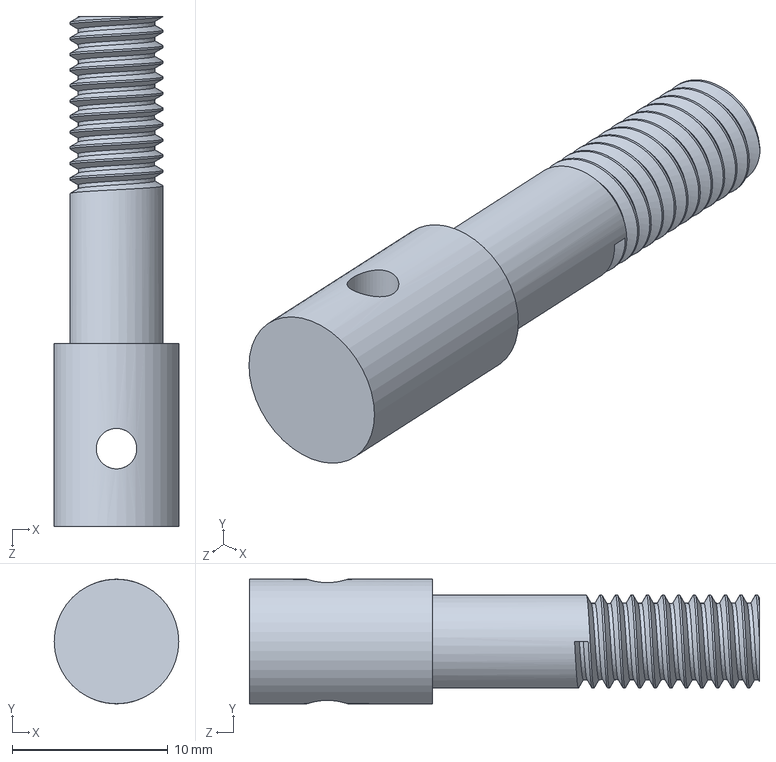
[picture p131: CAD file, 2026-11-05]
GrupoDirección/Diseñov12/EjeMangueta.SLDPRT
8.00 x 8.00 x 32.8 mm
