Wassau/G1_Project_Rover2026/GrupoChasis/01_Chasis/01_Chasis_FPGASoporte.SLDPRT

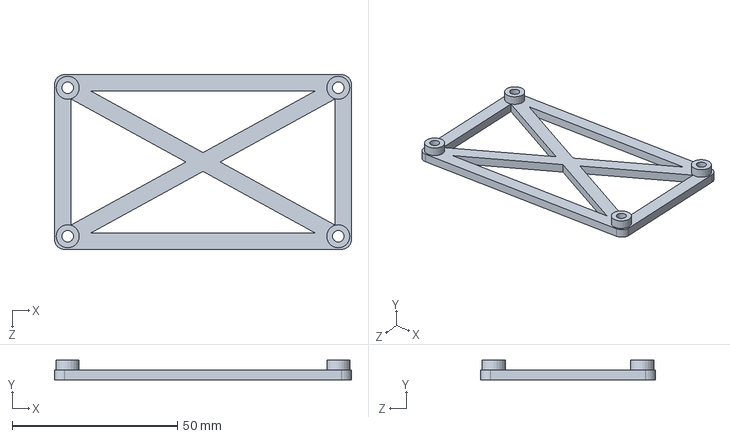
[picture p132: CAD file, 2026-11-06]
GrupoChasis/01_Chasis/01_Chasis_FPGASoporte.SLDPRT
90.0 x 6.00 x 53.0 mm
