Wassau/G1_Project_Rover2026/GrupoChasis/01_Chasis/USB.SLDPRT

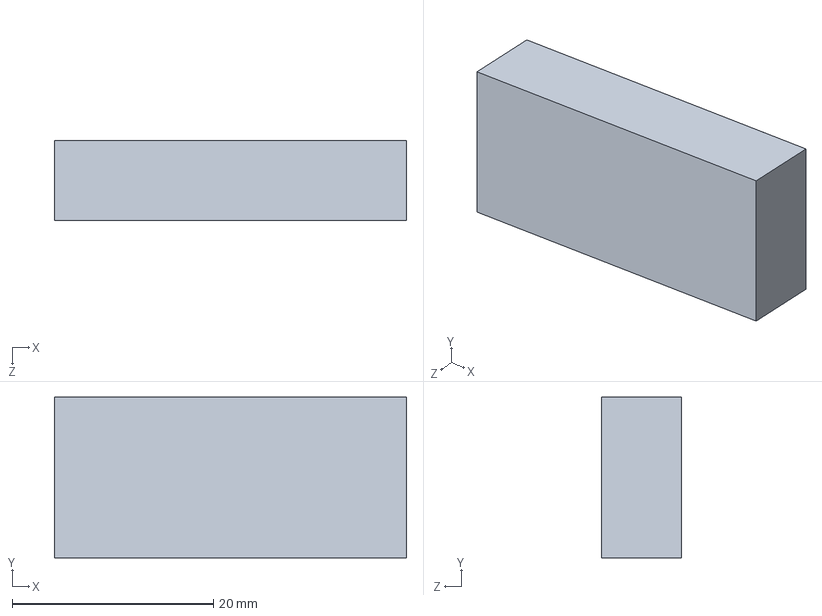
[picture p133: CAD file, 2026-11-05]
GrupoChasis/01_Chasis/USB.SLDPRT
35.0 x 16.0 x 8.00 mm
