Wassau/G1_Project_Rover2026/GrupoChasis/01_Chasis/01_Chasis_SoporteBateria_V02.SLDPRT

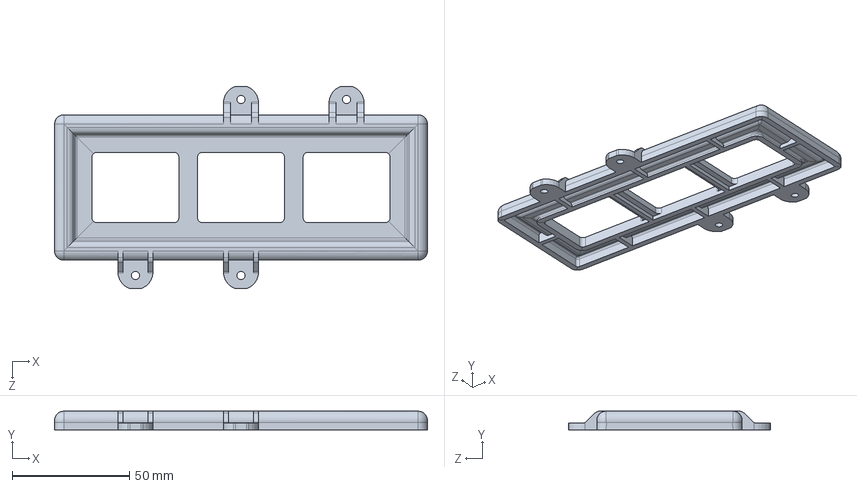
[picture p134: CAD file, 2026-11-05]
GrupoChasis/01_Chasis/01_Chasis_SoporteBateria_V02.SLDPRT
159.0 x 8.00 x 86.0 mm
