Wassau/G1_Project_Rover2026/GrupoChasis/01_Chasis/01_Chasis_SoporteReductora_Base_M2_V03.SLDPRT

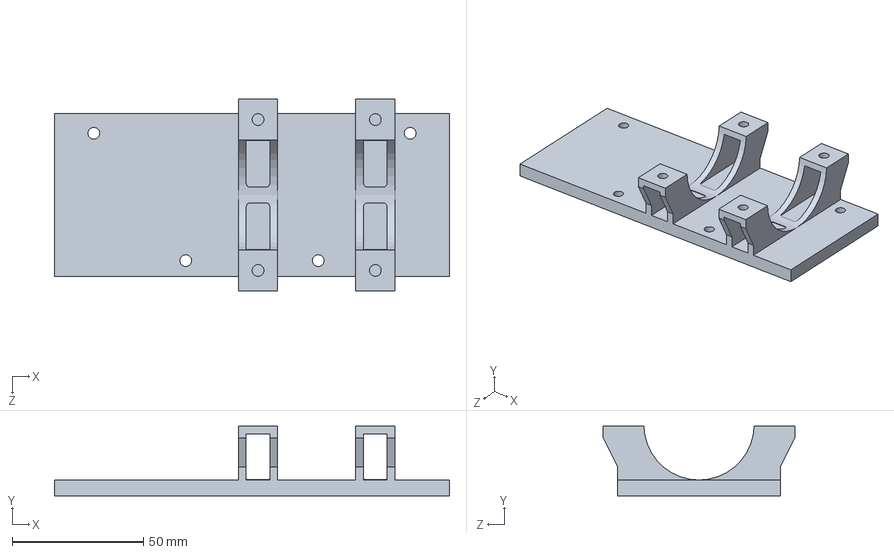
[picture p135: CAD file, 2026-11-05]
GrupoChasis/01_Chasis/01_Chasis_SoporteReductora_Base_M2_V03.SLDPRT
150.5 x 26.5 x 73.0 mm
