Wassau/G1_Project_Rover2026/GrupoDirección/Diseñov12/Rueda_Buje.SLDPRT

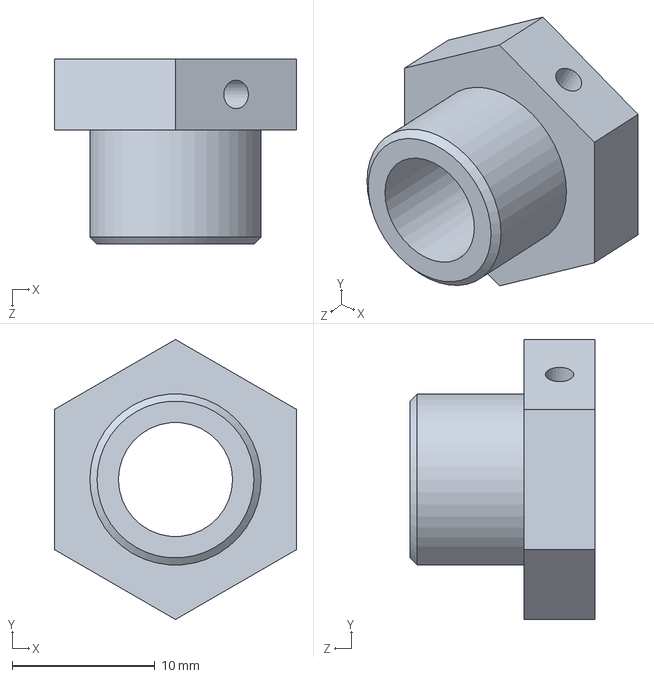
[picture p136: CAD file, 2026-11-04]
GrupoDirección/Diseñov12/Rueda_Buje.SLDPRT
17.0 x 19.6 x 13.0 mm
