Wassau/G1_Project_Rover2026/GrupoDirección/Diseñov12/Mangueta.SLDPRT

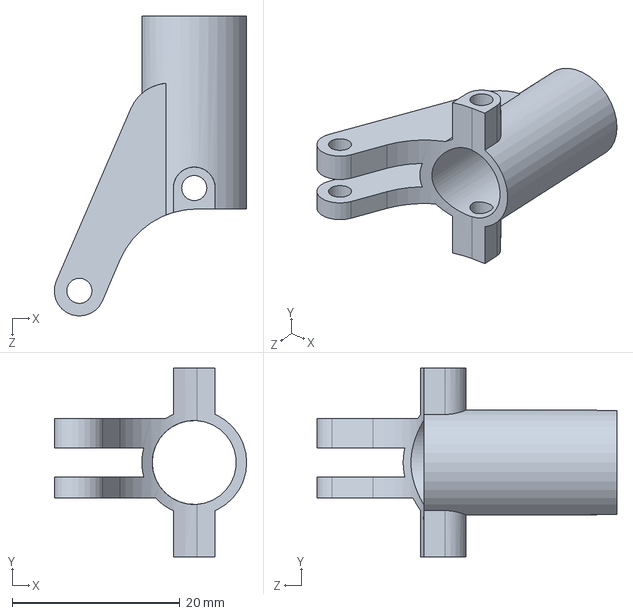
[picture p137: CAD file, 2026-11-04]
GrupoDirección/Diseñov12/Mangueta.SLDPRT
22.9 x 22.5 x 35.8 mm
