Wassau/G1_Project_Rover2026/GrupoChasis/01_Chasis/PCB_FPGA.SLDPRT

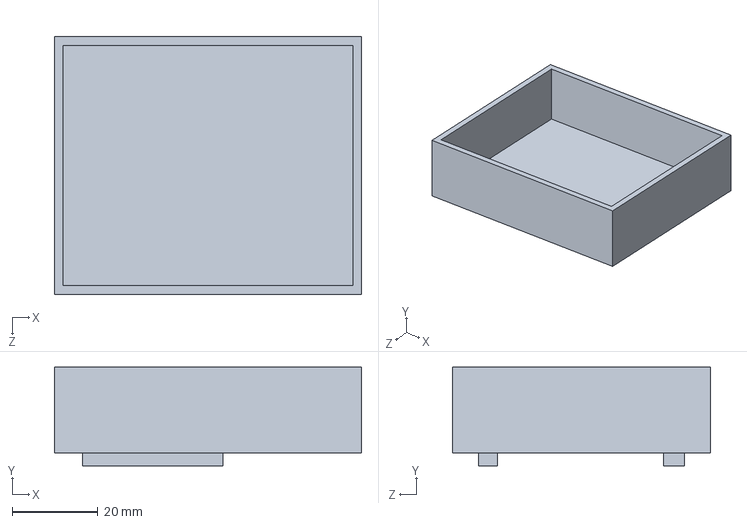
[picture p138: CAD file, 2026-11-05]
GrupoChasis/01_Chasis/PCB_FPGA.SLDPRT
71.5 x 23.0 x 60.0 mm
