Wassau/G1_Project_Rover2026/GrupoChasis/01_Chasis/01_Chasis_BidaBateria.SLDPRT

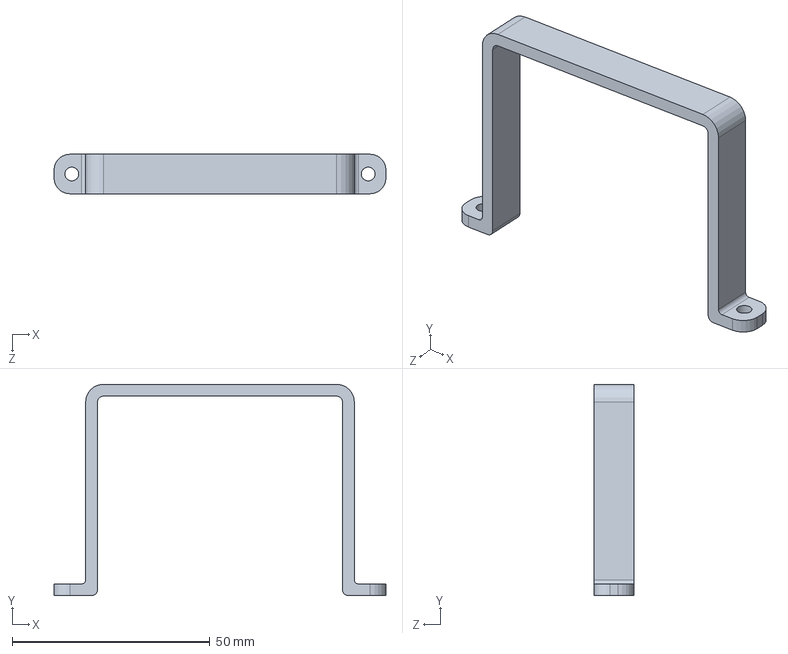
[picture p139: CAD file, 2026-11-05]
GrupoChasis/01_Chasis/01_Chasis_BidaBateria.SLDPRT
84.0 x 53.5 x 10.0 mm
