Wassau/G1_Project_Rover2026/GrupoChasis/01_Chasis/Eje_Rueda.SLDPRT

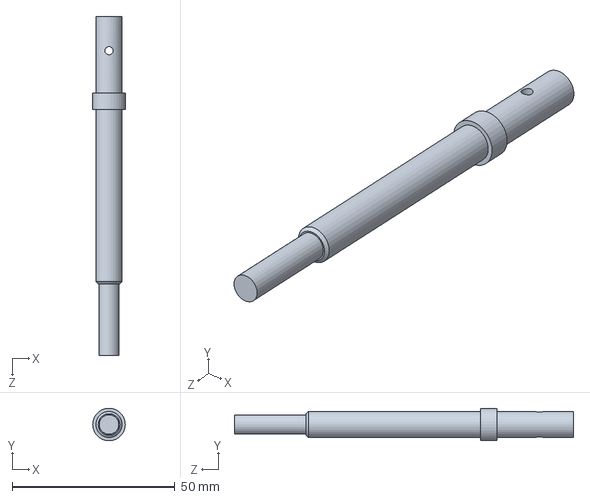
[picture p140: CAD file, 2026-11-05]
GrupoChasis/01_Chasis/Eje_Rueda.SLDPRT
10.0 x 9.96 x 104.0 mm
