Wassau/G1_Project_Rover2026/GrupoChasis/01_Chasis/ChapaAluminio.SLDPRT

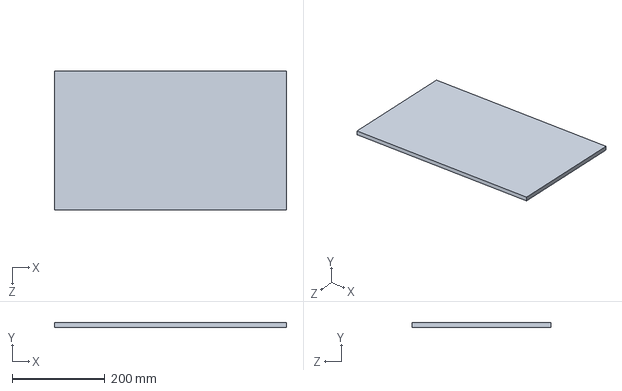
[picture p141: CAD file, 2026-11-04]
GrupoChasis/01_Chasis/ChapaAluminio.SLDPRT
500.0 x 10.0 x 300.0 mm
