Wassau/G1_Project_Rover2026/GrupoChasis/01_Chasis/Soporte_EjeRueda_V02.SLDPRT

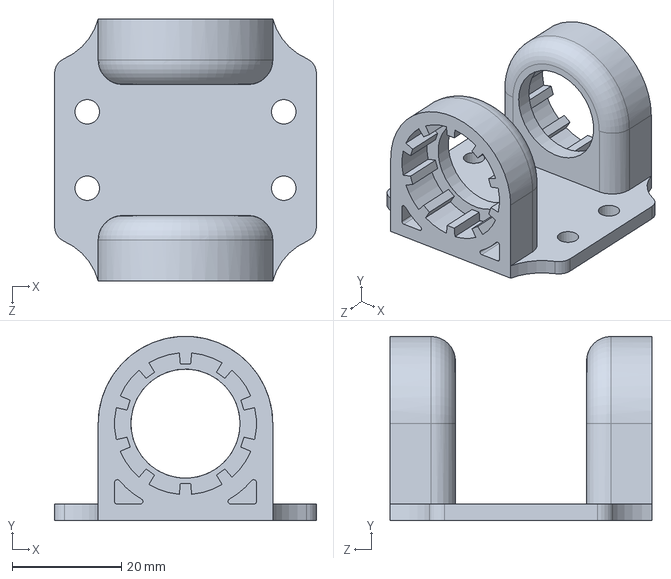
[picture p142: CAD file, 2026-11-04]
GrupoChasis/01_Chasis/Soporte_EjeRueda_V02.SLDPRT
48.0 x 33.7 x 48.0 mm
