Wassau/G1_Project_Rover2026/GrupoChasis/01_Chasis/01_Chasis_Mastil.SLDPRT

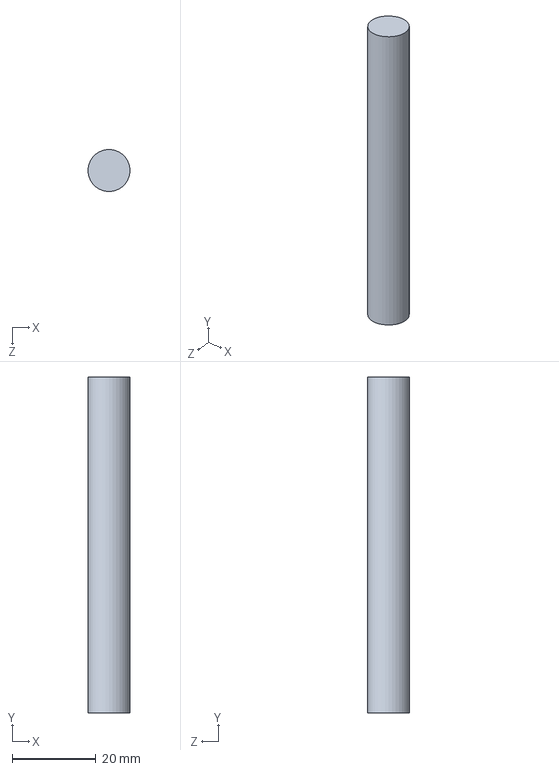
[picture p143: CAD file, 2026-11-04]
GrupoChasis/01_Chasis/01_Chasis_Mastil.SLDPRT
10.0 x 80.0 x 10.0 mm
