Wassau/G1_Project_Rover2026/GrupoChasis/01_Chasis/01_Chasis_bisagra_B.SLDPRT

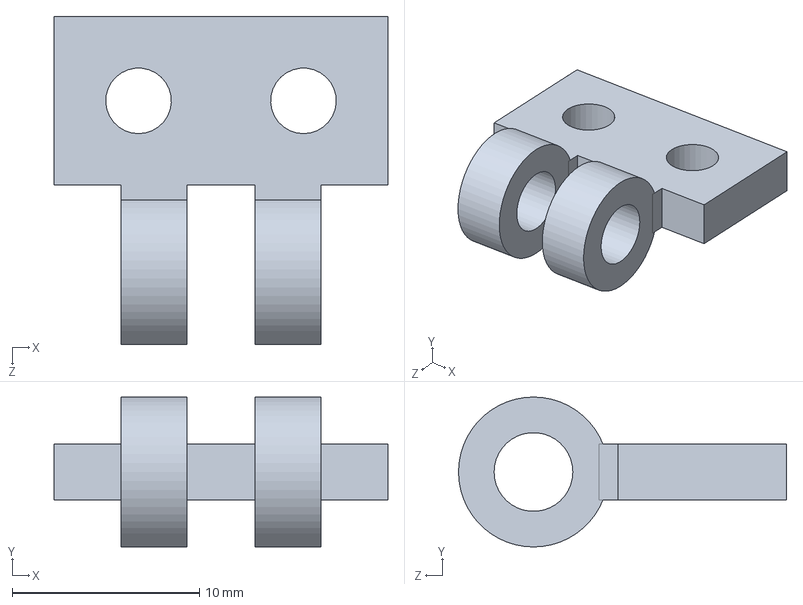
[picture p144: CAD file, 2026-11-03]
GrupoChasis/01_Chasis/01_Chasis_bisagra_B.SLDPRT
17.8 x 8.00 x 17.5 mm
