Wassau/G1_Project_Rover2026/GrupoChasis/01_Chasis/01_Chasis_Ensamblaje_V08.SLDASM

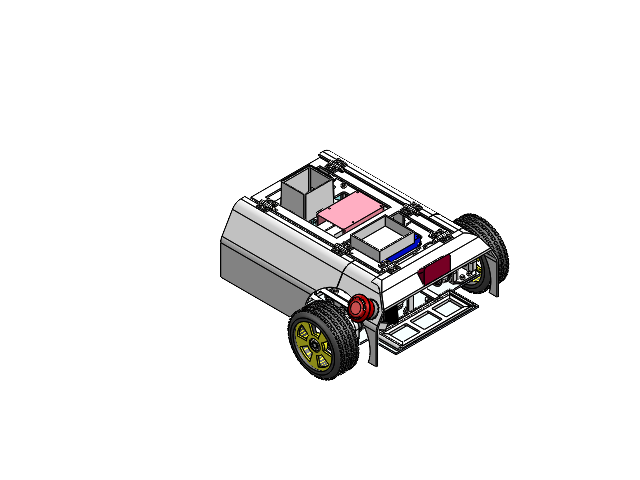
[picture p145: CAD file, 2026-11-11]
GrupoChasis/01_Chasis/01_Chasis_Ensamblaje_V08.SLDASM
01_Chasis_ChapaBase_V02
01_Chasis_ChapaSuperior
01_Chasis_MarcoCarcasa
DB42Sxx.stp x 2
GP42-N2-XX-SRR_V02 x 2
21 T5 _ 12-2 x 2
21 T5 _ 18-2 x 2
Eje_Rueda x 2
CAA-608ZZ-JJ x 4
Rueda_Buje x 2
socket head cap screw_din x 108
01_Chasis_SoporteBateria_V02
Soporte_EjeRueda_V02 x 2
llanta_1_8_aprox x 2
neumatico_1_8_aprox x 2
01_Chasis_SoporteReductora_Base_V03
hex nut style 1 gradeab_bsi x 68
01_Chasis_SoporteReductora_Brida_V03 x 4
01_Chasis_Guia_SoporteReductora_V05 x 4
01_Chasis_SoporteReductora_Base_M2_V03
01_Chasis_Puerta_Trasera
01_Chasis_Puerta_Lateral
01_Chasis_Puerta_Fijo_Lateral
01_Chasis_bisagra_A x 6
01_Chasis_bisagra_B x 6
PCB_FPGA
PCB_Alim
Controladora x 2
Carcasa_Raspberry
Router
FPGA
Separador_Hexagonal x 4
plain washer normal grade a_iso x 8
hex thin nut chamfered gradeab_bsi
SoporteServo
USB x 4
01_Chasis_BidaBateria
01_Chasis_ControladoraSoporte x 2
01_Chasis_RouterSoporte
01_Chasis_FPGASoporte
01_Chasis_RaspberrySoporte
01_Chasis_PCBAlimSoporte
M5STACK
NP8-ZS.stp x 2
01_Chasis_SetaSporte
Simetría01_Chasis_Puerta_Lateral
Simetría01_Chasis_Puerta_Fijo_Lateral
Correa5-1
Correa6-2
