Wassau/G1_Project_Rover2026/GrupoDirección/Diseñov6/wheel-robot-1.snapshot.3/Wheel/Robot Wheel.SLDASM

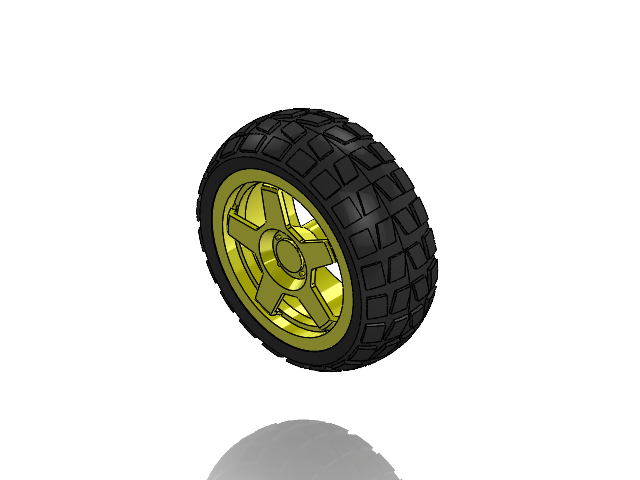
[picture p146: CAD file, 2026-10-27]
GrupoDirección/Diseñov6/wheel-robot-1.snapshot.3/Wheel/Robot Wheel.SLDASM
Velg
Tire
