Wassau/G1_Project_Rover2026/GrupoSensor/03Conjunto/Conjunto.SLDASM

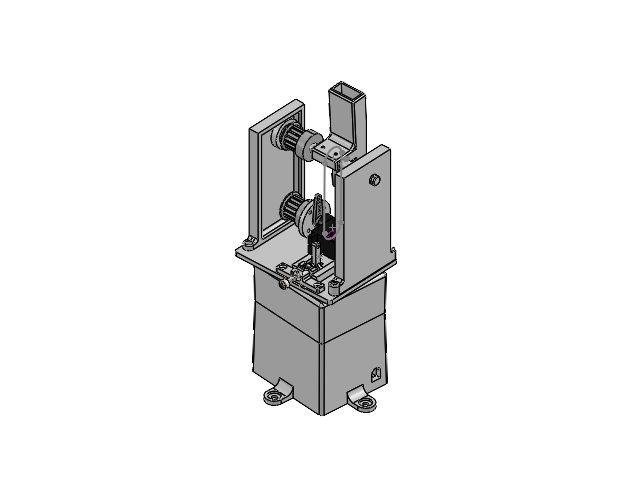
[picture p147: CAD file, 2026-11-04]
GrupoSensor/03Conjunto/Conjunto.SLDASM
Axe.step x 2
base001.step x 2
etiquette.step x 2
Tube.step x 2
Cylindre.step x 2
Tube001.step x 2
Tube002.step x 2
etiquette001.step x 2
Cylindre001.step x 2
Cylindre002.step x 2
SoporteServo
MG90S Servo Horn (4 spork).step
AcoplamientoCircular
Tapa
Eje
BaseGiratoriav2
6mmX6mmCoupler
instrument ball bearing_68_iso x 4
EjeTopv2
CamaraCarcasa-3
OrejetaDchv2
OrejetaIzqv2
Polea16T x 2
Horn Circularv2
MG90S Servo Horn (1 spork).step
ApoyoServoTensor
Tensor
hex nut style 1 gradeab_iso
socket head cap screw_iso
hex tapping screws_iso
