Wassau/G1_Project_Rover2026/GrupoChasis/01_Chasis/.Versiones Anteriores/01_Chasis_Ensamblaje_V02.SLDASM

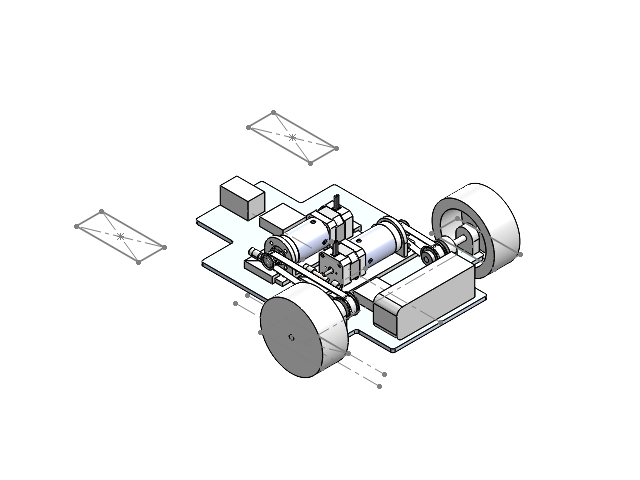
[picture p148: CAD file, 2026-10-27]
GrupoChasis/01_Chasis/.Versiones Anteriores/01_Chasis_Ensamblaje_V02.SLDASM
01_Chasis_ChapaBase_V02
DB42Sxx.stp x 2
GP42-N2-XX-SRR.stp x 2
21 T5 _ 12-2 x 2
21 T5 _ 18-2 x 2
Rueda x 2
Bateria
Soporte_EjeRueda x 4
Eje_Rueda x 2
Soporte_Reductora x 2
01_Chasis_Guia_SoporteReductora x 2
socket head cap screw_din x 4
hex nut style 1 gradeab_bsi2
Balancin
Controladora x 2
Correa2-2^01_Chasis_Ensamblaje_V02
Correa3-3^01_Chasis_Ensamblaje_V02
