Wassau/G1_Project_Rover2026/GrupoSensor/03Conjunto/MG90S.SLDASM

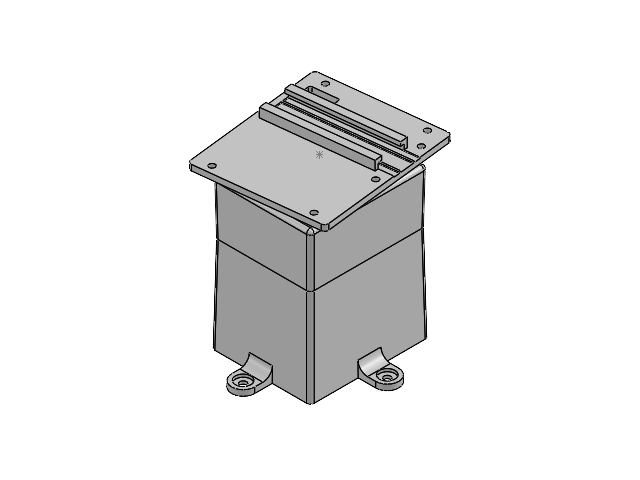
[picture p149: CAD file, 2026-11-04]
GrupoSensor/03Conjunto/MG90S.SLDASM
Axe.step
base001.step
etiquette.step
Tube.step
Cylindre.step
Tube001.step
Tube002.step
etiquette001.step
Cylindre001.step
Cylindre002.step
SoporteServo
MG90S Servo Horn (4 spork).step
AcoplamientoCircular
Tapa
Eje
BaseGiratoriav2
6mmX6mmCoupler
instrument ball bearing_68_iso x 2
