Wassau/G1_Project_Rover2026/GrupoDirección/Diseñov12/rotula_M3_10mm.SLDASM

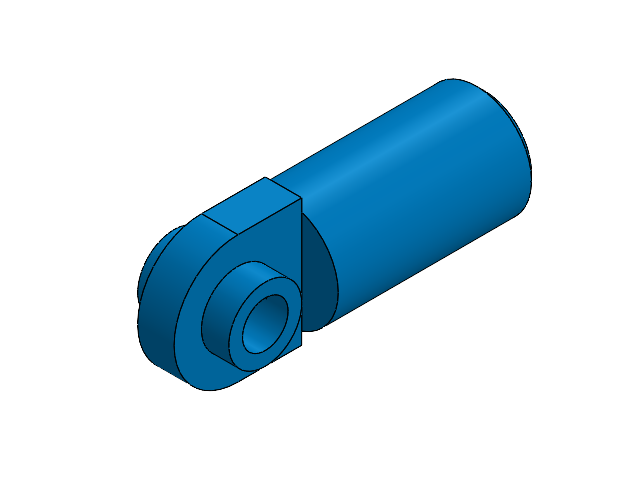
[picture p150: CAD file, 2026-11-05]
GrupoDirección/Diseñov12/rotula_M3_10mm.SLDASM
cuerpo_rotula.step
casquillo.step
