Wassau/G1_Project_Rover2026/GrupoSensor/03Conjunto/TopEnsamblajev2.SLDASM

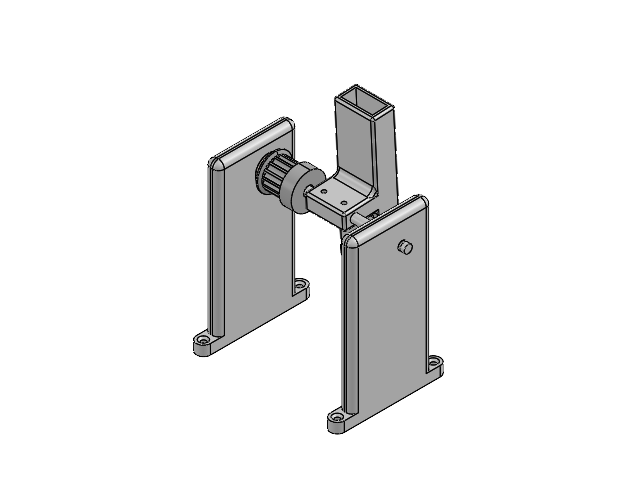
[picture p151: CAD file, 2026-11-04]
GrupoSensor/03Conjunto/TopEnsamblajev2.SLDASM
EjeTopv2
CamaraCarcasa-3
OrejetaDchv2
OrejetaIzqv2
instrument ball bearing_68_iso x 2
Polea16T
