Wassau/G1_Project_Rover2026/GrupoSensor/03Conjunto/TopEnsamblaje.SLDASM

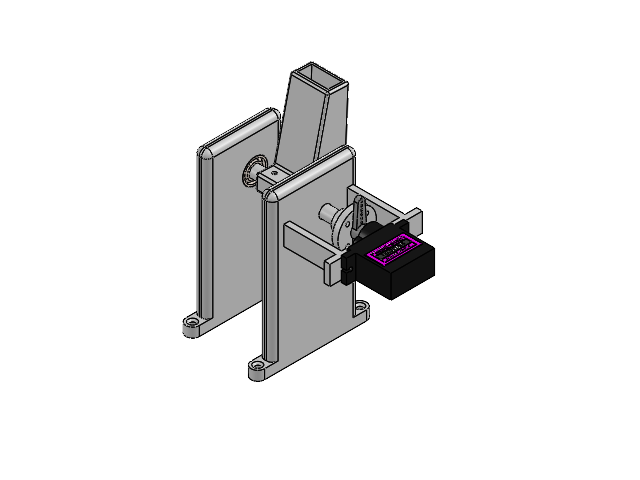
[picture p152: CAD file, 2026-11-03]
GrupoSensor/03Conjunto/TopEnsamblaje.SLDASM
Axe.step
base001.step
etiquette.step
Tube.step
Cylindre.step
Tube001.step
Tube002.step
etiquette001.step
Cylindre001.step
Cylindre002.step
MG90S Servo Horn (2 spork).step
AcoplamientoCircularv2
EjeTop
CamaraCarcasa-2
circlip for shafts normal_din
OrejetaDch
OrejetaIzq
instrument ball bearing_68_iso x 2
