Wassau/G1_Project_Rover2026/GrupoSensor/02Top/TopEnsamblaje.SLDASM

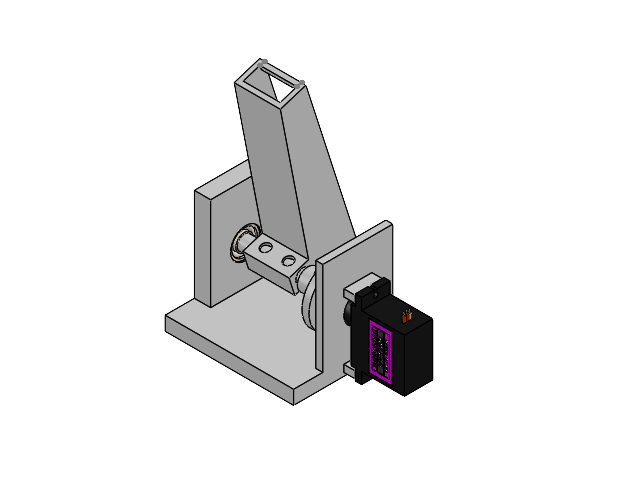
[picture p153: CAD file, 2026-10-27]
GrupoSensor/02Top/TopEnsamblaje.SLDASM
Axe.step
base001.step
etiquette.step
Tube.step
Cylindre.step
Tube001.step
Tube002.step
etiquette001.step
Cylindre001.step
Cylindre002.step
MG90S Servo Horn (2 spork).step
Horn Circular
EjeTop
CamaraCarcasa
angular contact ball bearing_68_iso
circlip for shafts normal_din
BaseGiratoriaTop
