Wassau/G1_Project_Rover2026/GrupoSensor/03Conjunto/ServoTopEnsamblaje.SLDASM

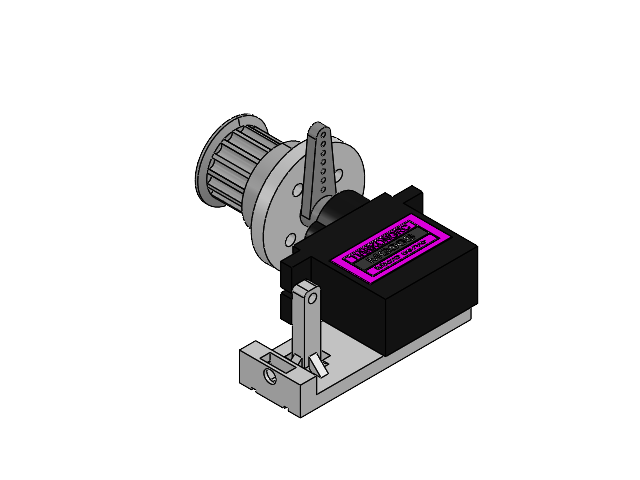
[picture p154: CAD file, 2026-11-02]
GrupoSensor/03Conjunto/ServoTopEnsamblaje.SLDASM
Axe.step
base001.step
etiquette.step
Tube.step
Cylindre.step
Tube001.step
Tube002.step
etiquette001.step
Cylindre001.step
Cylindre002.step
Horn Circularv2
Polea16T
MG90S Servo Horn (1 spork).step
ApoyoServoTensor
