Wassau/G1_Project_Rover2026/MODELOS COMPONENTES COMERCIALES/Ensamblaje_MotorReductora.SLDASM

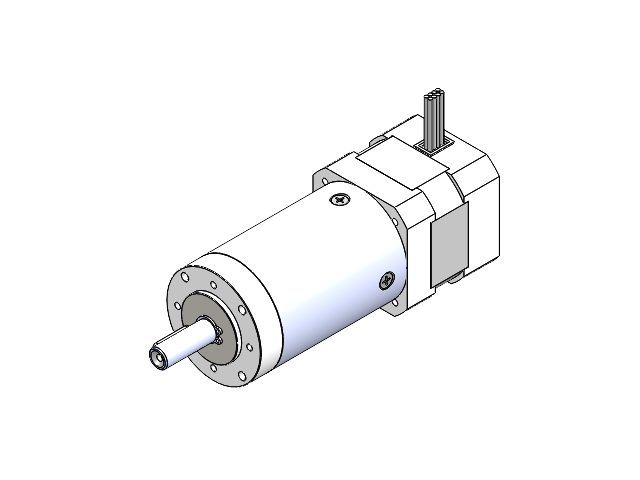
[picture p155: CAD file, 2026-10-17]
MODELOS COMPONENTES COMERCIALES/Ensamblaje_MotorReductora.SLDASM
DB42Sxx.stp
GP42-N2-XX-SRR.stp
