Wassau/G1_Project_Rover2026/GrupoDirección/Diseñov12/EnsamblajeDireccion.SLDASM

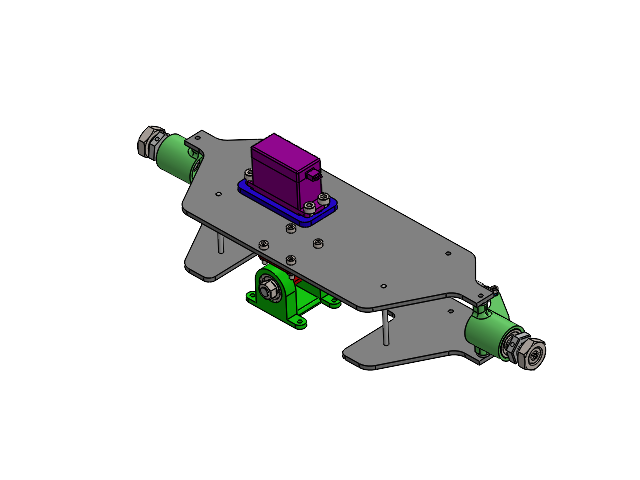
[picture p156: CAD file, 2026-11-05]
GrupoDirección/Diseñov12/EnsamblajeDireccion.SLDASM
ChapaSuperior
ChapaInferior
Servo DS3218MG[1]
Axis Servo[1]
Lever 25T[1]
VarillaServo
ManguetaDerecha x 2
VarillaMovil2
VarillaMovil
EjeChapa x 2
adaptador_hex17_estandar_rosca x 2
EjeMangueta x 2
radial ball bearing_68_iso x 6
SoporteServo
cuerpo_rotula.step x 4
casquillo.step x 4
socket head cap screw_iso x 10
pan head cross recess screw_iso
hex nut style 1 gradeab_iso x 11
SoporteBalancinSuperior
hex thin nut chamfered gradeab_iso x 6
ConjuntoBalancinInferior
EjeBalancin
casquillo_RS529004v2PART x 4
