Wassau/G1_Project_Rover2026/GrupoChasis/01_Chasis/Tensor.SLDASM

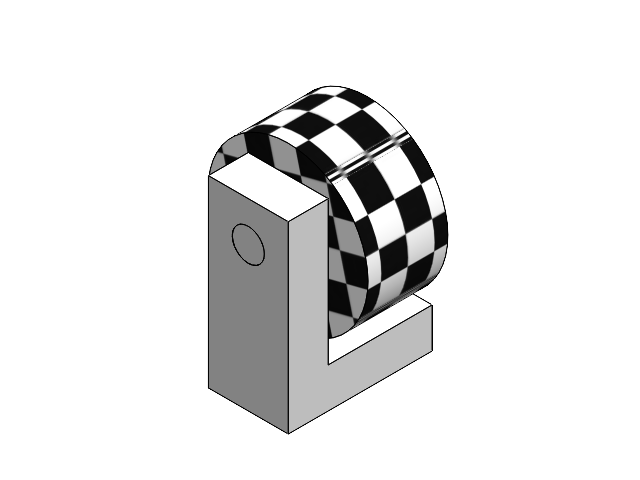
[picture p157: CAD file, 2026-10-17]
GrupoChasis/01_Chasis/Tensor.SLDASM
Tensor_int
Tensor_pin
Tensor_soporte
Tensor_ext
