Wassau/G1_Project_Rover2026/GrupoChasis/01_Chasis/Diferencial.SLDASM

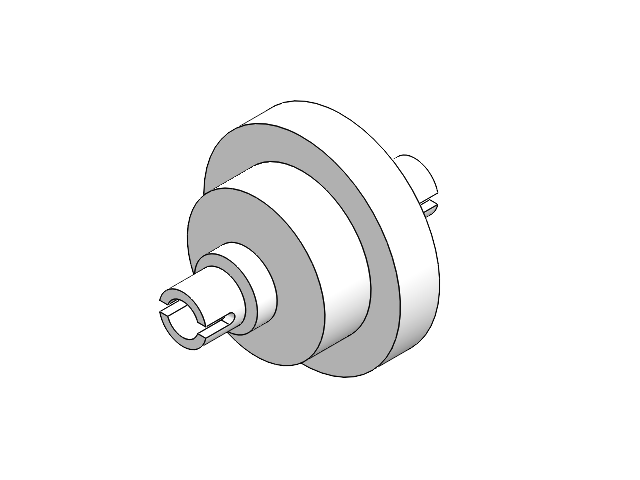
[picture p158: CAD file, 2026-10-17]
GrupoChasis/01_Chasis/Diferencial.SLDASM
Corona_Diff
Rodamiento_Transmision x 2
Cubo_Diff
Eje_Diff
