Wassau/G1_Project_Rover2026/(list of files, cad)

Other CAD files:
MODELOS COMPONENTES COMERCIALES/Seta Emergencia/Seta_Emergencia.SLDASM
GrupoDirección/Diseñov6/Rotula.SLDASM
GrupoDirección/Diseñov12/SubconjuntoVarilla.SLDASM
GrupoDirección/Diseñov11/RUEDAv3/RUEDAv2/llanta_1_8_aprox.step
GrupoDirección/Diseñov3/Servo.SLDPRT
GrupoDirección/Diseñov8/RUEDA/llanta_1_8_aprox.step
GrupoDirección/Diseñov9/RUEDAv2/llanta_1_8_aprox.SLDPRT
MODELOS COMPONENTES COMERCIALES/3dfindit-HEFA-CAA-608ZZ-JJ-0202610241748568784752410e898ce/CAA-608ZZ-JJ.sldprt
MODELOS COMPONENTES COMERCIALES/rc-short-course-tire-rim-1-10-scale-off-road-12mm-hex-1.snapshot.1/wheel110.step
GrupoDirección/Diseñov12/RUEDA/rueda_1_8_aprox.step
GrupoDirección/Diseñov12/RUEDAv2/neumatico_1_8_aprox.SLDPRT
GrupoDirección/Diseñov12/servo-ds3218mg-2.snapshot.4/Part Studio 1.step
MODELOS COMPONENTES COMERCIALES/RUEDAv2/neumatico_1_8_aprox.SLDPRT
GrupoDirección/Diseñov11/ManguetaDerecha.SLDPRT
GrupoSensor/02Topv2/OrejetaIzqv2.SLDPRT
GrupoDirección/Diseñov10/Servo.SLDPRT
GrupoDirección/Diseñov12/adaptador_hex17_estandar_rosca.SLDPRT
GrupoDirección/Diseñov11/casquillo_RS529004.SLDPRT
GrupoChasis/01_Chasis/Correa6-2.SLDPRT
GrupoDirección/Diseñov12/EjeBalancin.SLDPRT
GrupoChasis/01_Chasis/Correa5-1.SLDPRT
GrupoSensor/02Topv2/CamaraCarcasa.SLDPRT
GrupoDirección/Diseñov12/Lever 25T[1].SLDPRT
GrupoDirección/Diseñov12/ChapaSuperior.SLDPRT
GrupoChasis/01_Chasis/Simetría01_Chasis_Puerta_Lateral.SLDPRT
GrupoDirección/Diseñov9/Tuerca_M12_Espesor_4mm.SLDPRT
GrupoDirección/Diseñov12/ChapaInferior.SLDPRT
GrupoDirección/Diseñov12/casquillo_RS529004v2.step
GrupoChasis/01_Chasis/01_Chasis_SoporteReductora_Base_V03.SLDPRT
GrupoChasis/01_Chasis/01_Chasis_ChapaSuperior_COPIA.SLDPRT
GrupoChasis/01_Chasis/01_Chasis_Ensamblaje.SLDASM
GrupoChasis/01_Chasis/01_Chasis_Ensamblaje_V02.SLDASM
GrupoChasis/01_Chasis/01_Chasis_Ensamblaje_V04.SLDASM
GrupoChasis/01_Chasis/01_Chasis_Ensamblaje_V05.SLDASM
GrupoChasis/01_Chasis/01_Chasis_Ensamblaje_V06.SLDASM
GrupoChasis/01_Chasis/01_Chasis_Ensamblaje_V07.SLDASM
GrupoChasis/01_Chasis/01_Chasis_Guia_SoporteReductora.SLDPRT
GrupoChasis/01_Chasis/01_Chasis_Guia_SoporteReductora_2_V03.SLDPRT
GrupoChasis/01_Chasis/01_Chasis_Guia_SoporteReductora_V03.SLDPRT
GrupoChasis/01_Chasis/01_Chasis_MarcoCarcasa_COPIA.SLDPRT
GrupoChasis/01_Chasis/01_Chasis_Separador.SLDPRT
GrupoChasis/01_Chasis/01_Chasis_SoporteReductora_Base.SLDPRT
GrupoChasis/01_Chasis/01_Chasis_SoporteReductora_Base_V02.SLDPRT
GrupoChasis/01_Chasis/01_Chasis_SoporteReductora_Brida.SLDPRT
GrupoChasis/01_Chasis/01_Chasis_SoporteReductora_Brida_V02.SLDPRT
GrupoChasis/01_Chasis/01_Chasis_bisagra_A.SLDPRT
GrupoChasis/01_Chasis/Balancin.SLDPRT
GrupoChasis/01_Chasis/Controladora.SLDPRT
GrupoChasis/01_Chasis/Correa2-4.SLDPRT
GrupoChasis/01_Chasis/Cubo_Diff.SLDPRT
GrupoChasis/01_Chasis/Eje_Diff.SLDPRT
GrupoChasis/01_Chasis/Eje_Rueda_Corto.SLDPRT
GrupoChasis/01_Chasis/PCB_Pot.SLDPRT
GrupoChasis/01_Chasis/Rodamiento_Transmision.SLDPRT
GrupoChasis/01_Chasis/Simetría01_Chasis_Puerta_Fijo_Lateral_2.SLDPRT
GrupoChasis/01_Chasis/Soporte_EjeRueda.SLDPRT
GrupoChasis/01_Chasis/Soporte_Reductora.SLDPRT
GrupoChasis/01_Chasis/Soporte_RodameintoDiff.SLDPRT
GrupoChasis/01_Chasis/Tensor_ext.SLDPRT
GrupoChasis/01_Chasis/Tensor_pin.SLDPRT
GrupoChasis/01_Chasis/Tensor_soporte.SLDPRT
GrupoChasis/01_Chasis/_Chasis_Puerta_Lateral_Sim2.SLDPRT
GrupoDirección/Diseñov10/Axis Servo[1].SLDPRT
GrupoDirección/Diseñov10/EjeBalancin.SLDPRT
GrupoDirección/Diseñov10/EjeChapa.SLDPRT
GrupoDirección/Diseñov10/EjeMangueta.SLDPRT
GrupoDirección/Diseñov10/EnsamblajeDireccion.SLDASM
GrupoDirección/Diseñov10/Lever 25T[1].SLDPRT
GrupoDirección/Diseñov10/Servo DS3218MG[1].SLDPRT
GrupoDirección/Diseñov10/Servofinal.SLDASM
GrupoDirección/Diseñov10/SoporteBalancinSuperior.SLDPRT
GrupoDirección/Diseñov10/SubconjuntoVarilla.SLDASM
GrupoDirección/Diseñov10/adaptador_hex17_estandar_rosca.SLDPRT
GrupoDirección/Diseñov11/casquillo_RS529004.stl
GrupoDirección/Diseñov12/RUEDA/rueda_1_8_aprox.SLDASM
GrupoDirección/Diseñov12/RUEDA/rueda_1_8_aprox.stl
GrupoDirección/Diseñov12/rotula_M3_10mm.SLDPRT
GrupoDirección/Diseñov12/traxxas-1942-long-rod-end-1.snapshot.2/Traxxas 1942 Long Rod End v2.f3d
GrupoDirección/Diseñov3/EnsamblajeDireccion.SLDASM
GrupoDirección/Diseñov3/RUEDAv2/RUEDA.SLDASM
GrupoDirección/Diseñov3/RUEDAv2/llanta_1_8_aprox.SLDPRT
GrupoDirección/Diseñov3/SubconjuntoVarilla.SLDASM
GrupoDirección/Diseñov3/VarillaMovil.SLDPRT
GrupoDirección/Diseñov3/VarillaServo.SLDPRT
GrupoDirección/Diseñov3/servo-ds3218mg-2.snapshot.4/Axis Servo[1].SLDPRT
GrupoDirección/Diseñov3/servo-ds3218mg-2.snapshot.4/Servo DS3218MG[1].SLDPRT
GrupoDirección/Diseñov6/Axis Servo[1].SLDPRT
GrupoDirección/Diseñov6/ChapaInferior.SLDPRT
GrupoDirección/Diseñov6/ChapaSuperior.SLDPRT
GrupoDirección/Diseñov6/EjeChapa.SLDPRT
GrupoDirección/Diseñov6/EjeMangueta.SLDPRT
GrupoDirección/Diseñov6/EnsamblajeDireccion.SLDASM
GrupoDirección/Diseñov6/Lever 25T[1].SLDPRT
GrupoDirección/Diseñov6/ManguetaDerecha.SLDPRT
GrupoDirección/Diseñov6/Servo DS3218MG[1].SLDPRT
GrupoDirección/Diseñov6/Servofinal.SLDASM
GrupoDirección/Diseñov6/SoporteServo.SLDPRT
GrupoDirección/Diseñov6/SubconjuntoVarilla.SLDASM
GrupoDirección/Diseñov6/VarillaMovil.SLDPRT
GrupoDirección/Diseñov6/VarillaMovil2.SLDPRT
GrupoDirección/Diseñov6/VarillaServo.SLDPRT
GrupoDirección/Diseñov6/adaptador_hex17_estandar_rosca.SLDPRT
GrupoDirección/Diseñov8/Axis Servo[1].SLDPRT
GrupoDirección/Diseñov8/ChapaInferior.SLDPRT
GrupoDirección/Diseñov8/ChapaSuperior.SLDPRT
GrupoDirección/Diseñov8/ConjuntoBalancinInferior.SLDPRT
GrupoDirección/Diseñov8/EjeBalancin.SLDPRT
GrupoDirección/Diseñov8/EjeMangueta.SLDPRT
GrupoDirección/Diseñov8/EnsamblajeDireccion.SLDASM
GrupoDirección/Diseñov8/ManguetaDerecha.SLDPRT
GrupoDirección/Diseñov8/Servofinal.SLDASM
GrupoDirección/Diseñov8/SoporteServo.SLDPRT
GrupoDirección/Diseñov8/robotics-wheel-1.snapshot.4/Roda.iam
GrupoDirección/Diseñov8/rotula_M3_10mm.SLDASM
GrupoDirección/Diseñov9/ChapaInferior.SLDPRT
GrupoDirección/Diseñov9/ChapaSuperior.SLDPRT
GrupoDirección/Diseñov9/EjeBalancin.SLDPRT
GrupoDirección/Diseñov9/EjeMangueta.SLDPRT
GrupoDirección/Diseñov9/EnsamblajeDireccion.SLDASM
GrupoDirección/Diseñov9/Lever 25T[1].SLDPRT
GrupoDirección/Diseñov9/ManguetaDerecha.SLDPRT
GrupoDirección/Diseñov9/Servofinal.SLDASM
GrupoDirección/Diseñov9/SoporteServo.SLDPRT
GrupoDirección/Diseñov9/VarillaMovil2.SLDPRT
GrupoDirección/Diseñov9/VarillaServo.SLDPRT
GrupoDirección/Diseñov9/casquillo_RS529004v2PART.SLDPRT
GrupoDirección/Diseñov9/rotula_M3_10mm.SLDASM
GrupoSensor/01Bottom/M3x12.SLDPRT
MODELOS COMPONENTES COMERCIALES/3dfindit-HEFA-CAA-608ZZ-JJ-0202610241748568784752410e898ce/CAA-608ZZ-JJ.igs
MODELOS COMPONENTES COMERCIALES/Piñon_Conducido_KANA__Katayama_Chain_-M1B32-0202610121711471630727910e898ce/M1B32.igs
MODELOS COMPONENTES COMERCIALES/Seta Emergencia/NP8-ZS_SEPARADO.SLDPRT
