Wassau/G1_Project_Rover2026/GrupoDirección/Programacion Path/Proyecto_Path/main.cpp

#include <QCoreApplication>
#include <QTimer>
#include <QDebug>
#include "movimcarro.h"

int main(int argc, char *argv[])
{
    QCoreApplication a(argc, argv);

    // Set up code that uses the Qt event loop here.
    // Call QCoreApplication::quit() or QCoreApplication::exit() to quit the application.
    // A not very useful example would be including
    // #include <QTimer>
    // near the top of the file and calling
    // QTimer::singleShot(5000, &a, &QCoreApplication::quit);
    // which quits the application after 5 seconds.


    // If you do not need a running Qt event loop, remove the call
    // to QCoreApplication::exec() or use the Non-Qt Plain C++ Application template.

    return QCoreApplication::exec();
}
