Wassau/G1_Project_Rover2026/(commit log)

2026-10-10 Organización general de carpetas y proyecto
2026-10-13 Grupo encargado de dirección y trayectoria
2026-10-13 Grupo encargado de la dirección y trayectoria
2026-10-13 Add files via upload
    Síntesis dimensional sin tener en cuenta los esfuerzos. (Ver archivo de Hamza, será el definitivo)
2026-10-26 "Código Actualizado de la Interfaz"
2026-10-26 Sintesis de direccion con optimizacion
    Resultado final de la sintesis
2026-11-02 Cambios en cad del sensor + lista de materiales
2026-11-03 Materiales Chasis
2026-11-03 Actualización Materiales
2026-11-03 Cambios en tensor Sensor.
    Queda por añadir el cad actualizado del soporte de la cámara.
2026-11-03 Relación de posición.
2026-11-04 Act chasis y materiales
2026-11-04 Cambio tornillos Sensor
2026-11-04 Act materiales y chasis v7
2026-11-04 Materiales actualizacion
2026-11-04 Actualizacion CAD tornillos rosca
2026-11-05 act materiales
2026-11-11 Componentes comerciales
    Raspberry y seta Gave
