Wassau/G1_Project_Rover2026/(notices)

Notices in the files:
MODELOS COMPONENTES COMERCIALES/3dfindit-HEFA-CAA-688ZZ-JJ-0202610241739348404740810e898ce/CAA-688ZZ-JJ.igs:
Data from Parasolid IGES Translator 28.1.247, Copyright(c) 2006 Siemens S 1
PLM Software. All Rights Reserved. S 2
